fadelrio/Taller-de-circuitos/cuarto_check/Taller_de_Circuitos___Cuarto_Checkpoint.pdf

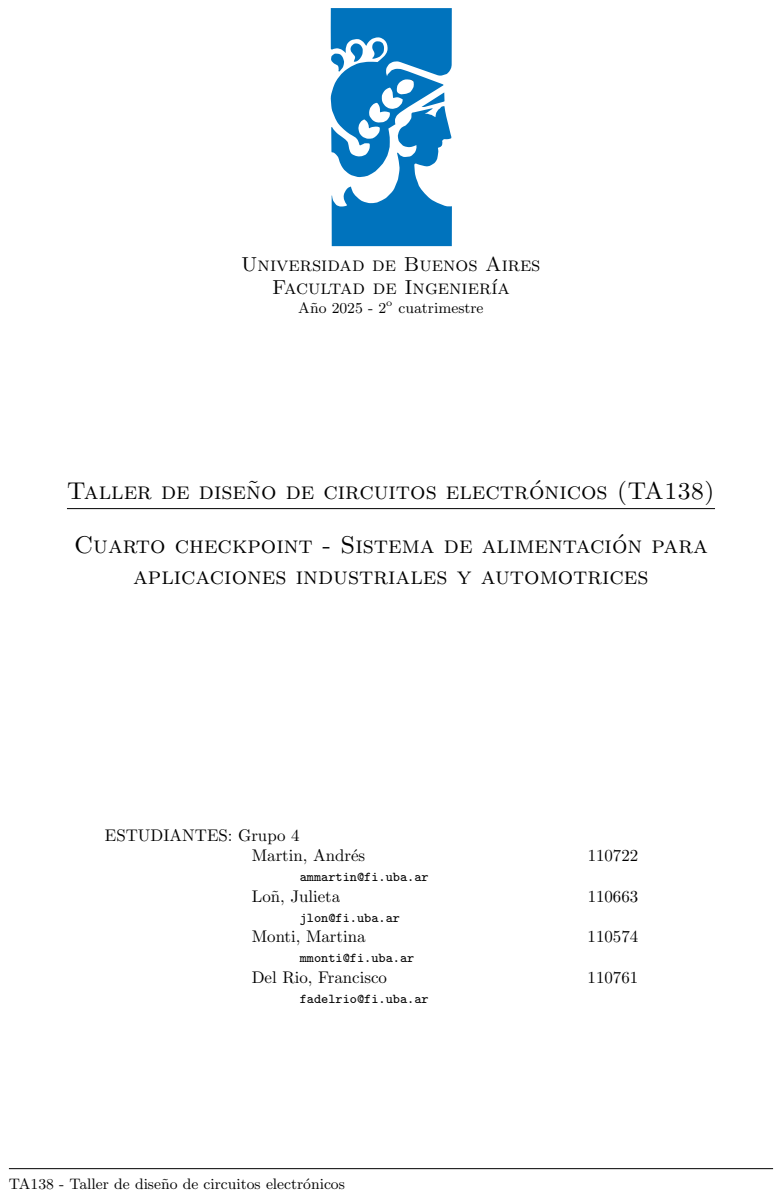
[picture p42: page 1]
cuatrimestre; Taller de diseno de circuitos electr ˜; onicos (TA138) ´; ESTUDIANTES: Grupo 4; Martin, Andrés; Loñ, Julieta; Monti, Martina; Del Rio, Francisco

Universidad de Buenos Aires

Facultad de Ingeniería

Cuarto checkpoint - Sistema de alimentacion para ´

aplicaciones industriales y automotrices

ammartin@fi.uba.ar

jlon@fi.uba.ar

mmonti@fi.uba.ar

fadelrio@fi.uba.ar

TA138 - Taller de diseño de circuitos electrónicos

TA138 - Segundo checkpoint | ÍNDICE

## Índice

1. Introducción | 2
2. Fuente buck | 2
3. Circuito PWM | 6
4. Conclusiones | 10
5. Apéndice | 11

1 Introducción | TA138 - Segundo checkpoint

## 1. Introducción

En esta entrega se realizara el diseño de la fuente buck y el circuito PWM. Para la fuente buck se deben realizar los cálculos necesarios para obtener las características físicas del inductor que se utilizara para implementar dicho circuito.
Ambos circuitos se deben diseñar teniendo en cuenta las especificaciones requeridas por el trabajo. La eficiencia para la fuente buck y la frecuencia para el PWM.

## 2. Fuente buck

### 2.1. Diseño y simulación

En las fuentes buck se busca reducir la tensión de entrada a un nivel inferior en la salida, manteniendo la alta eficiencia. Para ello se utilizan distintos componentes. Un MOSFET canal N (IRFZ44N) es utilizado para actuar como interruptor controlado por PWM (debido a este comportamiento de ”llave”, la tensión Drain-Source de este MOSFET es muy baja); el segundo NMOS (IRFZ44N) conduce la corriente cuando el primer transistor se encuentra apagado, implementando de esta manera las llaves ideales vistas en el circuito teórico.
También se agregan capacitores para evitar picos de tensión. El circuito cuenta además con un inductor, el cual almacena energía y suaviza la corriente. Este inductor debe calcularse con precisión para evitar sobrecalentamientos, tener tiempos de respuesta acordes y otros factores; es por esto que se le dedicará toda una sección a su diseño.
Para obtener el valor de la inductancia primero se calculo el mínimo valor que puede tomar para que el circuito continúe funcionando de manera adecuada. Para eso se debió considerar el caso de mayor conmutación, en donde la resistencia de carga es máxima.

Rmax =

Vo

Is,min

Considerando que Vo = 9,5V y Is,max =0,1 A se obtiene Rmax = 95Ω. Luego, el inductor se calcula mediante la siguiente expresión.

Lcr =

(1 − D)Rmax
2f

(1)

Considerando que se va a tener un Dmin y un Dmax dependiendo de la Vin se calcularon ambos:

Dmax =

Vo + Vds2

Vin − Vds1 + Vds2

=

9,5 + 0,049
12
= 0,7957 | (2)

Dmin =

Vo + Vds2

Vin − Vds1 + Vds2

=

9,5 + 0,049
30
= 0,3183 | (3)

Se calcularon dos valores de Lcr y se utilizó el más alto de ambos que es el que cumple con lo pedido y presenta el peor caso para el inductor critico. De las cuentas se obtuvo Lcr =250 µH. Sin embargo, se decidió utilizar un inductor L = 300 µH para mayor seguridad y evitar que variaciones en el valor real del inductor presenten problemas graves en el circuito implementado.
El valor del capacitor de salida se debe calcular considerando el ripple, por lo tanto el valor se calculo de manera iterativa. Se decidió un valor inicial de 100 µF y se observo el valor del ripple con ese valor para luego poder aplicar la siguiente expresión:

∆Vo =

IL,max − IL,min
8Cf | (4)

Con un capacitor de 47 µF se obtiene un ∆Vo =2,5 mV que cumple con los requisitos de tension de salida.
Una vez finalizado todo el desarrollo del circuito se consiguió el siguiente diseño.

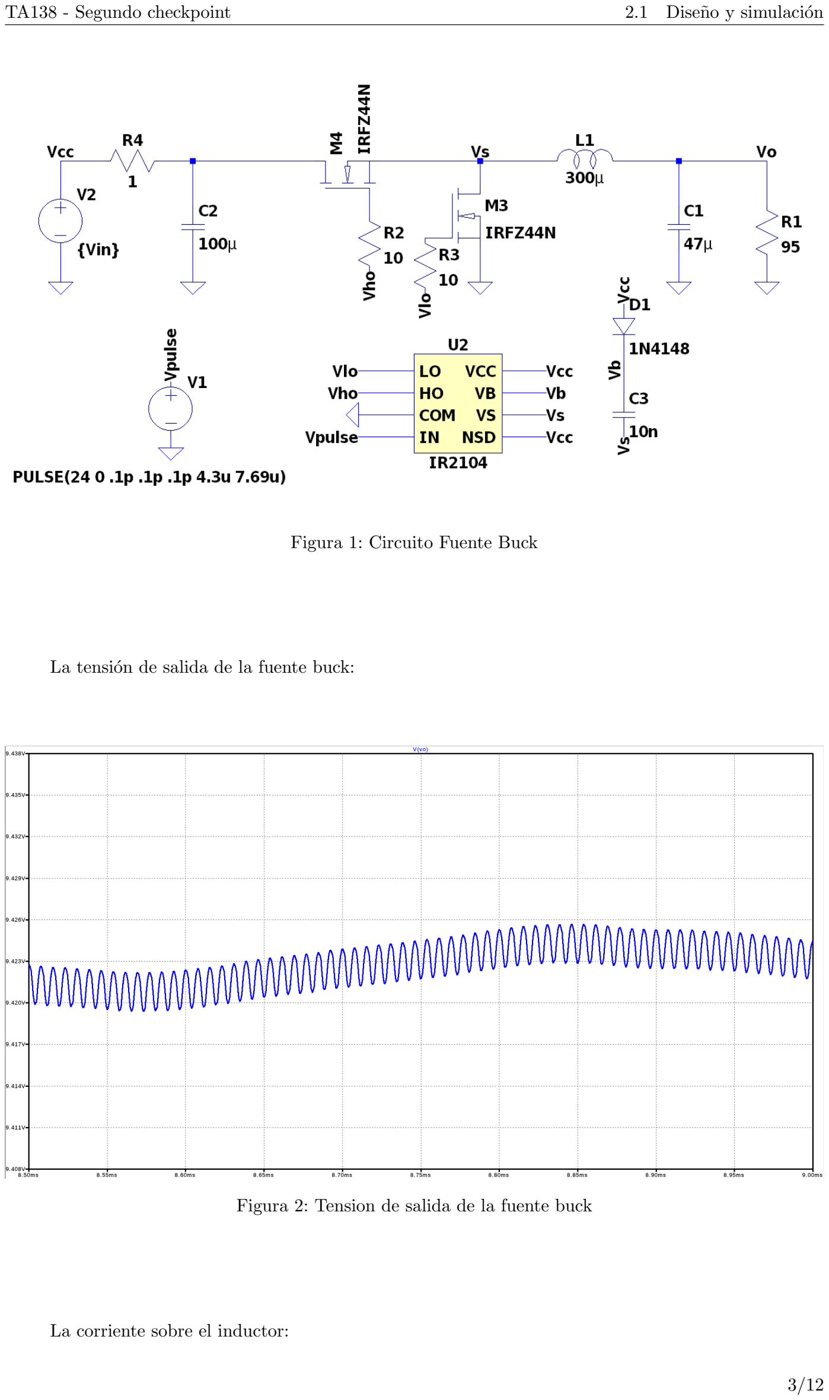
[picture p43: page 4]

TA138 - Segundo checkpoint | 2.1 Diseño y simulación

Figura 1: Circuito Fuente Buck

La tensión de salida de la fuente buck:

Figura 2: Tension de salida de la fuente buck

La corriente sobre el inductor:

2.2 Inductor | TA138 - Segundo checkpoint


Figura 3: Corriente sobre el inductor

En la Figura 2 se puede ver que, además de la oscilación, el valor medio no es constante, esto se atribuye a la necesidad de agrandar el error de convergencia admitido para asegurarse esta misma.

### 2.2. Inductor

Al momento de diseñar el inductor se debieron tener en cuenta ciertos parámetros de funcionamiento de la fuente buck. La frecuencia trabajo es de 130 kHz, la ILmax = 1,54A, la ILmin = 1,42A.
Se obtuvieron las características físicas del inductor usando el método Tacca. Se debe considerar σIL ≤ 5

A
mm² para evitar el sobrecalentamiento del alambre. Considerando los núcleos disponibles comercialmente y la tabla de cables provista por Ericksson, se realizaron los cálculos necesarios para obtener los siguientes parámetros.
Parámetros | Valor
Material del nucleo | N87
Nucleo | EE3007
Cable de cobre | AWG#20
Inductancia [µHy] | 300
lg [mm] | 0.151
Numero de vueltas | 25
σIL[ mm² ] A | 2.978
rCu [cm] | 0.0437
δ [cm] | 0.021

Cuadro 2.1: Especificaciones del inductor

Con los valores obtenidos no hay efecto pelicular.

### 2.3. Eficiencia

En los reguladores conmutados Buck una eficiencia ideal sería del 100 %. Sin embargo, esta eficiencia resulta imposible en la realidad debido a perdidas por conmutación, resistencias parasitas, caídas en el MOSFET, entre otros factores. Debido a esto, la eficiencia real estará alrededor del 90 % − 95 %. Esta eficiencia aumentará dependiendo de la optimización del PCB, un control preciso del ciclo de trabajo y un MOSFET acorde.

TA138 - Segundo checkpoint | 2.4 Diseño de PCB

En el caso del circuito diseñado, al utilizar un MOSFET como reemplazo del diodo para la conmutación, se logra una reducción en la caída de tensión. Además, la elección del inductor y el capacitor logran una gran reducción en el ripple de corriente y tensión respectivamente, lo que mejora la eficiencia.

La eficiencia del circuito se obtiene segun la siguiente expresión:

ef iciencia =

Psalida

Pentrada

(5)

η(9,3V ) = 9,3 ∗ 1,469
24 ∗ 0,00631
= 90,2 % | (6)

η(9,7V ) = 9,7 ∗ 0,103
24 ∗ 0,045
= 91,5 % | (7)

Ambos resultados cumplen con la eficiencia pedida para ambas tensiones especificadas del regulador buck.

### 2.4. Diseño de PCB

Para realizar el PCB de la fuente buck debió tenerse en cuenta el trazado de pistas. Aquí se tuvo en cuenta la separación entre ellas para así evitar capacitancias o inductancias parásitas. Además se debió mantener un cierto ancho de las pistas debido a la potencia que circula en ciertas zonas. Se planeó previamente el plano de masa para así mejorar el retorno de la corriente y reducir ruido. Teniendo todas estas cuestiones en consideración se obtuvo el siguiente diseño.

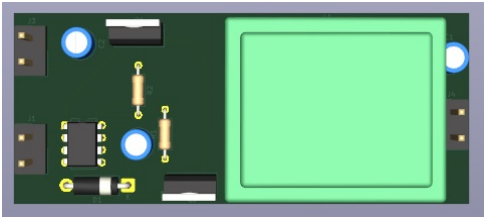
[picture p44: figure]

Figura 4: Diseño PCB frente Fuente Buck

3 Circuito PWM | TA138 - Segundo checkpoint


Figura 5: Diseño PCB dorso Fuente Buck

## 3. Circuito PWM

Como se mencionó antes, para la fuente buck se necesita una señal PWM que se ocupará de encender y apagar los MOSFETs. La forma de obtener tal señal utilizada es mediante la comparación de una señal triangular de 130 khz con una tensión constante. La ventaja de obtener la señal PWM de esta forma es que la tensión constante que se compara con la señal triangular podrá ser una señal proporcional a el error de la tensión de salida con la tensión deseada, de esta forma cerrando el lazo y obteniendo una fuente buck a lazo cerrado.

### 3.1. Diseño y simulación

La topología utilizada para obtener la señal deseada es la de la Figura 12. Este circuito consta de un integrador con el operacional U3 y el capacitor, que recibe una señal cuadrada de la salida de U1, generando la triangular deseada, que luego se compara con V3 en U3, para finalmente tener la señal PWM deseada. Dado la alta frecuencia de oscilación utilizada, U1 y U3 son comparadores en vez de amplificadores operacionales.

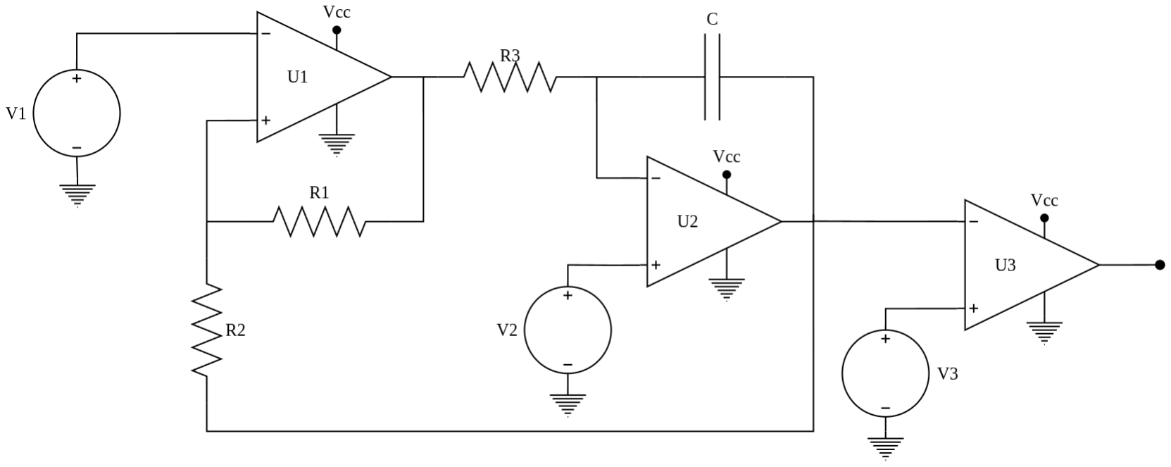
[picture p45: figure]

Figura 6: Circuito utilizado para generar la señal PWM

Los valores utilizados para los resistores y capacitores son los presentados en la Tabla 3.1. Los

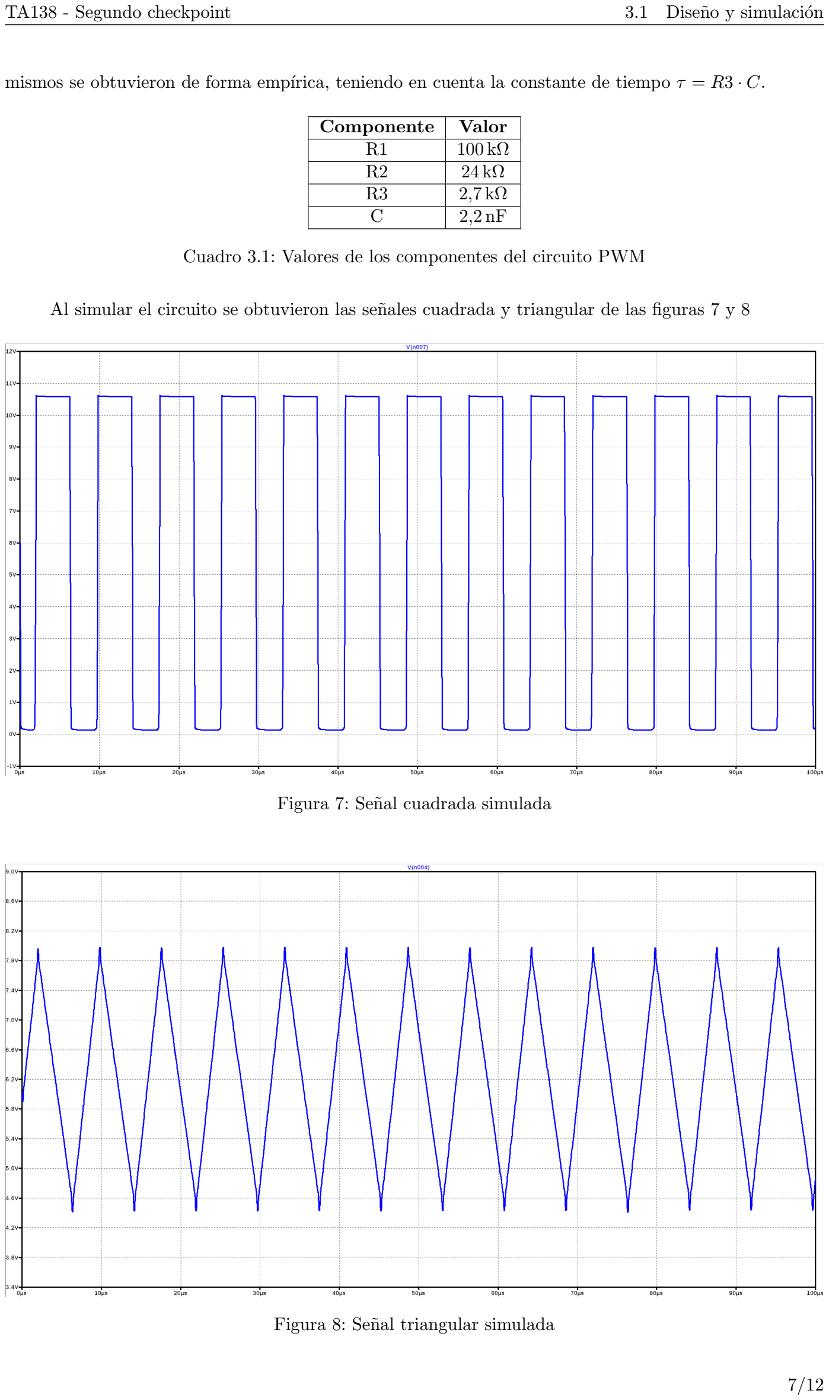
[picture p46: page 8]

TA138 - Segundo checkpoint | 3.1 Diseño y simulación

mismos se obtuvieron de forma empírica, teniendo en cuenta la constante de tiempo τ = R3 · C.

Componente | Valor
R1 | 100 kΩ
R2 | 24 kΩ
R3 | 2,7 kΩ
C | 2,2 nF

Cuadro 3.1: Valores de los componentes del circuito PWM

Al simular el circuito se obtuvieron las señales cuadrada y triangular de las figuras 7 y 8

Figura 7: Señal cuadrada simulada

Figura 8: Señal triangular simulada

3.2 Diseño de PCB | TA138 - Segundo checkpoint

### 3.2. Diseño de PCB


Figura 9: Circuito PCB PWM


Figura 10: Circuito PCB PWM

Al momento de realizar el diseño del PCB se debieron tener en cuenta las consideraciones nombradas anteriormente. Ademas se tuvo presente que las pistas debían evitar recorridos de gran distancia ya que al transportar frecuencia si estas son muy largas se puede generar ruido en la información.
Se agregaron pines de prueba al circuito en lugares estratégicos para luego poder verificar el funcionamiento del circuito, pudiendo observar la señal en donde es necesario que cumplan con formas y frecuencias especificas. Por lo tanto los pines agregados son en tierra, en la salida del comparador y en la salida del integrador.
Ademas como los comparadores son open collector se agregaron resistencias de pull up conectadas a su salida. Se eligió el valor teniendo en cuenta lo recomendado por la datasheet del modelo y buscando evitar que se limite la corriente.

TA138 - Segundo checkpoint | 3.3 Mediciones


Figura 11: Circuito PWM

Figura 12: Circuito PWM

Durante la implementación se observo que el valor de capacitancia elegido inicialmente era muy cercano al del capacitor interno del operacional y por lo tanto se deformaba la señal. Para solucionarlo se cambio la relación del RC, se aumento el valor del capacitor y se disminuyo el de la resistencia.

### 3.3. Mediciones

Al llevar a cabo las mediciones, se observó la señal cuadrada generada por el circuito a una frecuencia aproximada de 130kHz, tal como fue diseñada. Esta señal presenta transiciones rápidas por lo que se garantiza una conmutación correcta y eficiente de los MOSFETs en la fuente Buck. La amplitud de la señal se mantiene estable en el tiempo, sin ningún tipo de distorciones.
Ppor otro lado, la señal triangular muestra una forma simétrica y estable con una amplitud adecuada. Se observó que la frecuencia de oscilación también es de aproximadamente 130KHz.
Con estas mediciones se puede confirmar el correcto funcionamiento del PWM, asegurando asi una señal de control para la fuente conmutada Buck estable cumpliendo todos los requisitos.

4 Conclusiones | TA138 - Segundo checkpoint

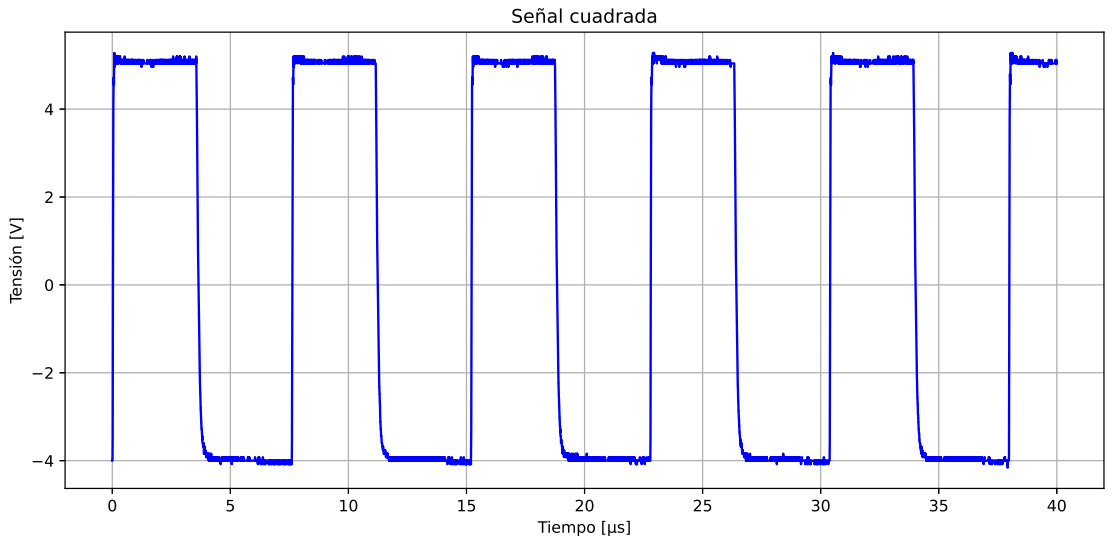
[picture p47: figure]

Figura 13: Señal cuadrada

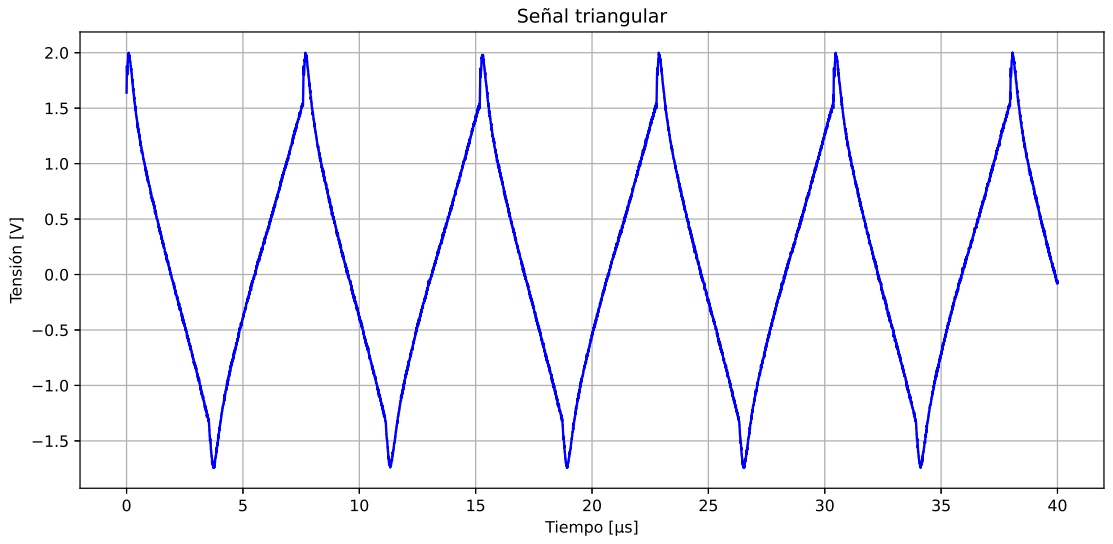
[picture p48: figure]

Figura 14: Señal triangular

## 4. Conclusiones

A lo largo del desarrollo se abordó el diseño y simulación de una fuente conmutada tipo Buck, donde se debió trabajar el control por modulación de ancho de pulso y el diseño físico del inductor. Durante la simulación, se observo que esta fuente Buck cumplió los requerimientos, superando el 90 % de eficiencia en distintas condiciones de carga, manteniendo a su vez un tiempo de establecimiento y un ripple acorde.
Se puso en práctica el diseño de pistas para circuitos de frecuencia, en donde se tuvo que considerar el trazado de pistas y el plano de masa. El diseño del circuito PWM se implementó mediante comparadores, logrando generar, luego de varios intentos, una señal triangular estable y una señal PWM capaz de controlar los MOSFETs.

TA138 - Segundo checkpoint | 5 Apéndice

## 5. Apéndice

### 5.1. Calculo del inductor

Se utilizaron las siguientes especificaciones para realizar los cálculos:

L = 300 µH

IL,max = 1,54 A
IL,dc = 1,48 A
fsw = 130 kHz
Pcu = 1W
Ku = 0,33
ρcu = 1,7 · 10⁻⁶ Ω cm

El campo magnético máximo se obtuvo de la hoja de datos del material observando el máximo valor donde la permeabilidad tiene un comportamiento lineal.Luego, los valores de corriente máxima y media fueron obtenidos cuando la carga es mínima RLmin =

9V

1,5A = 6,33Ω
El método Tacca indica que en primer lugar se debe calcular la sección de hierro, Sf e.

Fb = Ku
Fv = 0,25

IL,ef = IL,dc

σIL = 5

A
mm²

Sf e = 10r
LIL,ef IL,max

FbFvBmaxσIL

= 0,744cm²
(8)

Verificando la tabla provista por Ericksson y la disponiblidad comercial, se decidio usar el nucleo EE3007. Una vez decidido el nucleo es necesario verificar el valor del facotr de ventana, Fv, elegido. Para eso se utilizo la datasheet del nucleo para obtener las dimensiones de la pieza.

B = 19,6 mm
C = 9,5 mm
D = 6,5 mm
E = 6,3 mm
F = 6,3 mm

Fv =

Sv
Sf e

=

E(B − C)
2CD | = 0,35 | (9)

Considerando este valor se volvió a calcular la sección del hierro, Sf e = 0,629 cm²
| | . La variación es
pequeña por lo que la elección del nucleo continua cumpliendo.
Se procedió a calcular el valor del entrehierro.

12

L
Sf e

(

IL,max

Bmax

)

2 = 0,151 mm | (10)

Obtenido este valor, se pudo conseguir el numero de vueltas necesarias para el inductor.

n = 850

Bmax

IL,max

Ig = 25 | (11)

Wa = 0,476 cm²

5.1 Calculo del inductor | TA138 - Segundo checkpoint

Aw ≤

KuWa
n

= 6,283 · 10⁻³
cm²
(12)

Se elige usar el camble AWG#20 que tiene un Aw = 5,188 · 10⁻³ cm²
. Se verifica que el valor de la densidad sea menor a 5 A
mm² y que no sature

σIL =

IL,max
100Aw

= 2,789

A
mm²

Bmax,real =

µ0nIL,max
Ig

= 0,0003 T

Finalmente, se verifico que no haya efecto pelicular, es decir que δ ≤ rCu.

rCu = 0,0437 cm

δ =

7,5
√
fsw

= 0,021
