fadelrio/Taller-de-circuitos/segundo_check/Taller_de_circuitos-Segundo_checkpoint.pdf

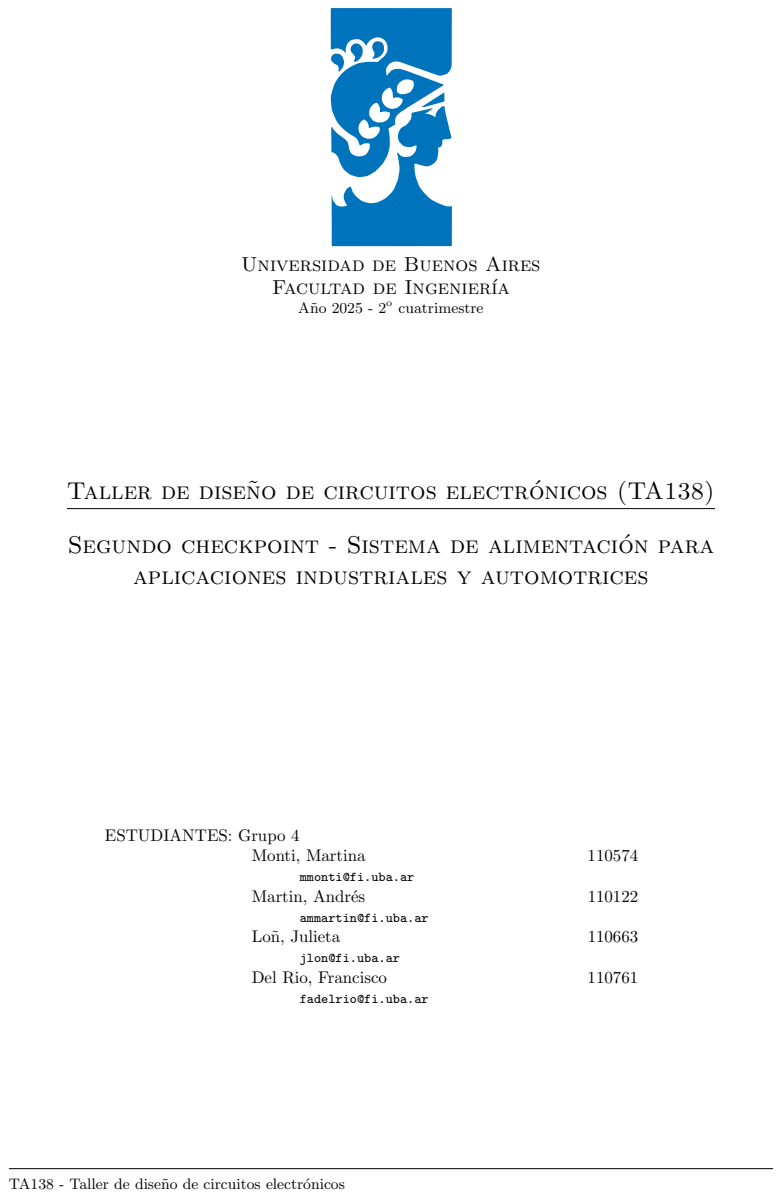
[picture p49: page 1]
cuatrimestre; Taller de diseno de circuitos electr ˜; onicos (TA138) ´; ESTUDIANTES: Grupo 4; Monti, Martina; Martin, Andrés; Loñ, Julieta; Del Rio, Francisco

Universidad de Buenos Aires

Facultad de Ingeniería

Segundo checkpoint - Sistema de alimentacion para ´

aplicaciones industriales y automotrices

mmonti@fi.uba.ar

ammartin@fi.uba.ar

jlon@fi.uba.ar

fadelrio@fi.uba.ar

TA138 - Taller de diseño de circuitos electrónicos

TA138 - Segundo checkpoint | ÍNDICE

## Índice

1. Introducción | 2
2. Compensación | 2
3. Diseño del PCB | 10
4. Análisis térmico | 11
5. Conclusión | 12

1 Introducción | TA138 - Segundo checkpoint

## 1. Introducción

Esta entrega se centrará en el análisis en frecuencia para el circuito presentado en la entrega anterior. El principal objetivo es asegurar la linealidad de la fuente para todas las frecuencias compensando el circuito, buscando así evitar oscilaciones y realimentaciones positivas no deseadas.

## 2. Compensación

### 2.1. Lazo de tensión

Analizando el comportamiento de la ganancia de lazo en frecuencia, se puede apreciar en las figuras 1 y 2 que el circuito presenta un margen de fase negativo para los limites de capacidad de carga. El margen de fase negativo implica que existe una frecuencia para la cual la fase se encuentra desplazada −180° respecto a la fase inicial y la ganancia es mayor a 0 dB, lo que implica que la realimentación se vuelva positiva, resultando en un comportamiento inestable.

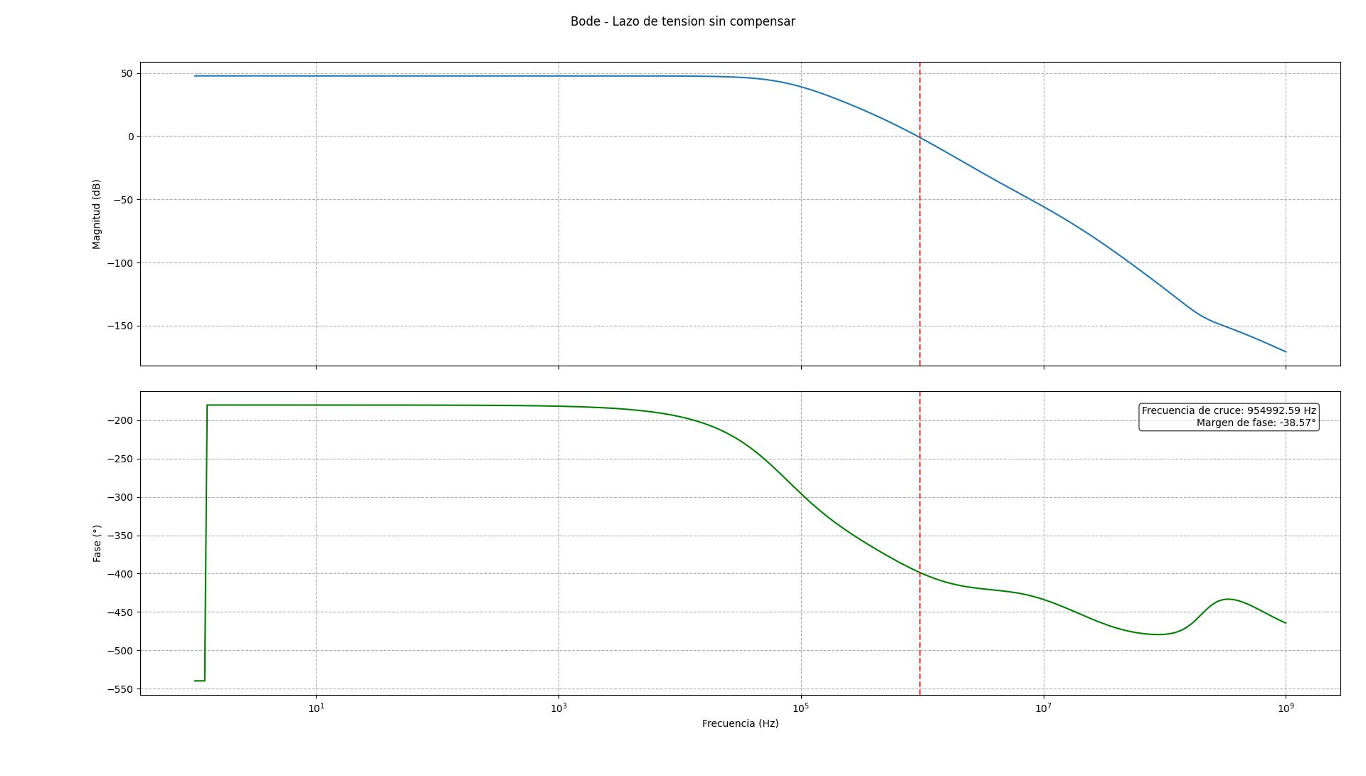
[picture p50: figure]

Figura 1: Diagrama de bode de T con capacidad de carga de 1 µF

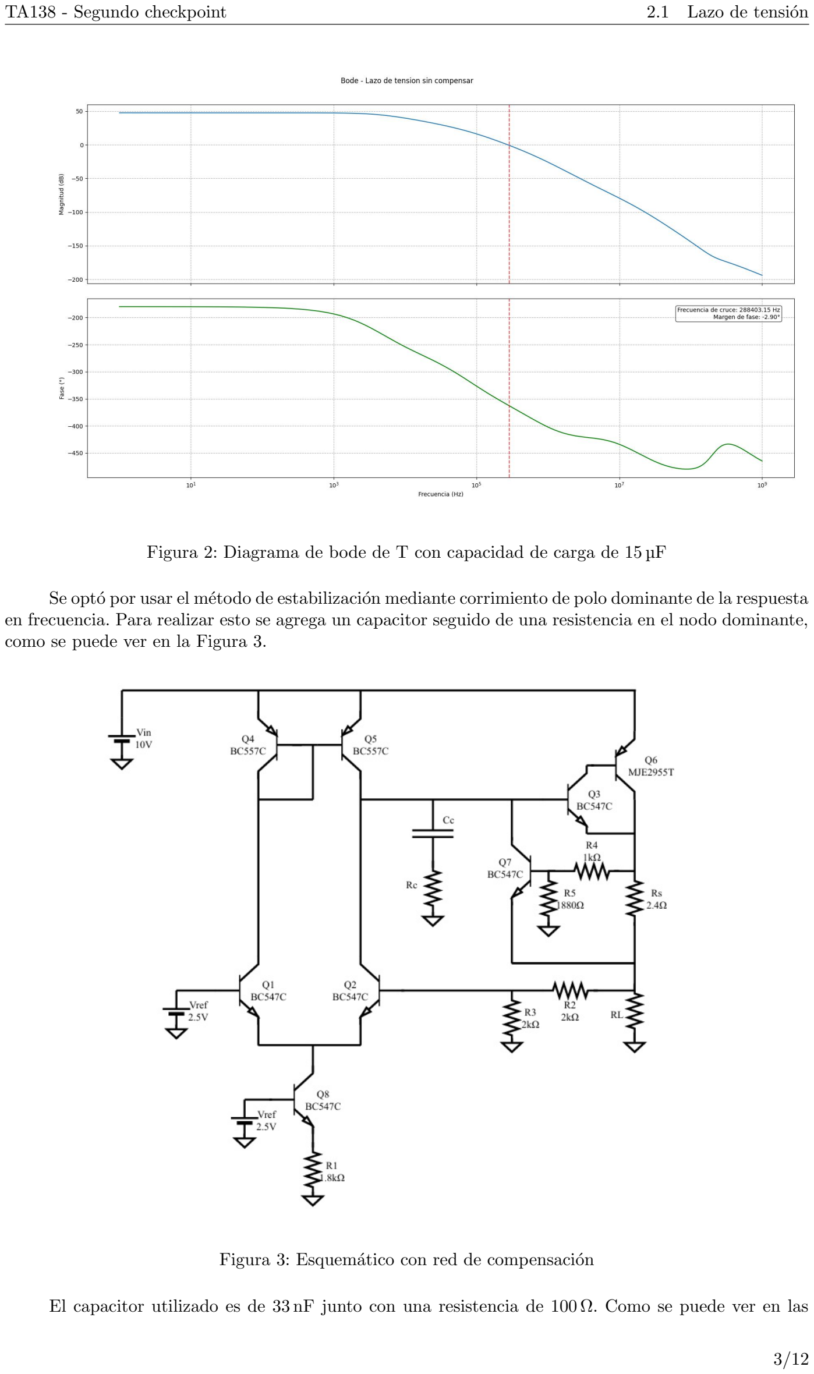
[picture p51: page 4]

TA138 - Segundo checkpoint | 2.1 Lazo de tensión

Figura 2: Diagrama de bode de T con capacidad de carga de 15 µF

Se optó por usar el método de estabilización mediante corrimiento de polo dominante de la respuesta en frecuencia. Para realizar esto se agrega un capacitor seguido de una resistencia en el nodo dominante, como se puede ver en la Figura 3.

Figura 3: Esquemático con red de compensación

El capacitor utilizado es de 33 nF junto con una resistencia de 100 Ω. Como se puede ver en las

2.2 Lazo de corriente | TA138 - Segundo checkpoint

Figuras 4 y 5, el margen de fase obtenido es, en el mejor caso de 103° y en el peor caso de 37°. De esta forma, se soluciona la posibilidad de inestabilidad mencionada al principio de la sección ya que, para la frecuencia a la que la fase se encuentra desplazada −180° respecto a la fase inicial, la ganancia es mucho menor a 0 dB

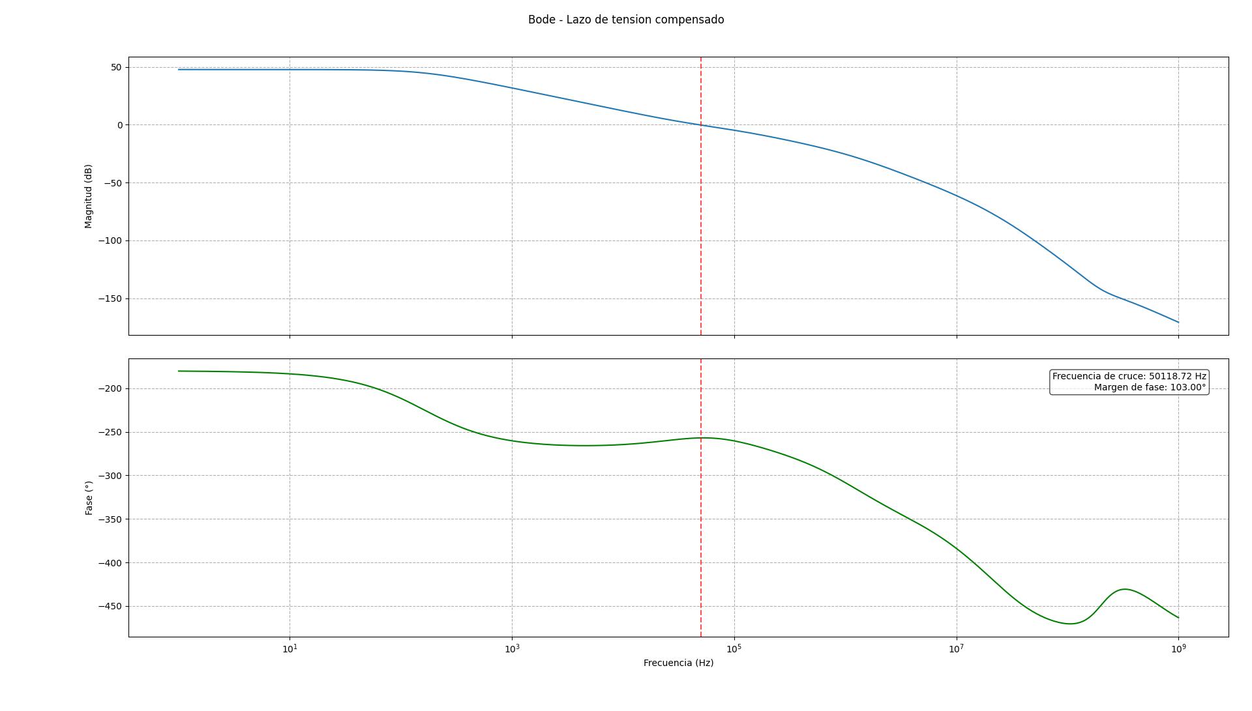
[picture p52: figure]

Figura 4: Diagrama de bode de T compensado, con capacidad de carga de 1 µF

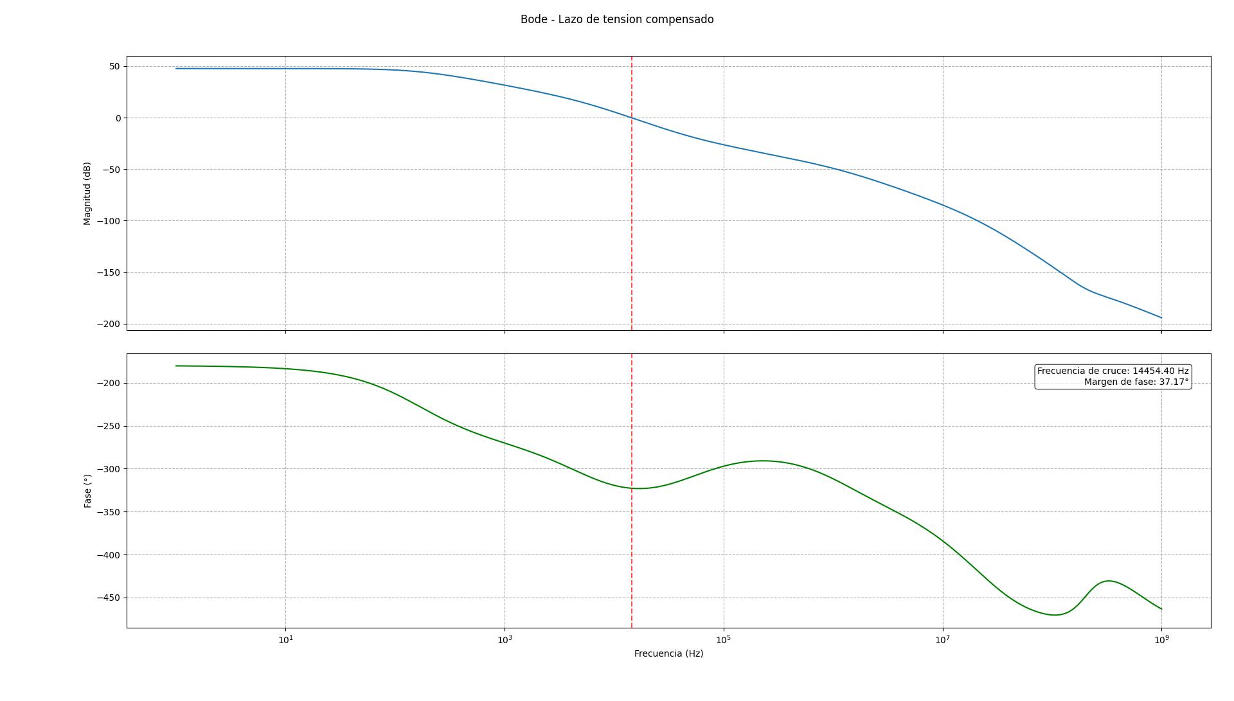
[picture p53: figure]

Figura 5: Diagrama de bode de T compensado, con capacidad de carga de 15 µF

### 2.2. Lazo de corriente

Otro aspecto del circuito en el que se debe analizar la estabilidad es el lazo de control de corriente, para esto se simuló la respuesta en frecuencia de la ganancia de lazo de corriente en los casos limites de

TA138 - Segundo checkpoint | 2.3 Respuestas al escalón

capacidad de carga, obteniendo los gráficos de las Figuras 6 y 7.

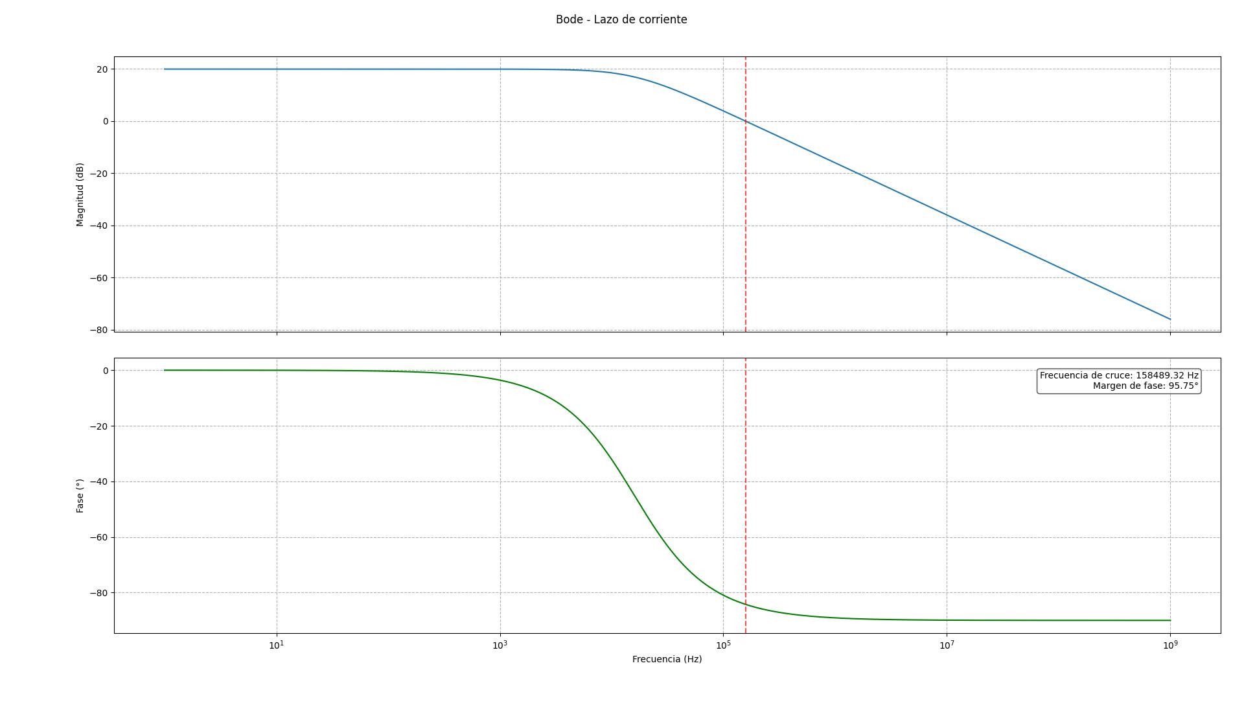
[picture p54: figure]

Figura 6: Lazo de corriente con capacidad de carga de 1 µF

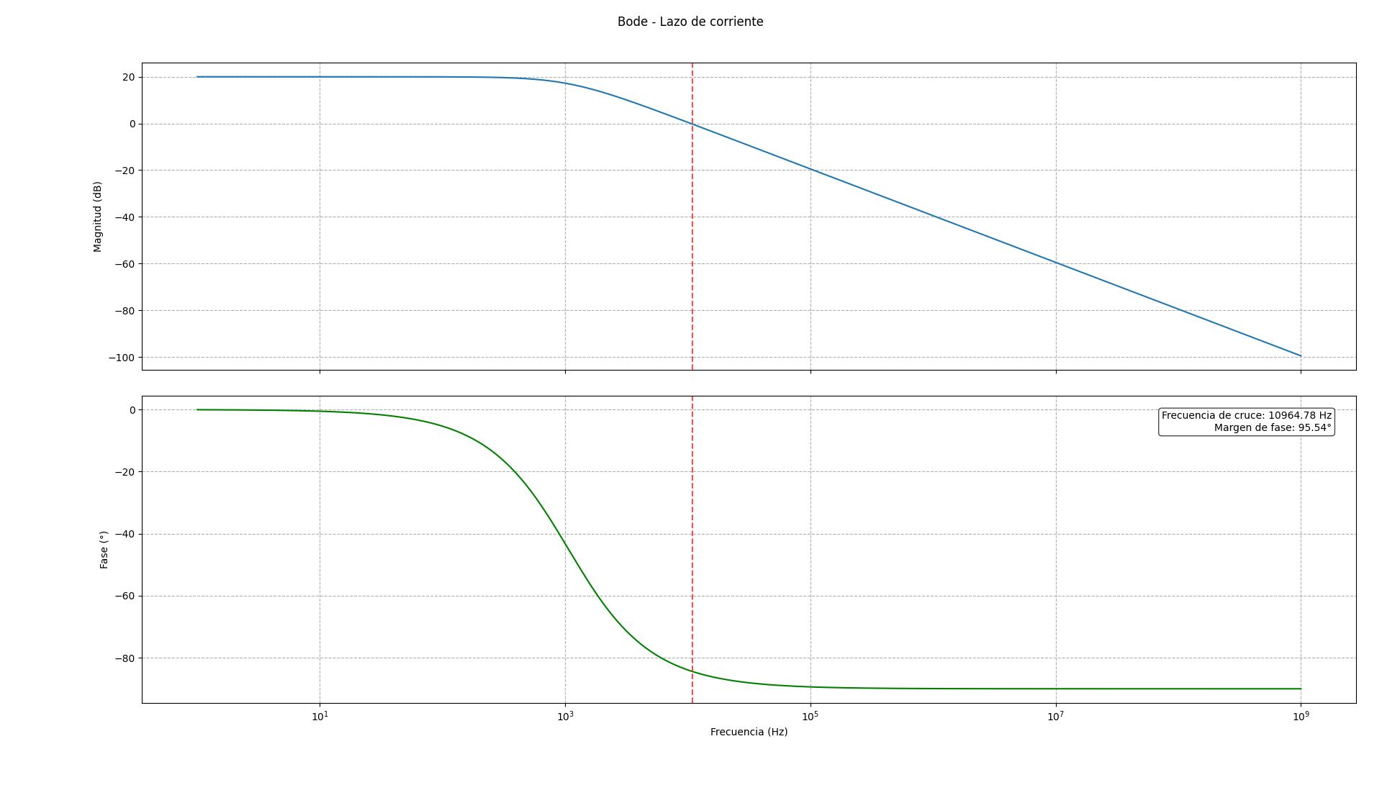
[picture p55: figure]

Figura 7: lazo de corriente con capacidad de carga de 15 µF

Como se puede ver, en ambos casos el circuito ya presenta un margen de fase lo suficientemente grande como para no tener compromisos de estabilidad. Por esto es que se optó por no compensar este lazo.

### 2.3. Respuestas al escalón

Además de las respuestas en frecuencia del circuito se analizaron las respuestas transitorias a perturbaciones de tipo escalón. Se simularon las respuestas a escalones sin compensar en la entrada, en la referencia y en la carga, en ambos limites de capacidad de carga. Se obtuvieron las siguientes figuras:

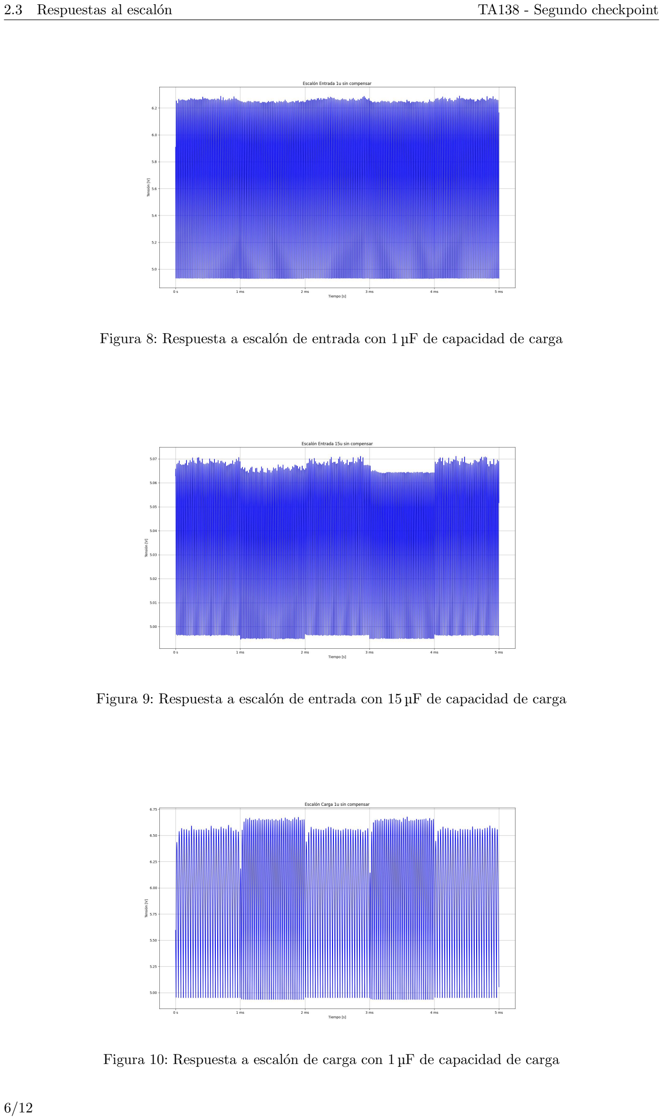
[picture p56: page 7]

2.3 Respuestas al escalón | TA138 - Segundo checkpoint

Figura 8: Respuesta a escalón de entrada con 1 µF de capacidad de carga

Figura 9: Respuesta a escalón de entrada con 15 µF de capacidad de carga

Figura 10: Respuesta a escalón de carga con 1 µF de capacidad de carga

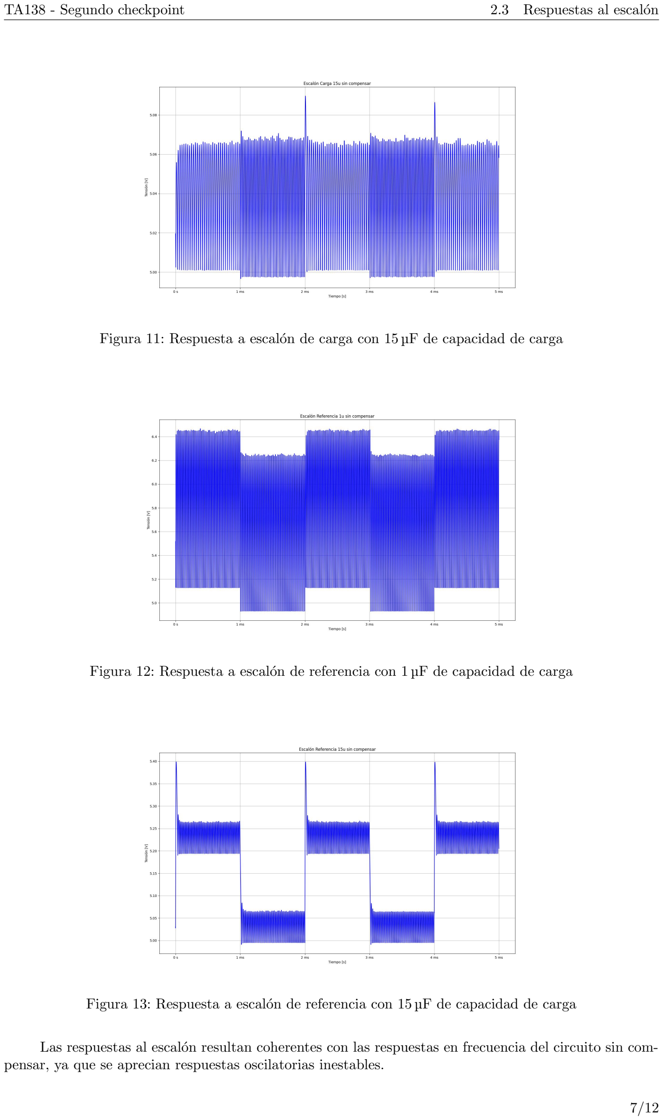
[picture p57: page 8]

TA138 - Segundo checkpoint | 2.3 Respuestas al escalón

Figura 11: Respuesta a escalón de carga con 15 µF de capacidad de carga

Figura 12: Respuesta a escalón de referencia con 1 µF de capacidad de carga

Figura 13: Respuesta a escalón de referencia con 15 µF de capacidad de carga

Las respuestas al escalón resultan coherentes con las respuestas en frecuencia del circuito sin compensar, ya que se aprecian respuestas oscilatorias inestables.

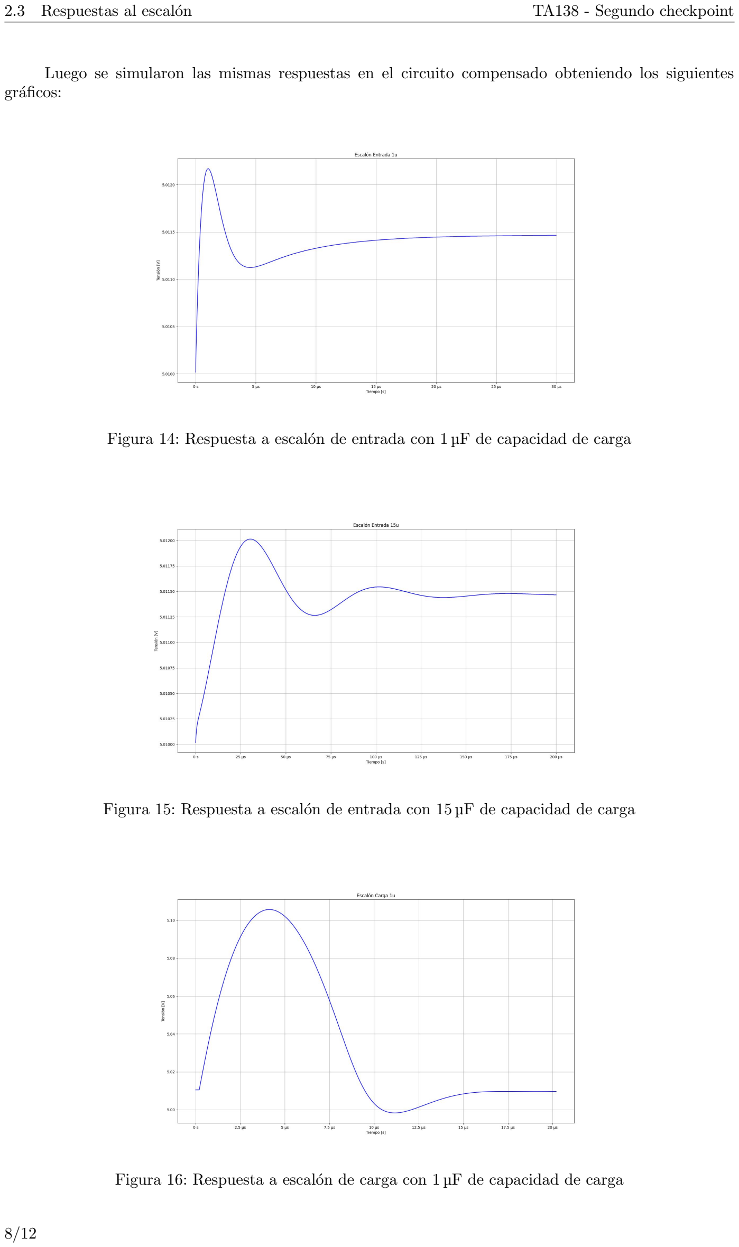
[picture p58: page 9]

2.3 Respuestas al escalón | TA138 - Segundo checkpoint

Luego se simularon las mismas respuestas en el circuito compensado obteniendo los siguientes gráficos:

Figura 14: Respuesta a escalón de entrada con 1 µF de capacidad de carga

Figura 15: Respuesta a escalón de entrada con 15 µF de capacidad de carga

Figura 16: Respuesta a escalón de carga con 1 µF de capacidad de carga

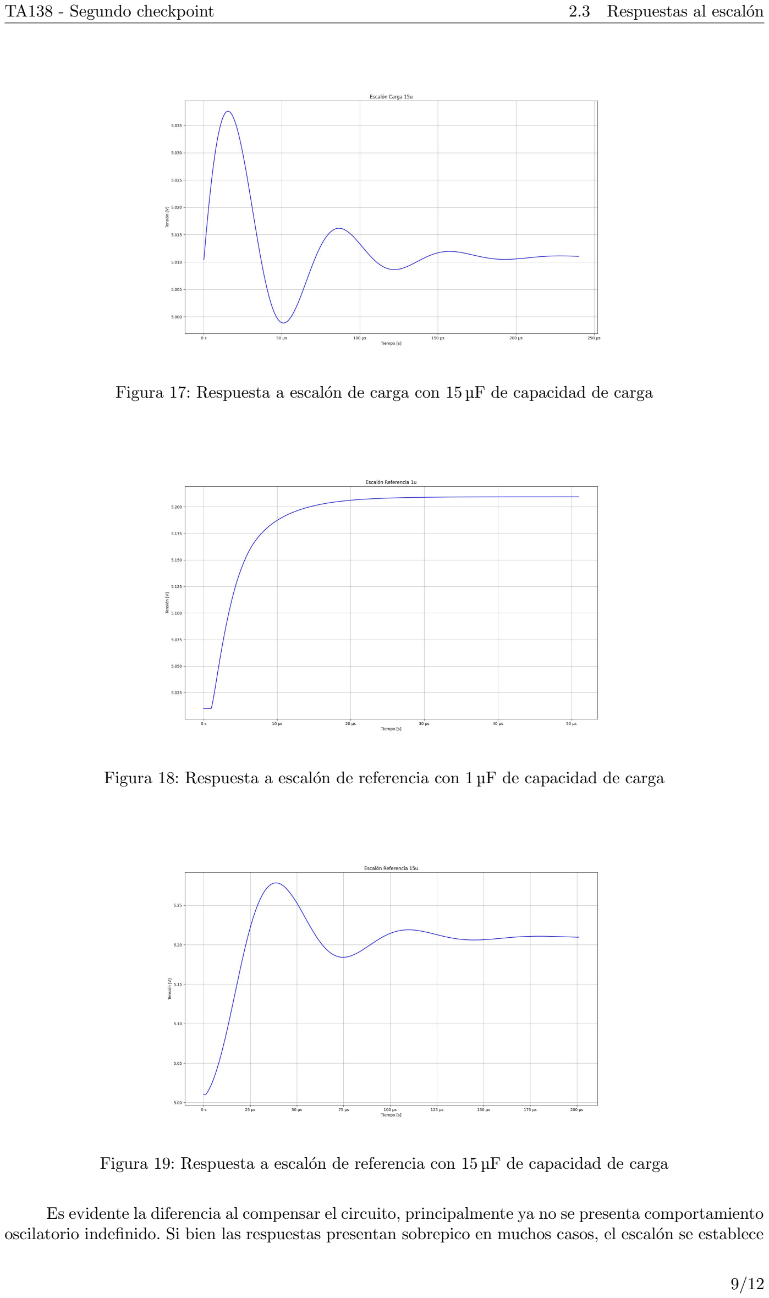
[picture p59: page 10]

TA138 - Segundo checkpoint | 2.3 Respuestas al escalón

Figura 17: Respuesta a escalón de carga con 15 µF de capacidad de carga

Figura 18: Respuesta a escalón de referencia con 1 µF de capacidad de carga

Figura 19: Respuesta a escalón de referencia con 15 µF de capacidad de carga

Es evidente la diferencia al compensar el circuito, principalmente ya no se presenta comportamiento oscilatorio indefinido. Si bien las respuestas presentan sobrepico en muchos casos, el escalón se establece

3 Diseño del PCB | TA138 - Segundo checkpoint

en el orden de las decenas de µs en los mejores casos y en el orden de las centenas de µs en los peores casos.

## 3. Diseño del PCB

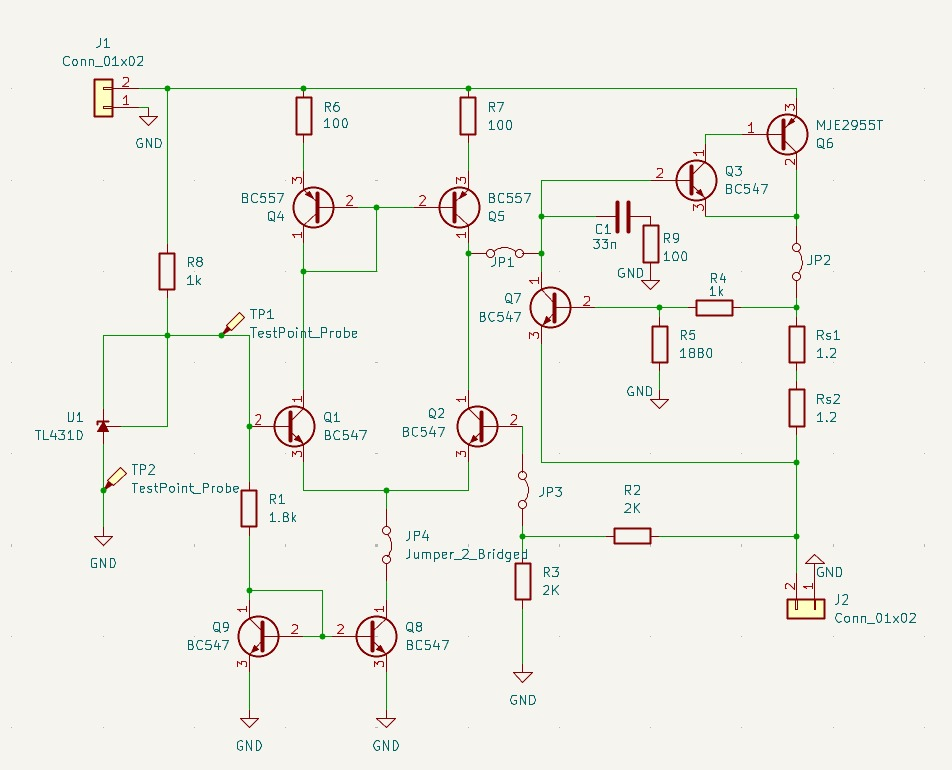
[picture p60: figure]

Figura 20: Esquemático de PCB

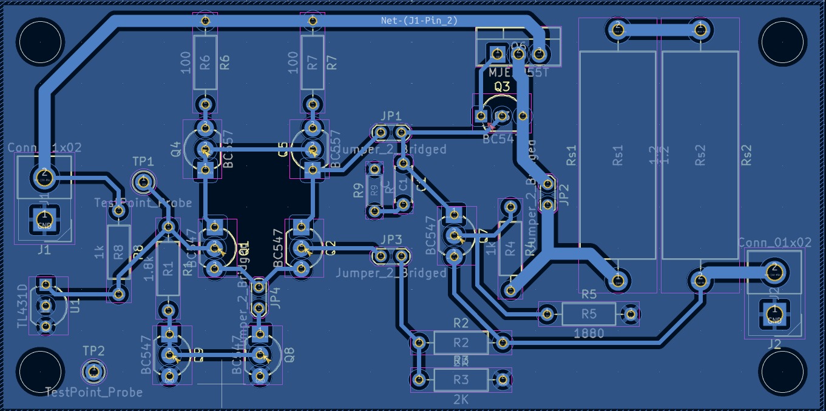
[picture p61: figure]

Figura 21: Placa PCB

La principal consideración al momento de diseñar la placa fue mantener separada la etapa de potencia del resto del circuito para evitar con mayor seguridad que haya alta potencia en donde pueda ser perjudicial. Además las pistas de esa etapa son de mayor tamaño- 1,5 mm- que permite que los altos niveles de corriente circulen sin problemas de sobrecalentamiento, evitando daños.
Se tuvo en cuenta que es importante evitar el ruido en el par diferencial, ya que cualquier señal diferencial entre las ramas sera amplificada a la salida de este. Por lo tanto se busco tener alejadas las

TA138 - Segundo checkpoint | 4 Análisis térmico

principales fuentes de ruido, la Vin y la etapa de potencia.
También se agregaron puntos de prueba en nodos estratégicos del circuito para luego poder medir y comprobar que el funcionamiento sea el esperado. Lo mismo se hizo con los jumpers ubicados de manera que se pueda seccionar el circuito según sea necesario.

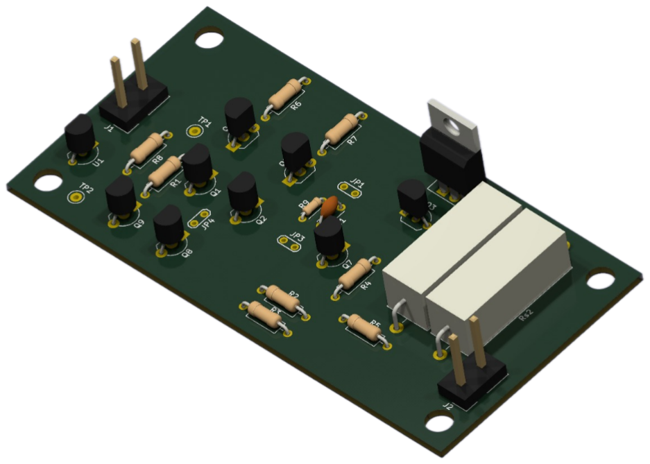
[picture p62: figure]

Figura 22: Vista 3D de placa PCB

## 4. Análisis térmico

Donde mayor potencia se disipa en el circuito es en el transistor de paso, como se vio en la primera entrega, razón por la cual se eligió un transistor de potencia. Sin embargo, cuando la tensión y corriente son máximas en el transistor, la potencia también lo es y por lo tanto hay que controlarla.
La forma de lograr lo dicho es con un disipador térmico. Se deben considerar las resistencias térmicas del dispositivo, teniendo en cuenta que cuanto menor es el valor de la resistencia, mejor disipa el calor.

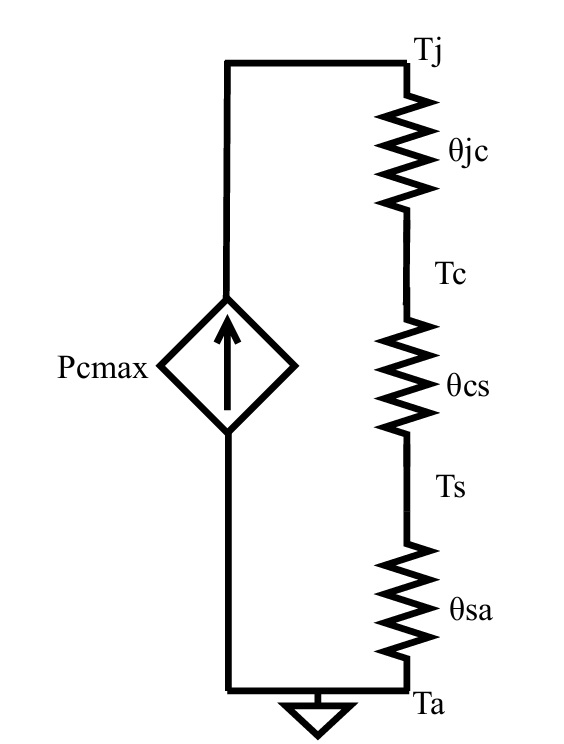
[picture p63: figure]

Figura 23: Circuito térmico

A partir del circuito se puede plantear la relación termica entre el ambiente y la juntura.

θja = θjc + θcs + θsa | (1)
De la hoja de datos se obtienen los datos de Tj = 150°C y θjc = 1, 67°C | W . La temperatura ambiente,
Ta = 50°C, se fija considerando que la temperatura en el circuito puede ser mas elevada que la del ambiente si se usa un gabinete. Finalmente, se aproxima θcs = 0°C
W por el uso de la pasta térmica.

5 Conclusión | TA138 - Segundo checkpoint

Para calcular θja se usa la expresión

θja =

Tj − Ta

Pcmax

(2)

El valor de la potencia máxima se calcula considerando que al regulador entran como máximo 9,5 V y la corriente máxima que circula por el transistor es 1,5 A, por lo tanto Pcmax = 7W.
Por precaución se considera el 80 % de la temperatura de juntura para no sobre exigir al componente, por lo tanto Tj = 120°C
Finalmente de la 1 se despeja el valor de θsa

θsa =

Tj − Ta

Pcmax

− θjc − θcs = 10

°C

W

− 1, 67

°C

W

= 8,33

°C

W

(3)

Considerando este valor se busco entre los valores comerciales disponibles y se opto por el disipador D-6225T. Este tiene una resistencia térmica de 8,80

◦C
W . Si bien el valor es levemente mayor al calculado, se considera que esa diferencia es despreciable debido al gran margen que se tomo al obtener los valores.

## 5. Conclusión

Durante el desarrollo de este proyecto se pudo compensar el circuito para evitar oscilaciones a ciertas frecuencias y lograr un margen de fase mayor a los 45°. Esto pudo realizarse tanto para el lazo de corriente como para el lazo de tensión. Para el lazo de tensión se debió de utilizar un capacitor en serie con una resistencia para cumplir el objetivo. Mientras que, el lazo de corriente ya cumplía con el margen de fase mayor a 45° por lo que no se debió realizar modificación alguna sobre el circuito.
Se diseño una placa PCB para poder implementar lo diseñado por medio de simulaciones. Además se realizo la renderización en 3D para poder observar la distribución final del circuito.
Los cálculos realizados para obtener el valor de la resistencia térmica necesaria permitieron encontrar un disipador comercial que cumpla con los requisitos. De esta manera se logro asegurar que la potencia necesaria para el funcionamiento del circuito no genere daños en el mismo.
