fadelrio/Taller-de-circuitos/quinto_check/graficos/grafico_reglin.pdf

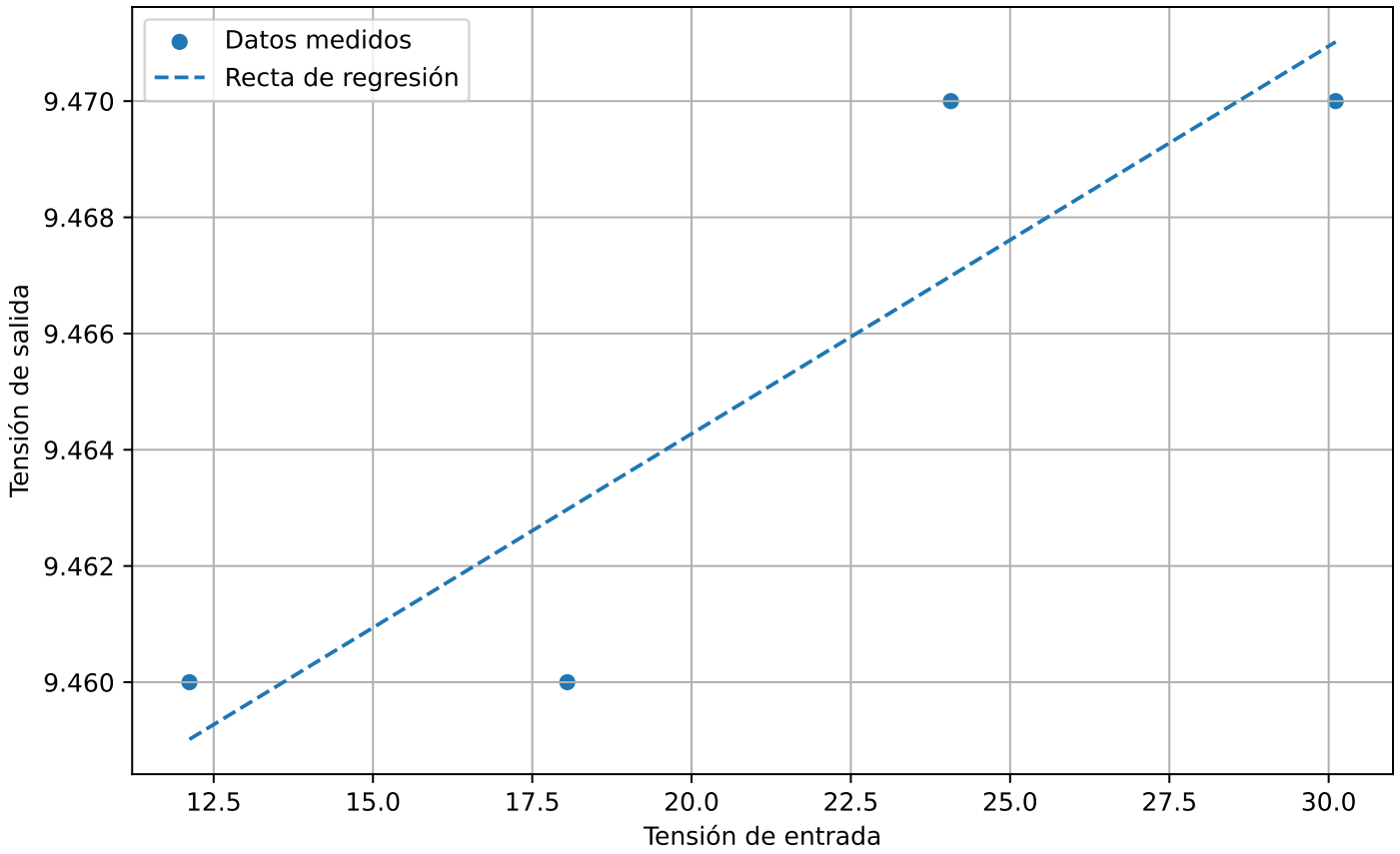
[picture p99: figure]
Tensión de entrada; Tensión de salida; Datos medidos Recta de regresión
