fadelrio/Taller-de-circuitos/quinto_check/graficos/grafico_respuesta_compensada.pdf

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

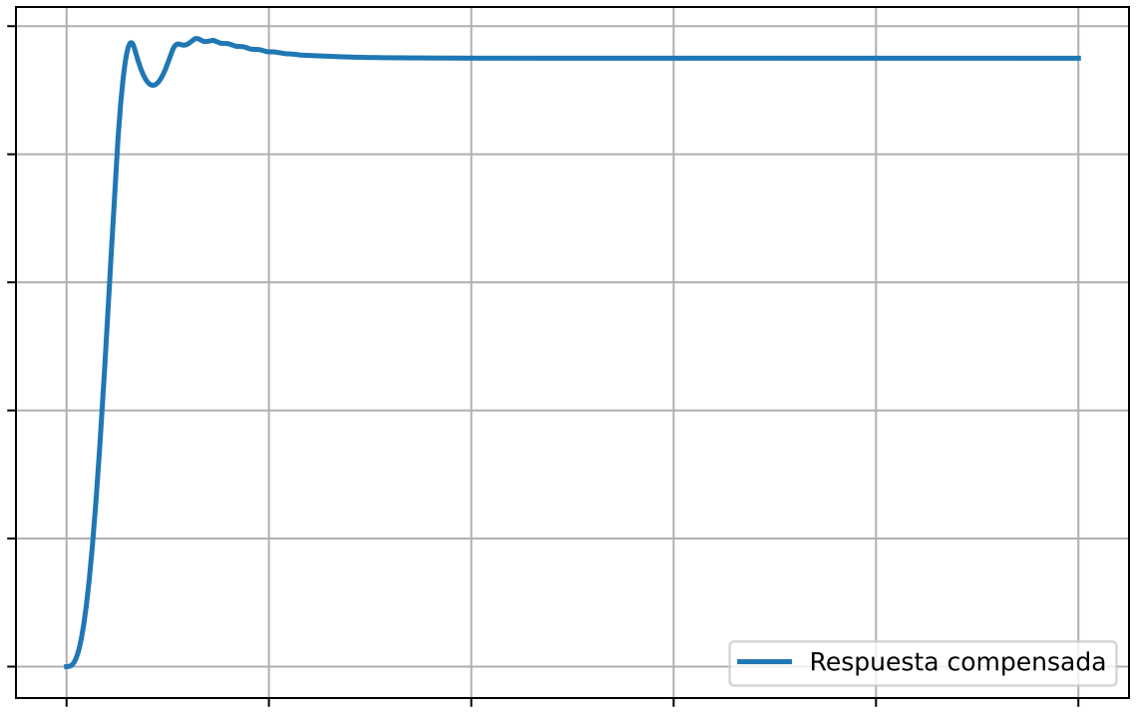
[picture p100: figure]
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
