fadelrio/Taller-de-circuitos/quinto_check/Taller_de_Circuitos_Quinto_Checkpoint/res/bode_sin_comp.pdf

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

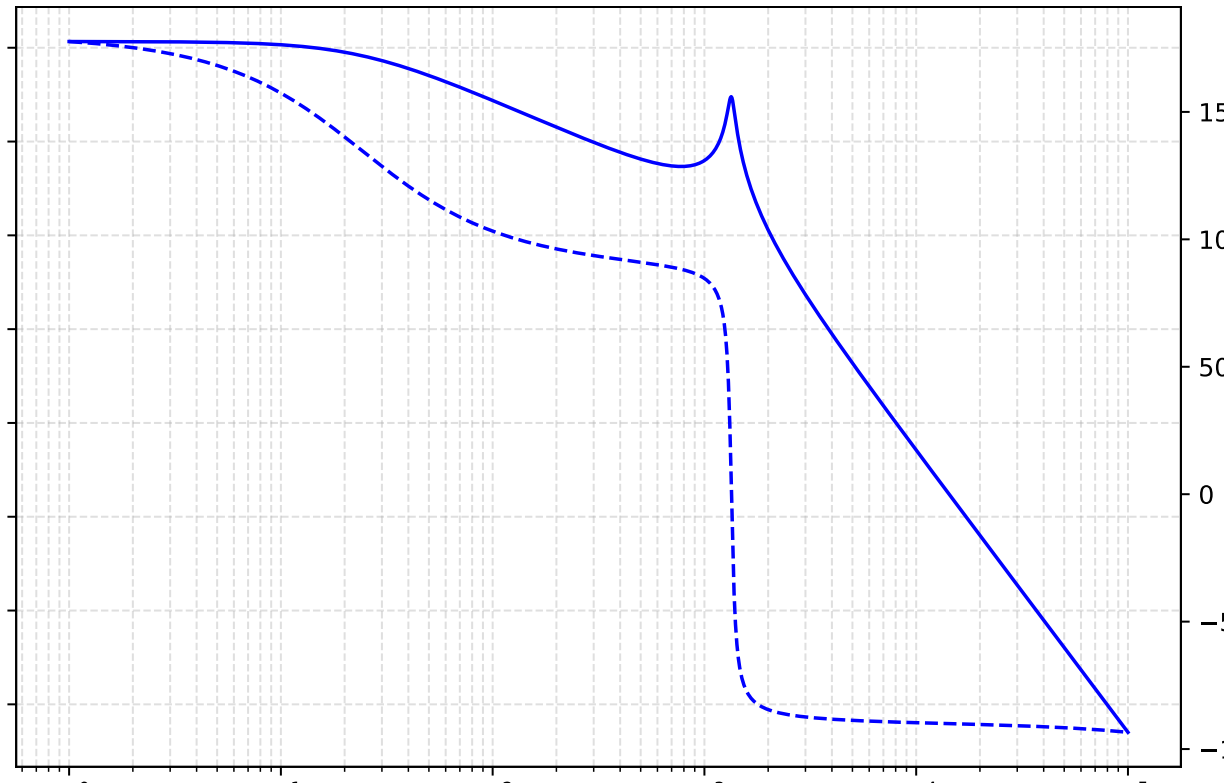
[picture p101: figure]
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
