fadelrio/Taller-de-circuitos/cuarto_check/Taller_de_Circuitos___Cuarto_Checkpoint/res/diseno_buck.jpg

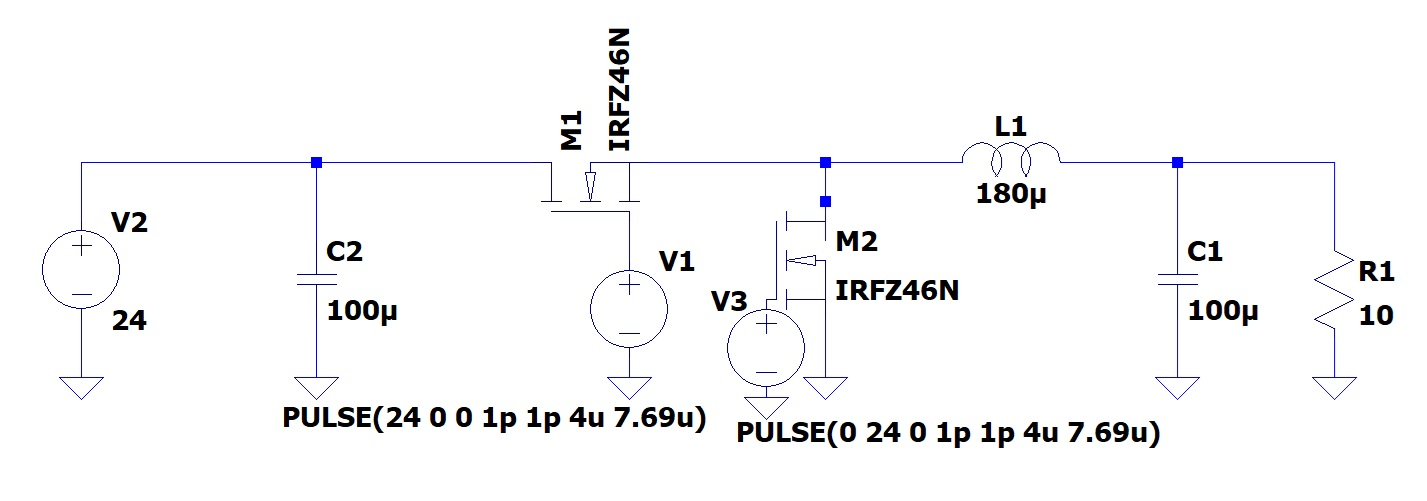
cuarto_check/Taller_de_Circuitos___Cuarto_Checkpoint/res/diseno_buck.jpg
