fadelrio/Taller-de-circuitos/cuarto_check/Taller_de_Circuitos___Cuarto_Checkpoint/res/esquema_carga_electronica.png

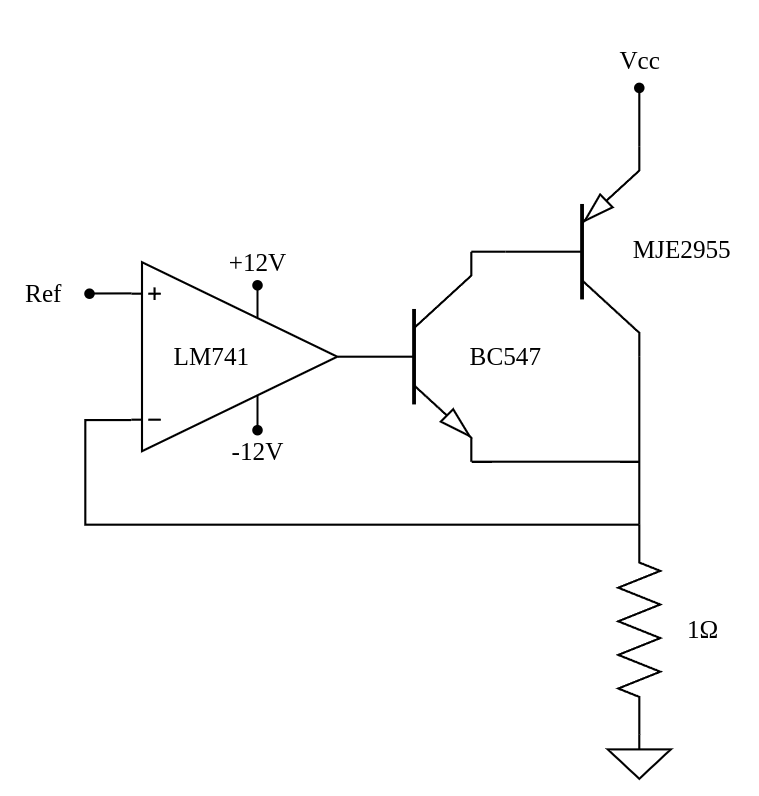
cuarto_check/Taller_de_Circuitos___Cuarto_Checkpoint/res/esquema_carga_electronica.png
