fadelrio/Taller-de-circuitos/cuarto_check/Taller_de_Circuitos___Cuarto_Checkpoint/res/esquematico_pwm.png

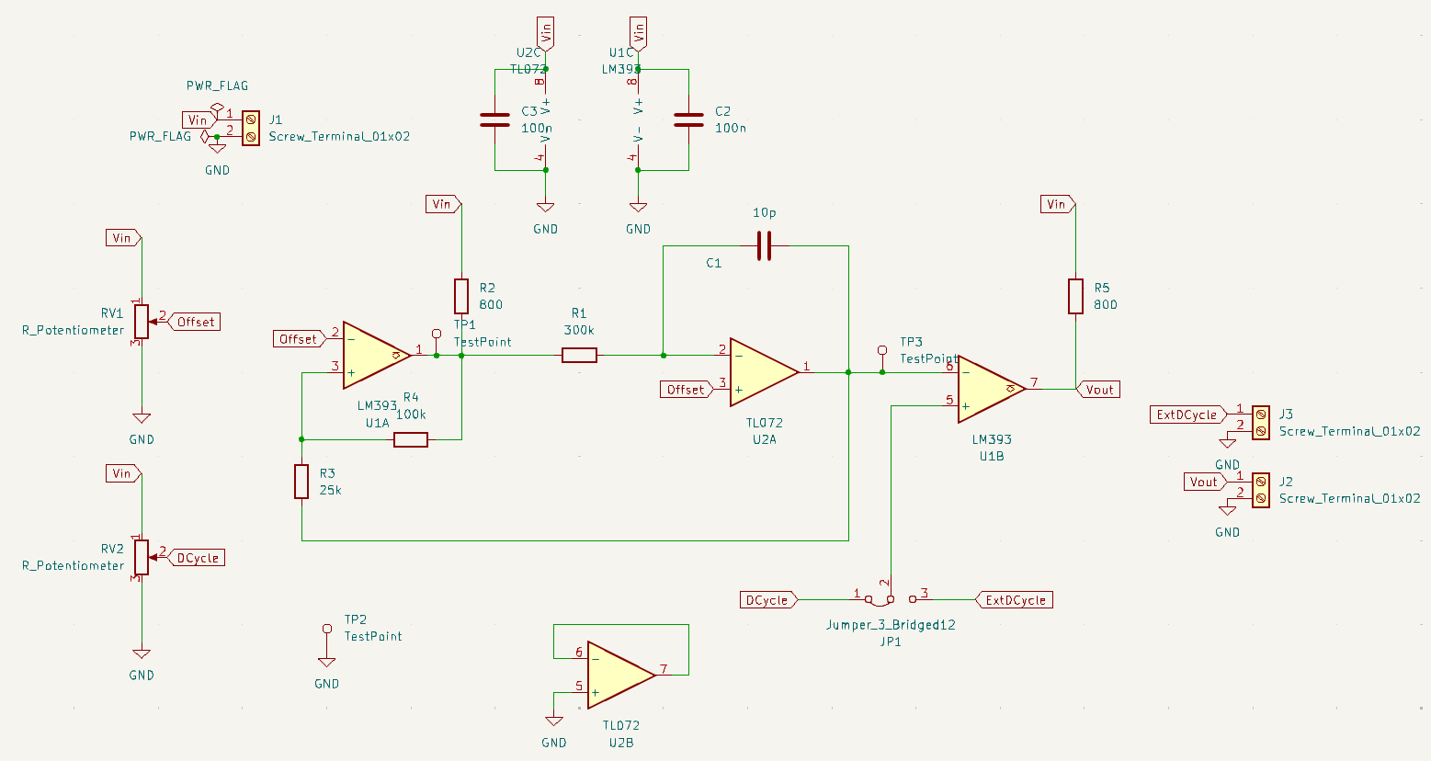
cuarto_check/Taller_de_Circuitos___Cuarto_Checkpoint/res/esquematico_pwm.png
