fadelrio/Taller-de-circuitos/placa_espejada.png

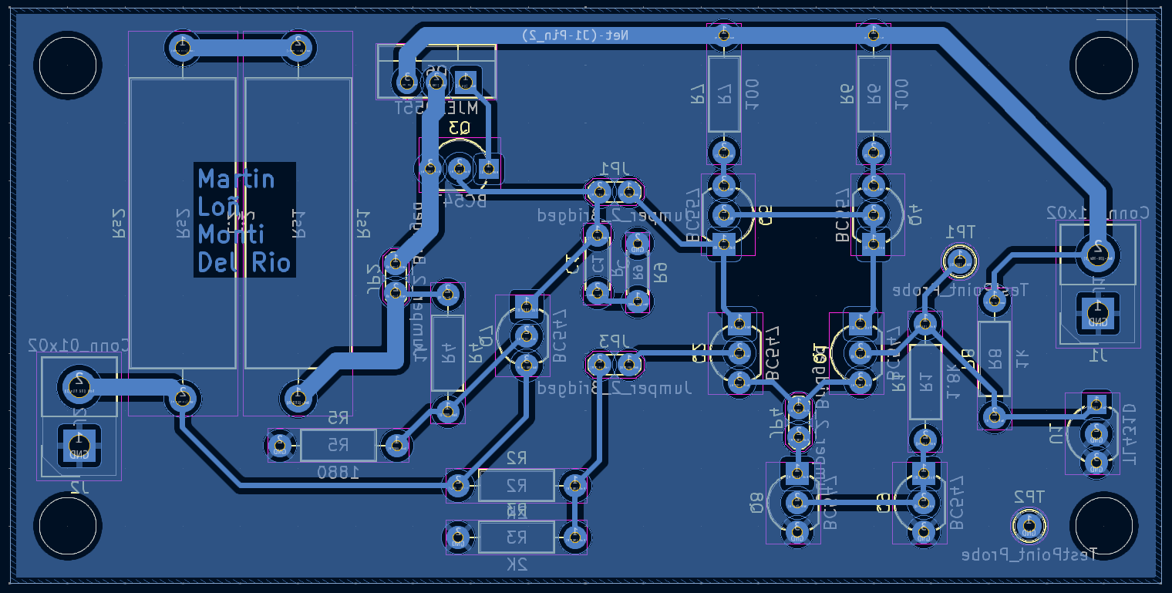
placa_espejada.png
