fadelrio/Taller-de-circuitos/primer_check/graficos/esquema_circuito_con_par_bloques.png

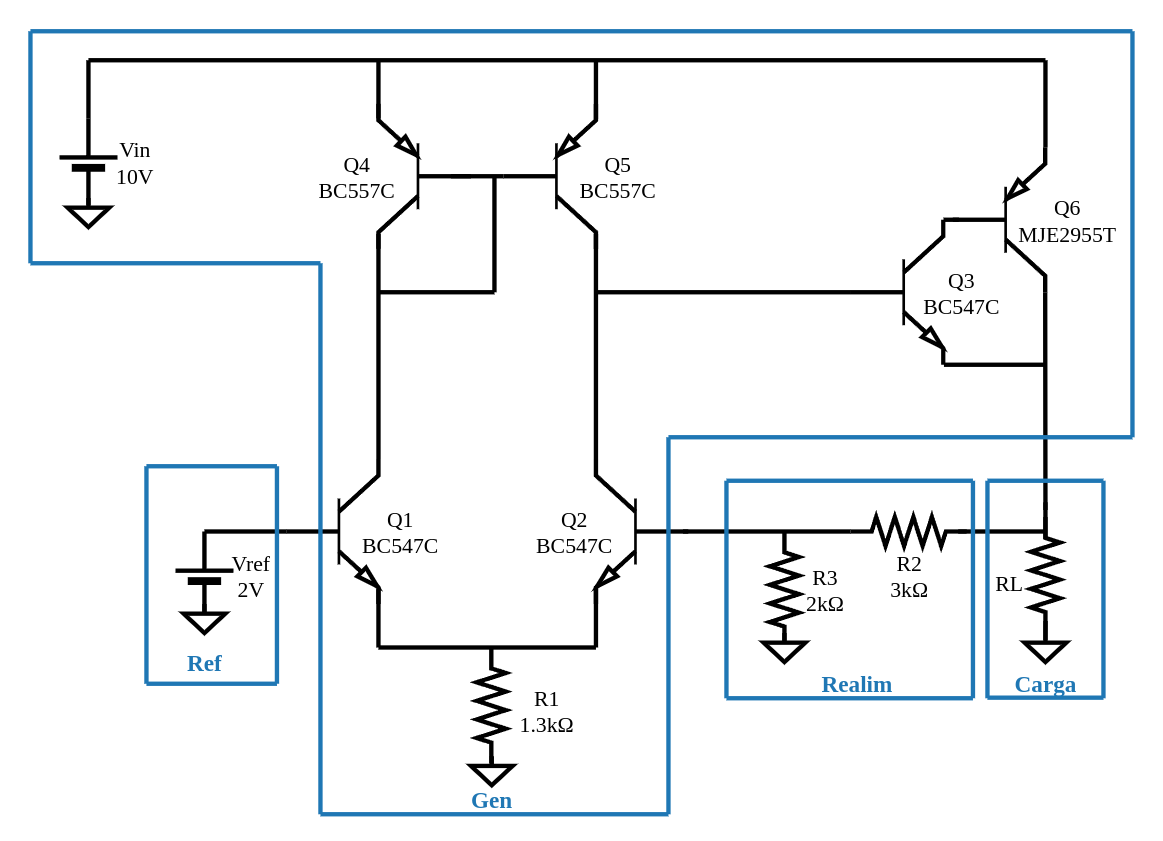
primer_check/graficos/esquema_circuito_con_par_bloques.png
