fadelrio/Taller-de-circuitos/primer_check/scripts_y_recursos/grafico_eficiencia_vs_corriente_sin_fold.png

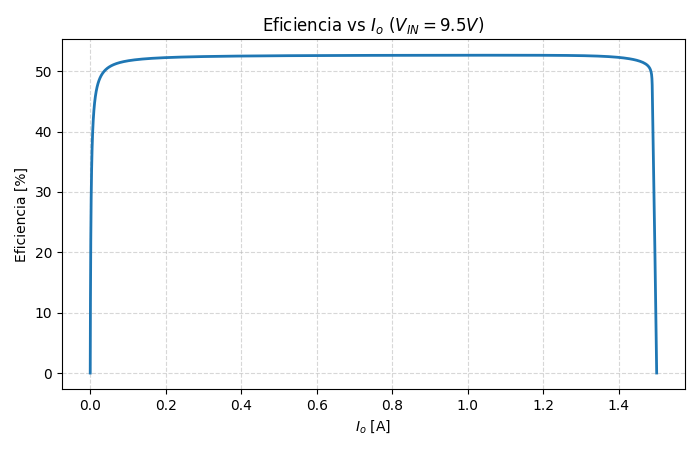
primer_check/scripts_y_recursos/grafico_eficiencia_vs_corriente_sin_fold.png
