fadelrio/Taller-de-circuitos/quinto_check/scripts_y_recursos/DSOBMP0001.bmp

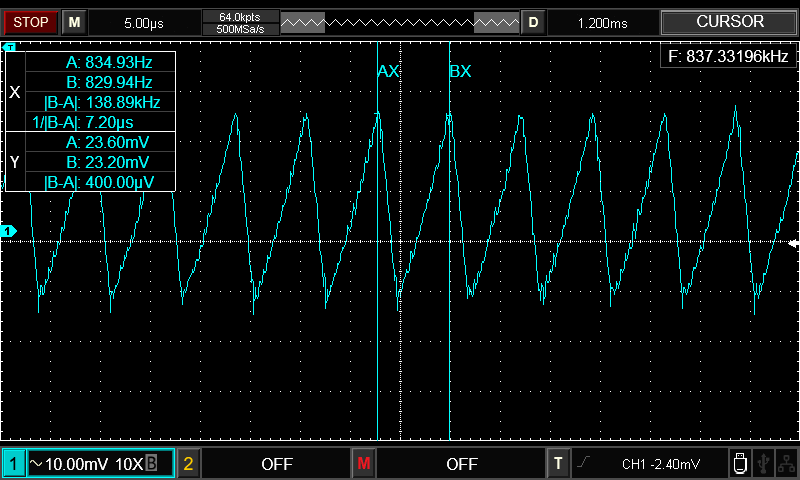
quinto_check/scripts_y_recursos/DSOBMP0001.bmp
