fadelrio/Taller-de-circuitos/quinto_check/scripts_y_recursos/gates_mosfets.BMP

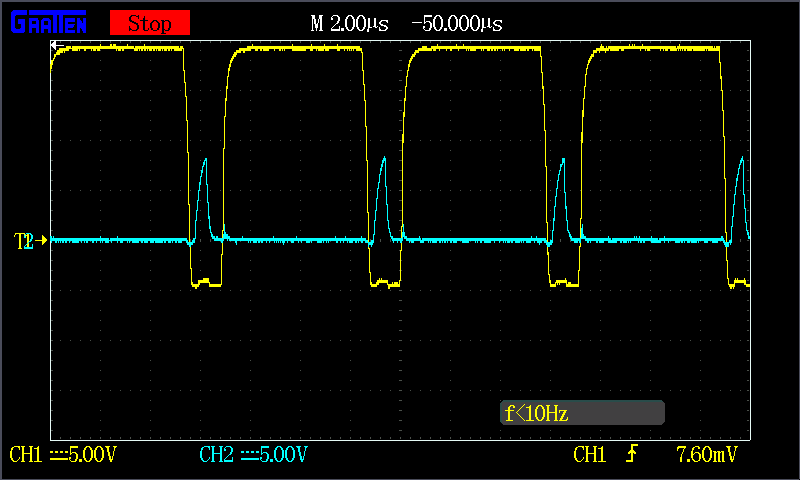
quinto_check/scripts_y_recursos/gates_mosfets.BMP
