fadelrio/Taller-de-circuitos/quinto_check/scripts_y_recursos/nodo_conmutacion.BMP

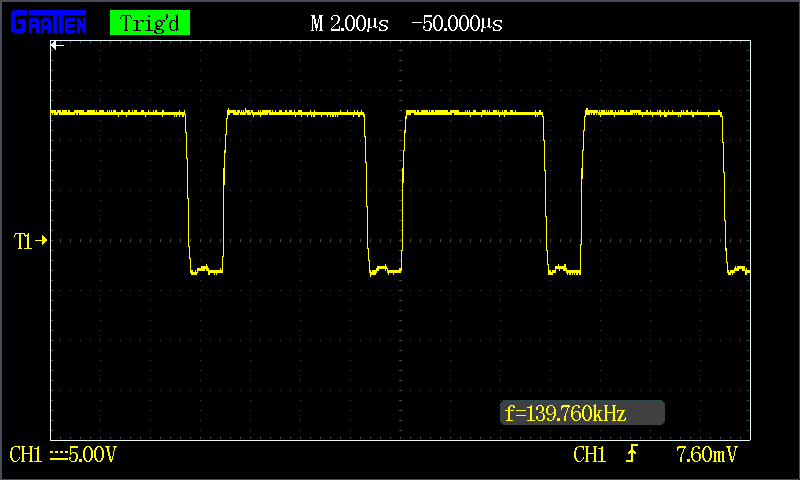
quinto_check/scripts_y_recursos/nodo_conmutacion.BMP
