fadelrio/Taller-de-circuitos/quinto_check/scripts_y_recursos/pwm_buck.BMP

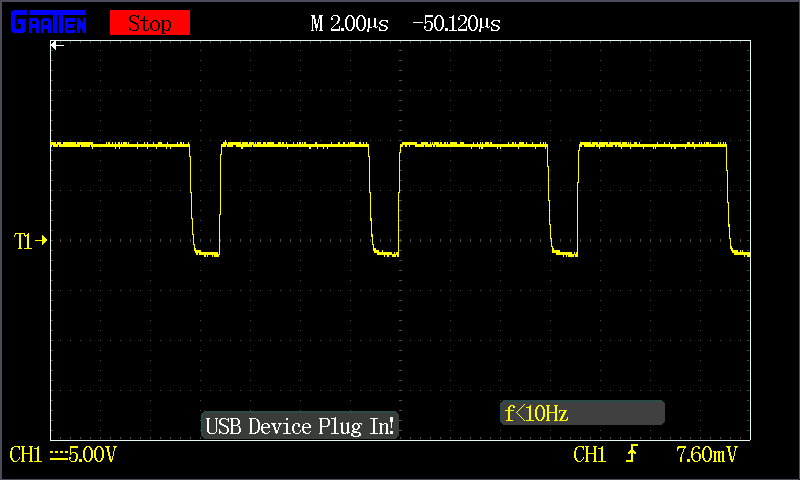
quinto_check/scripts_y_recursos/pwm_buck.BMP
