fadelrio/Taller-de-circuitos/quinto_check/scripts_y_recursos/ripple_12_10.BMP

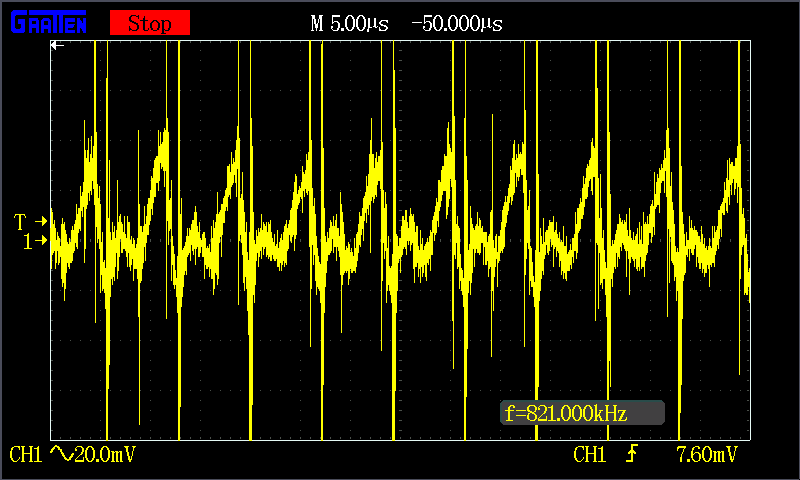
quinto_check/scripts_y_recursos/ripple_12_10.BMP
