fadelrio/Taller-de-circuitos/quinto_check/scripts_y_recursos/ripple_24_68.BMP

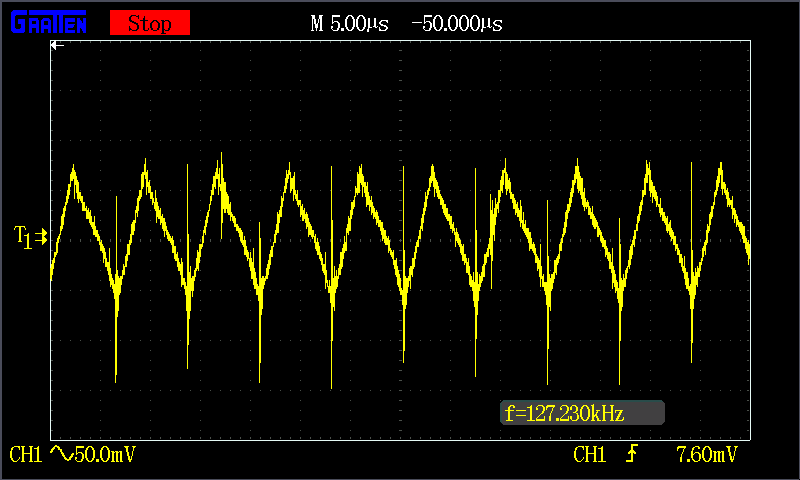
quinto_check/scripts_y_recursos/ripple_24_68.BMP
