fadelrio/Taller-de-circuitos/quinto_check/scripts_y_recursos/ripple_24_82.BMP

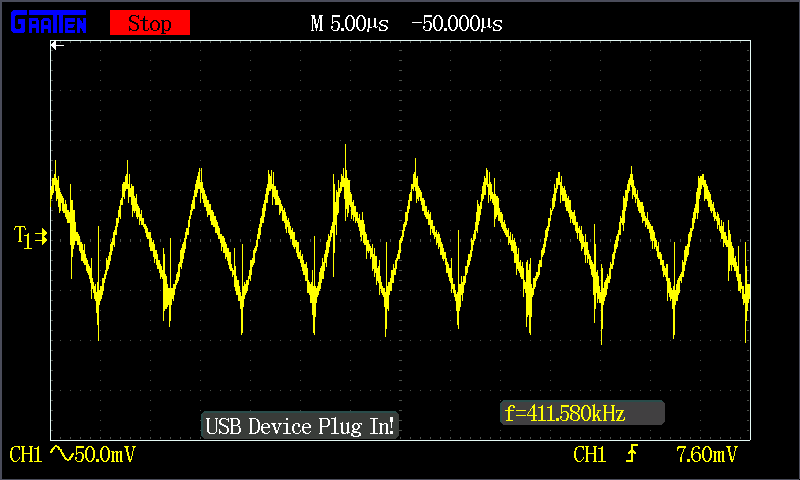
quinto_check/scripts_y_recursos/ripple_24_82.BMP
