fadelrio/Taller-de-circuitos/quinto_check/scripts_y_recursos/ripple_30_68.BMP

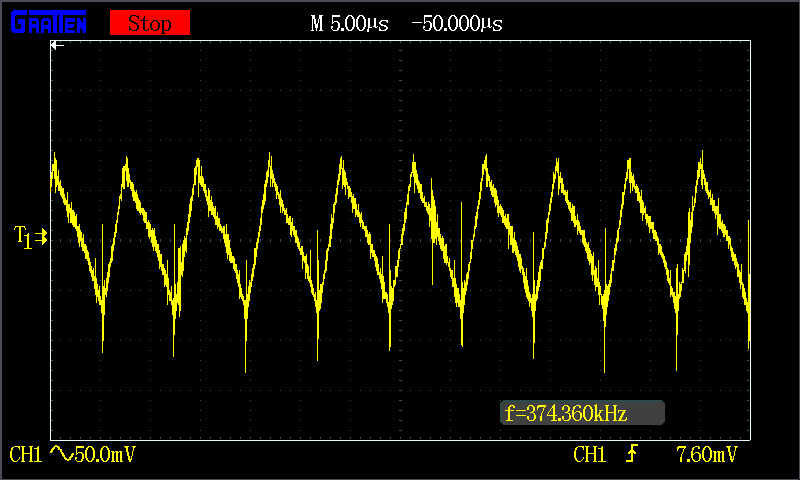
quinto_check/scripts_y_recursos/ripple_30_68.BMP
