fadelrio/Taller-de-circuitos/quinto_check/scripts_y_recursos/rta_apagado_68.BMP

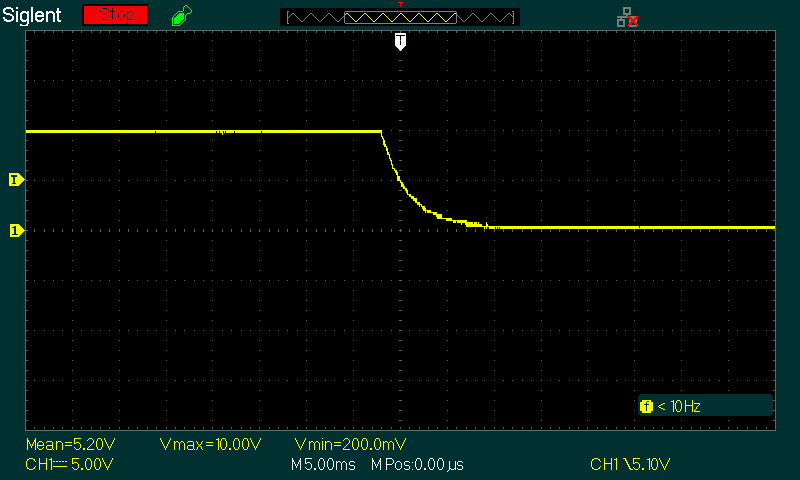
quinto_check/scripts_y_recursos/rta_apagado_68.BMP
