fadelrio/Taller-de-circuitos/quinto_check/scripts_y_recursos/rta_escalon_12v.BMP

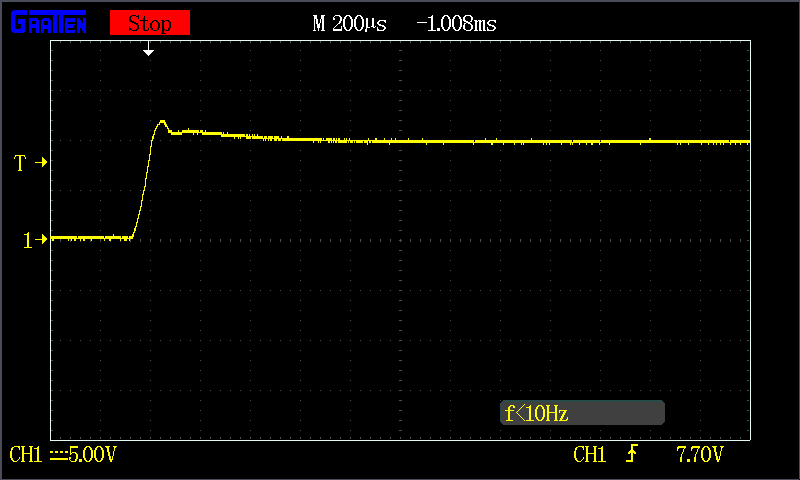
quinto_check/scripts_y_recursos/rta_escalon_12v.BMP
