fadelrio/Taller-de-circuitos/quinto_check/scripts_y_recursos/sat_ind_largo.BMP

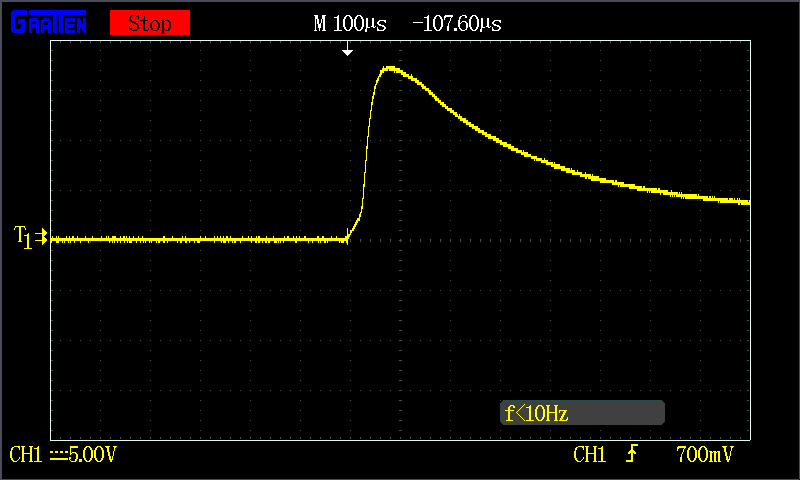
quinto_check/scripts_y_recursos/sat_ind_largo.BMP
