fadelrio/Taller-de-circuitos/quinto_check/scripts_y_recursos/TP3_carga_dinamica.BMP

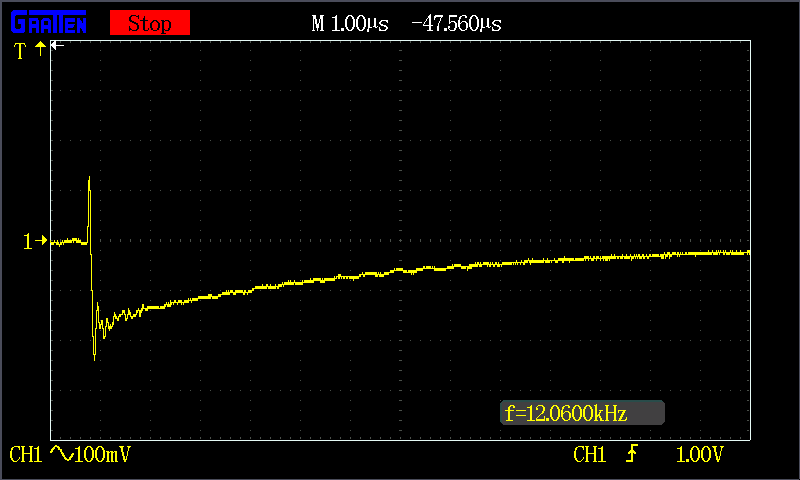
quinto_check/scripts_y_recursos/TP3_carga_dinamica.BMP
