fadelrio/Taller-de-circuitos/quinto_check/scripts_y_recursos/triangular_buck.BMP

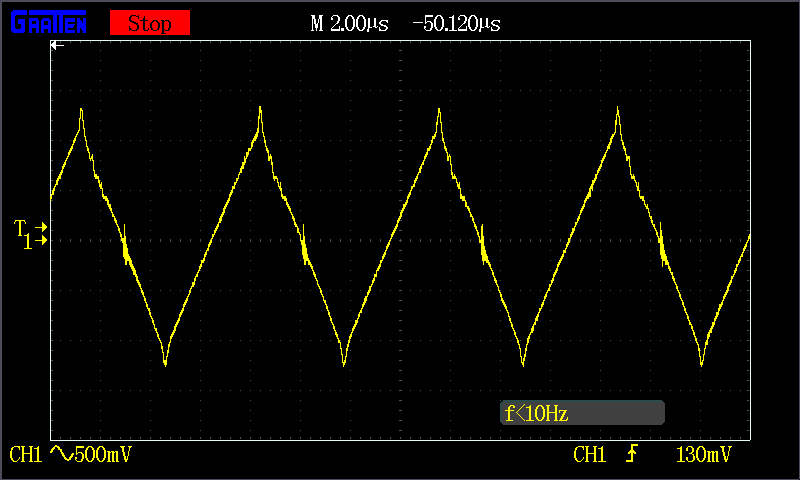
quinto_check/scripts_y_recursos/triangular_buck.BMP
