fadelrio/Taller-de-circuitos/quinto_check/Taller_de_Circuitos_Quinto_Checkpoint/res/circuito_lazo_cerrado_compensado.png

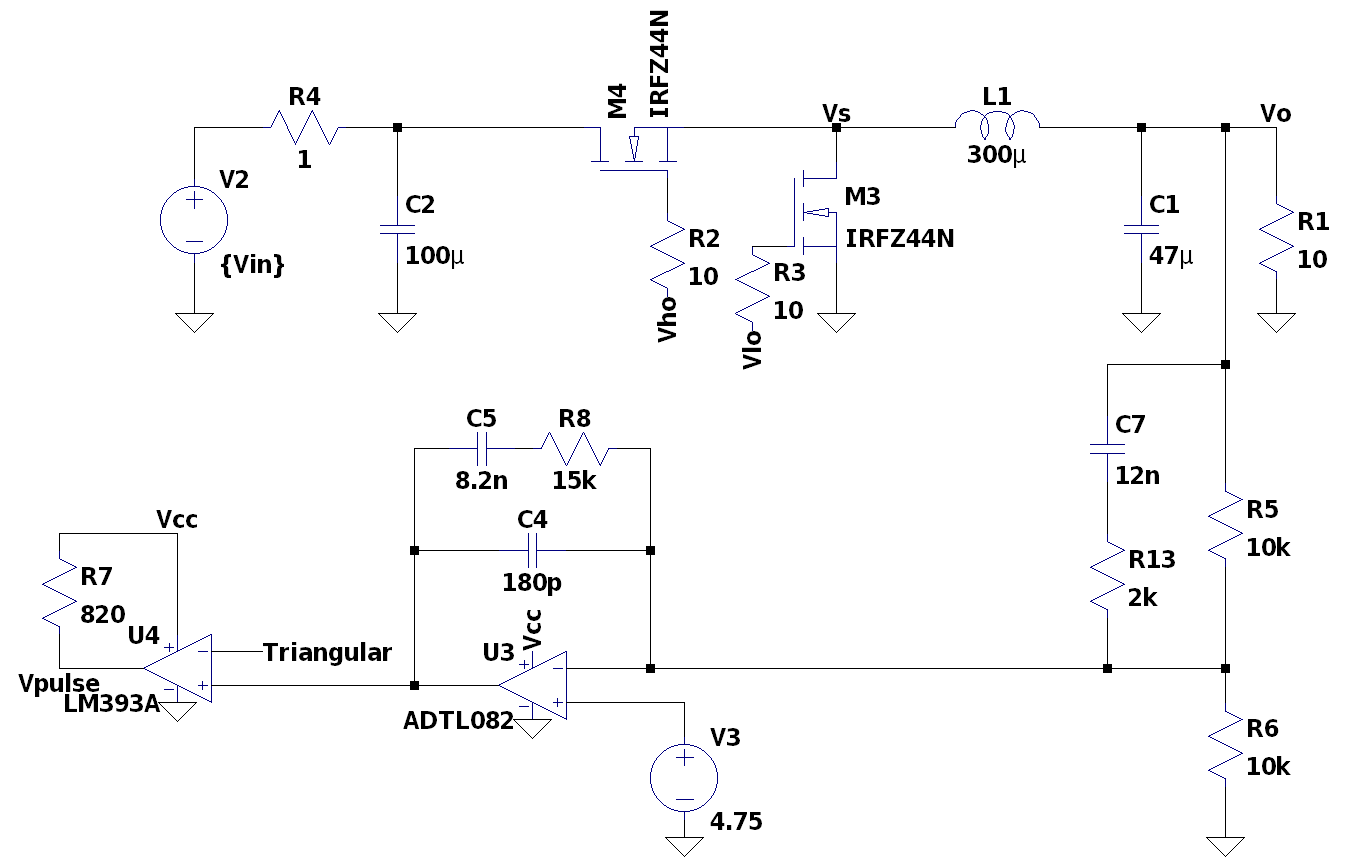
quinto_check/Taller_de_Circuitos_Quinto_Checkpoint/res/circuito_lazo_cerrado_compensado.png
