fadelrio/Taller-de-circuitos/quinto_check/Taller_de_Circuitos_Quinto_Checkpoint/res/lazo_corriente_compensado_15u.jpeg

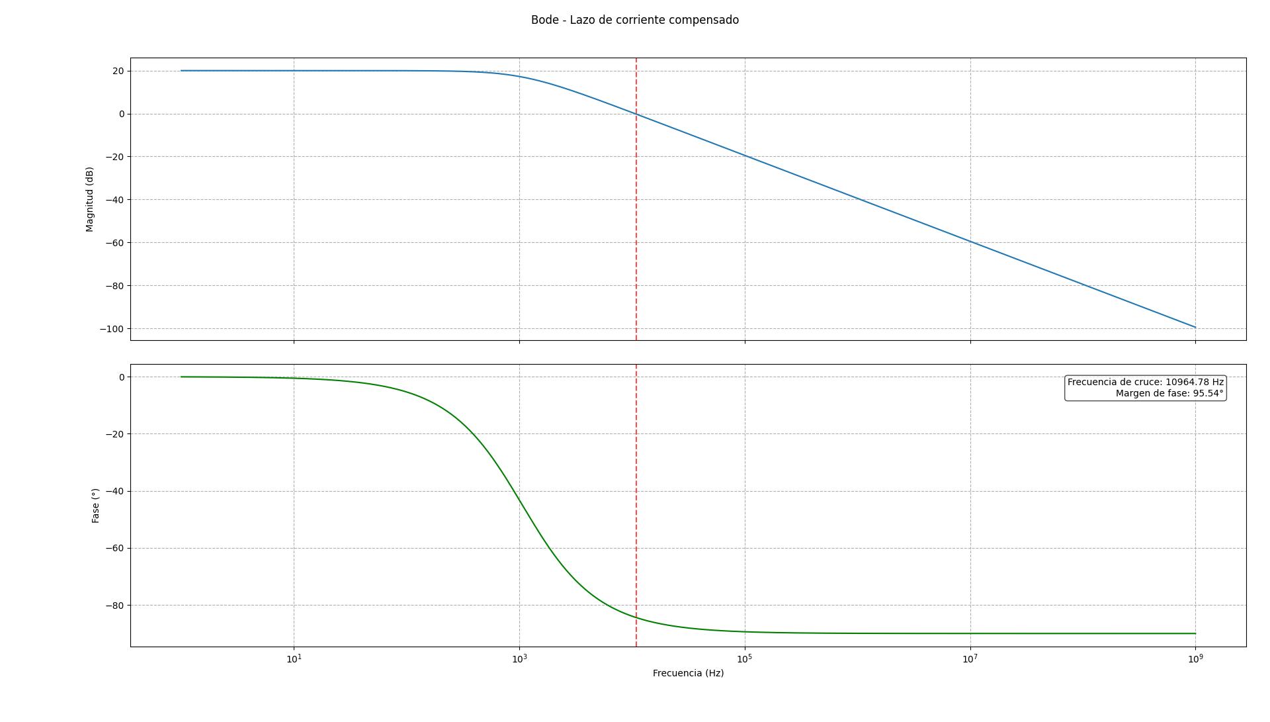
quinto_check/Taller_de_Circuitos_Quinto_Checkpoint/res/lazo_corriente_compensado_15u.jpeg
