fadelrio/Taller-de-circuitos/cuarto_check/infineon-ir2104-pspice-simulationmodels-en/Model/results/demo_testbench.png

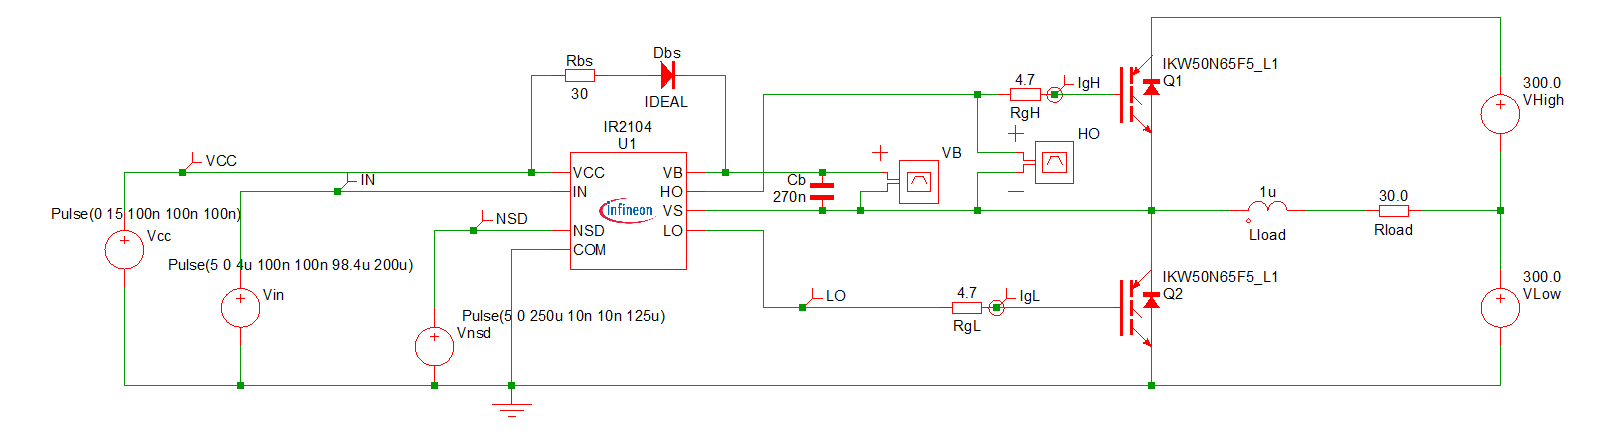
cuarto_check/infineon-ir2104-pspice-simulationmodels-en/Model/results/demo_testbench.png
