fadelrio/Taller-de-circuitos/cuarto_check/infineon-ir2104-pspice-simulationmodels-en/Model/results/waveforms.png

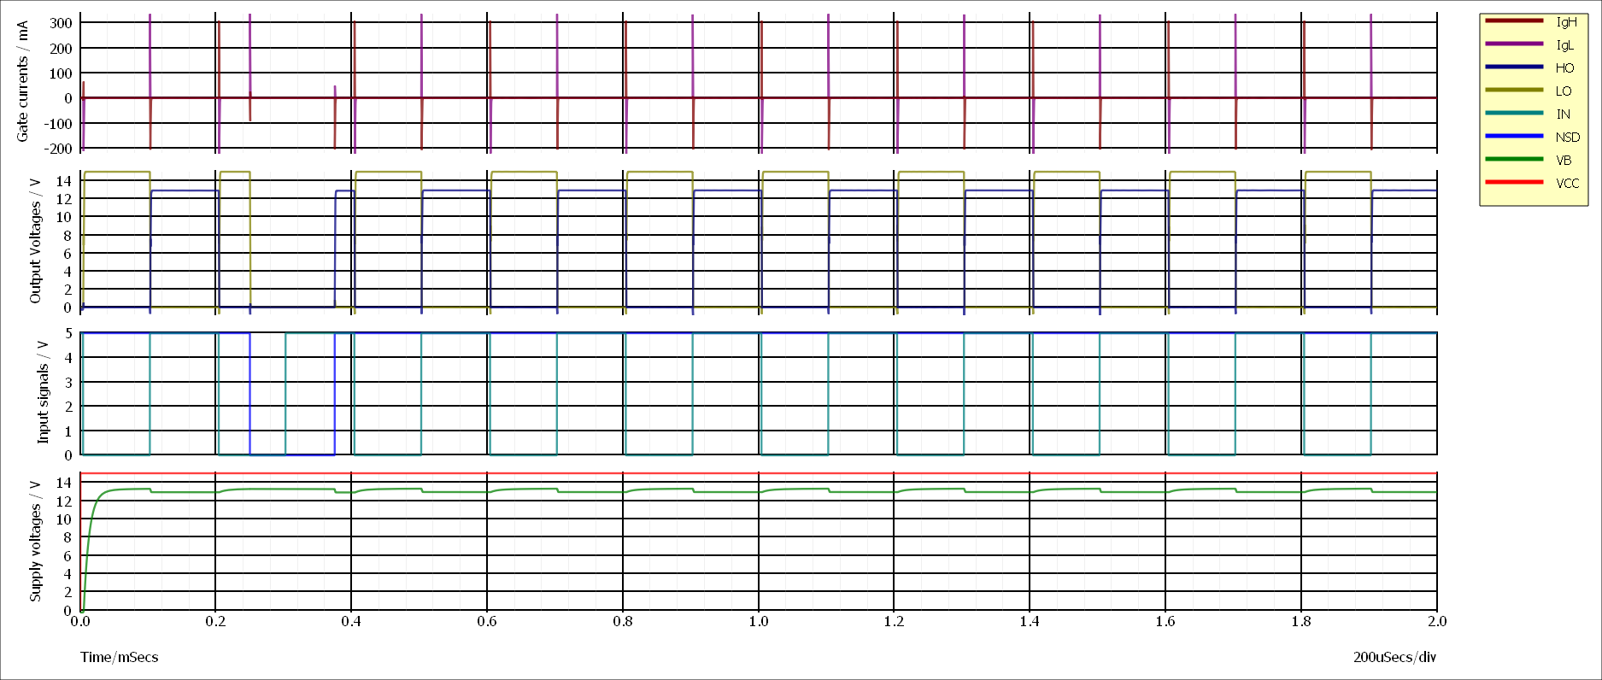
cuarto_check/infineon-ir2104-pspice-simulationmodels-en/Model/results/waveforms.png
