fadelrio/Taller-de-circuitos/primer_check/graficos/compensado_sin_valores.pdf

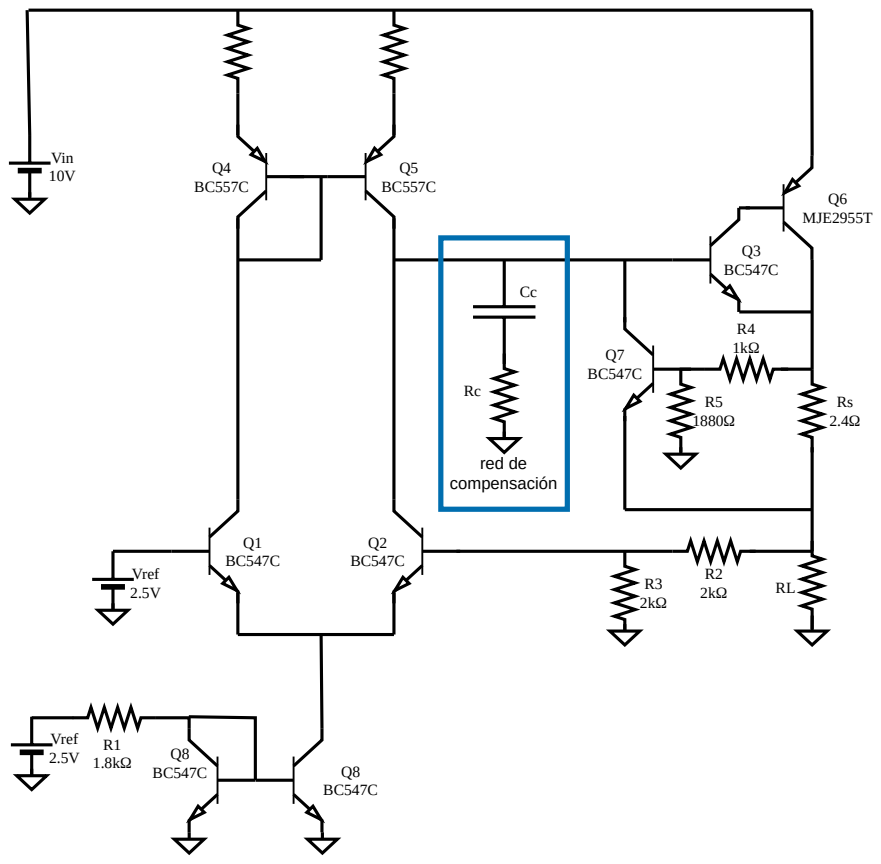
[picture p132: page 1]
