fadelrio/Taller-de-circuitos/primer_check/graficos/esquema_circuito_con_par_bloques.pdf

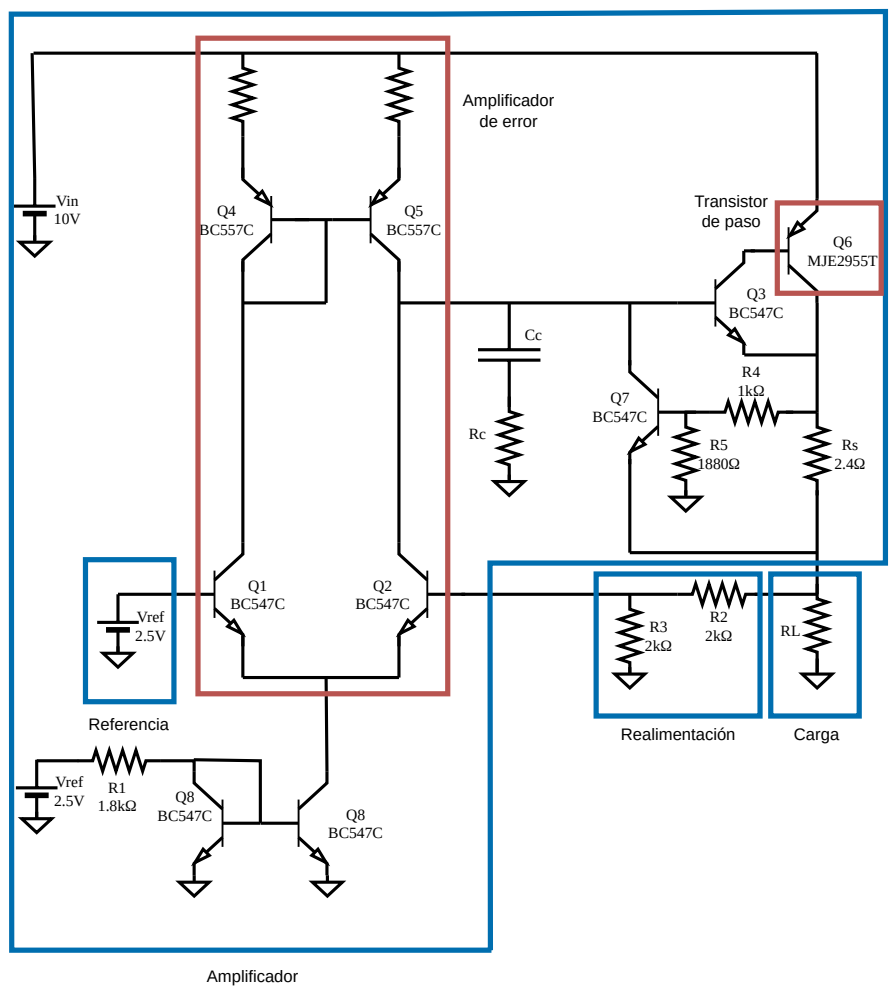
[picture p133: page 1]
