fadelrio/Taller-de-circuitos/primer_check/graficos/esquema_foldback.pdf

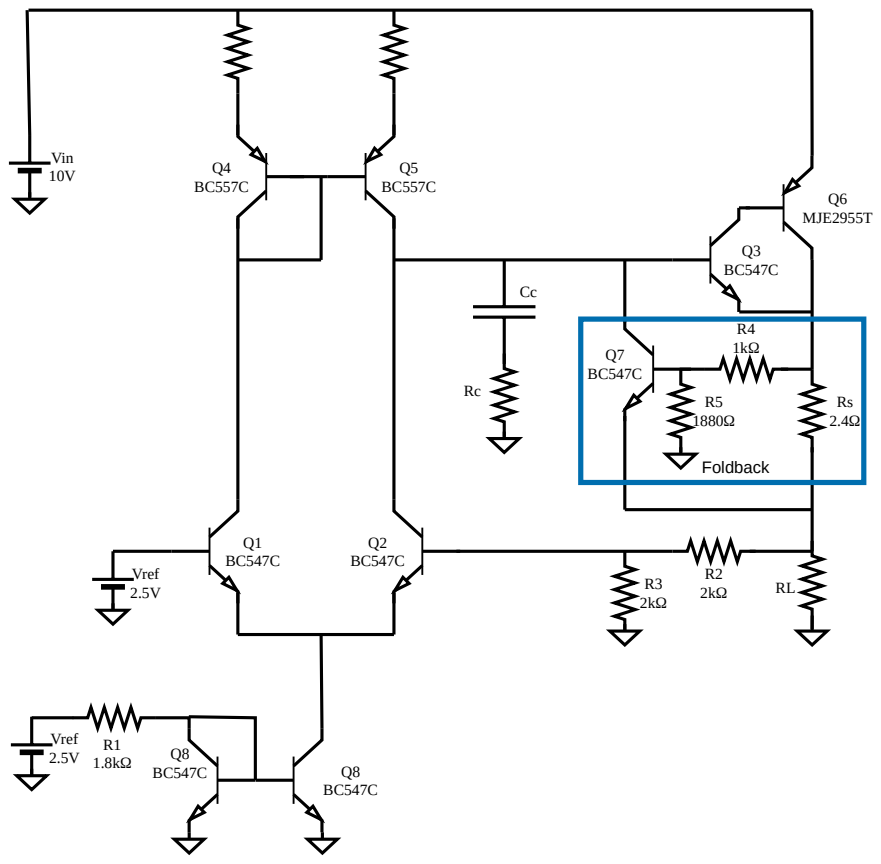
[picture p134: page 1]
