fadelrio/Taller-de-circuitos/quinto_check/graficos/esquematico_pcb.pdf

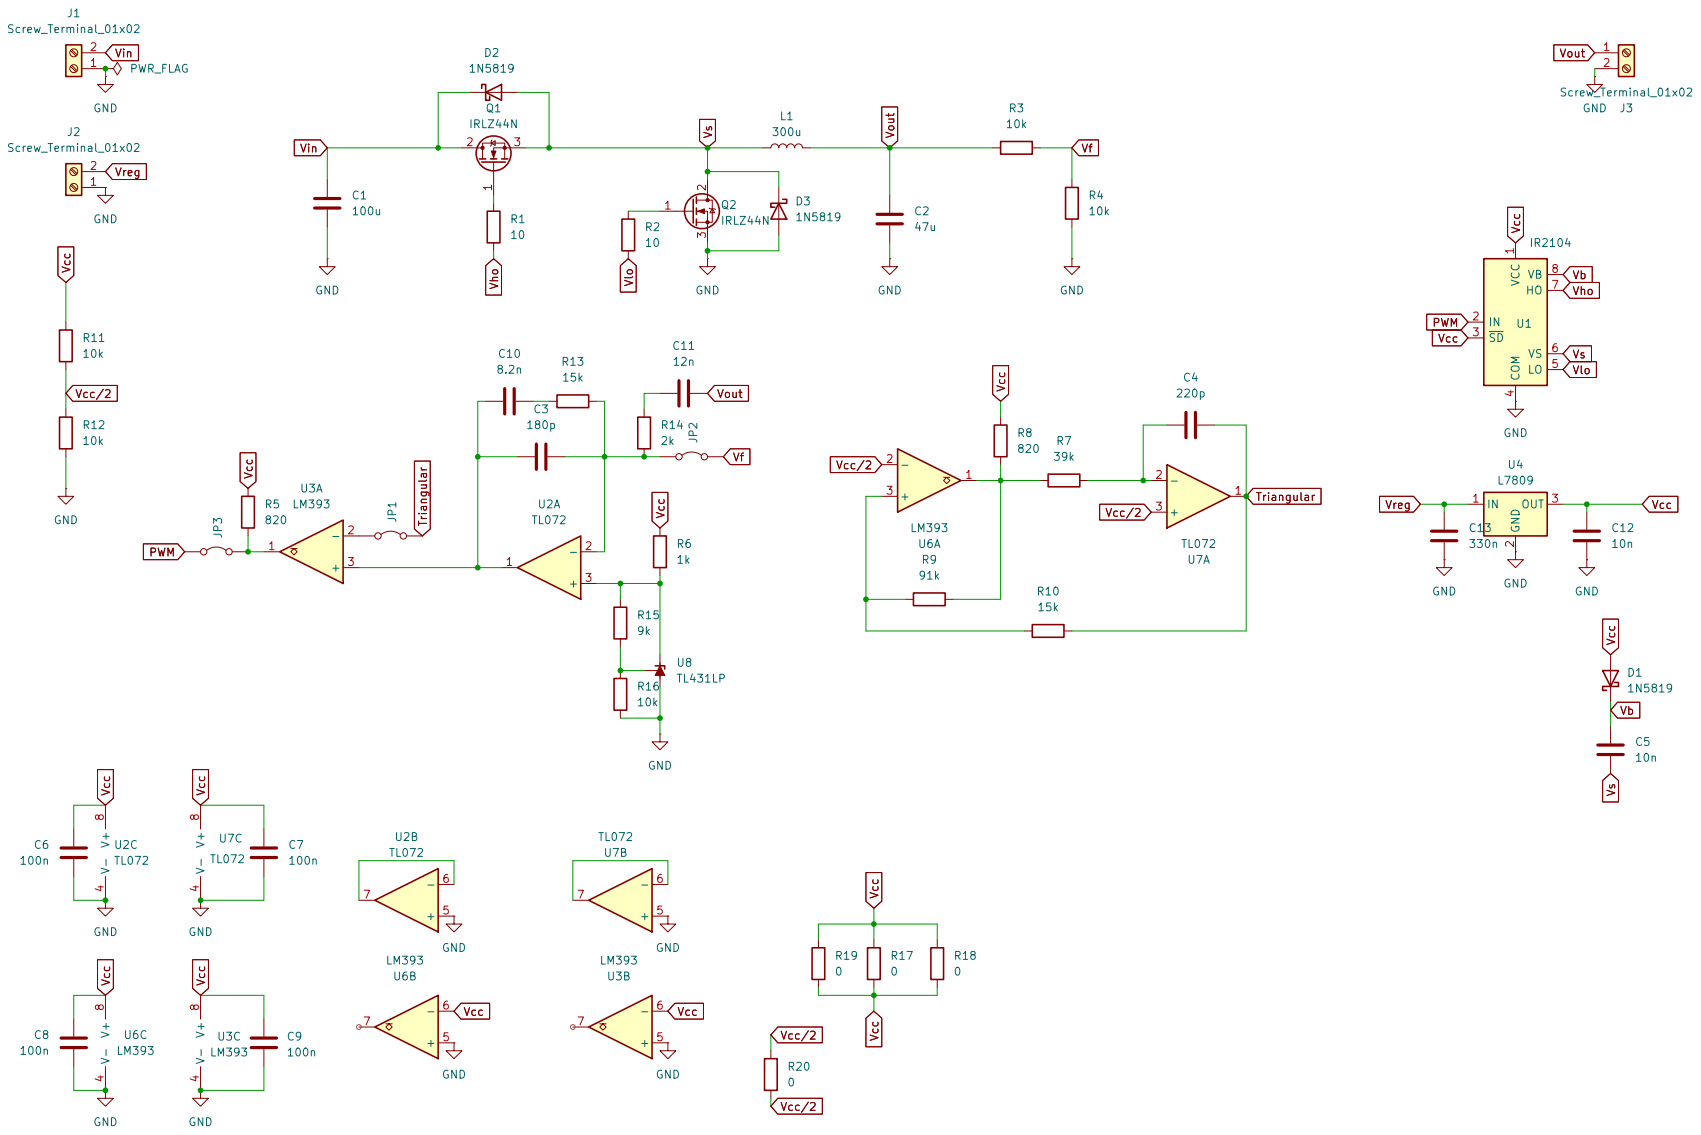
[picture p135: page 1]
