fadelrio/Taller-de-circuitos/quinto_check/graficos/grafico_gates_mosfets.pdf

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

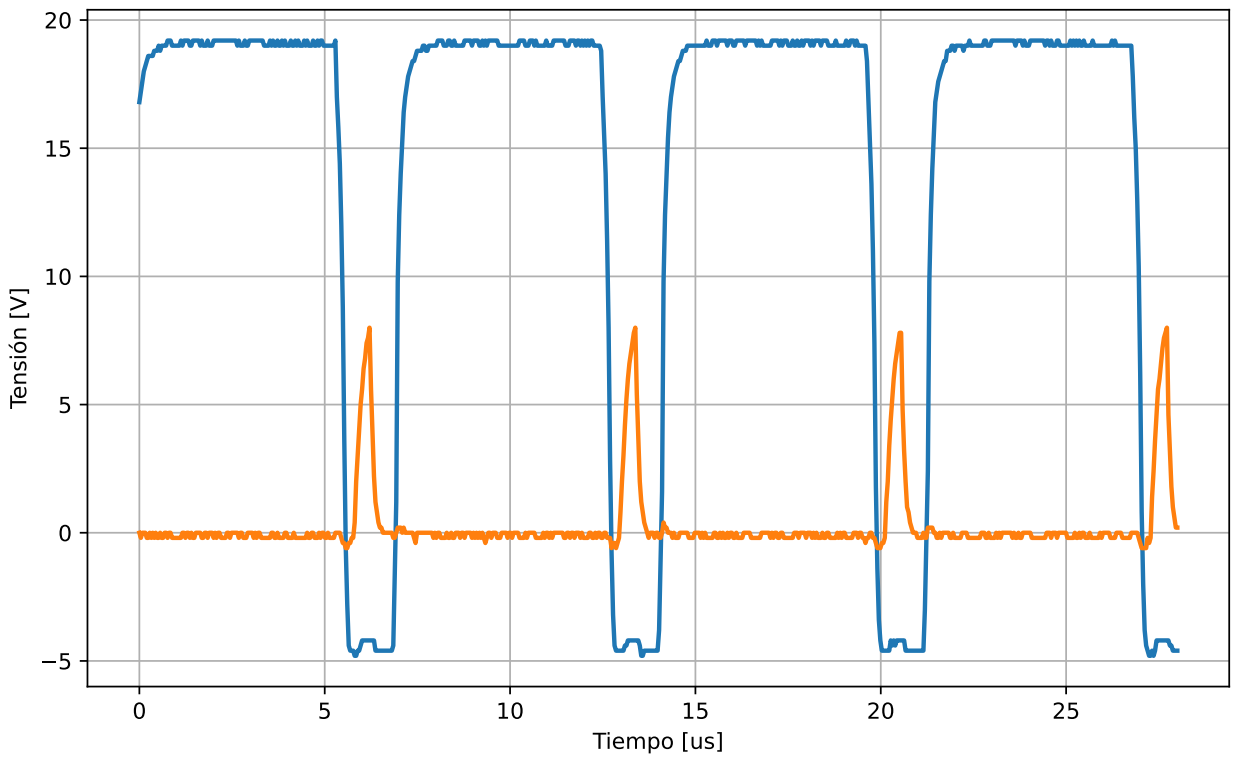
[picture p136: page 1]
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
