fadelrio/Taller-de-circuitos/quinto_check/graficos/grafico_ripple_24_68.pdf

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

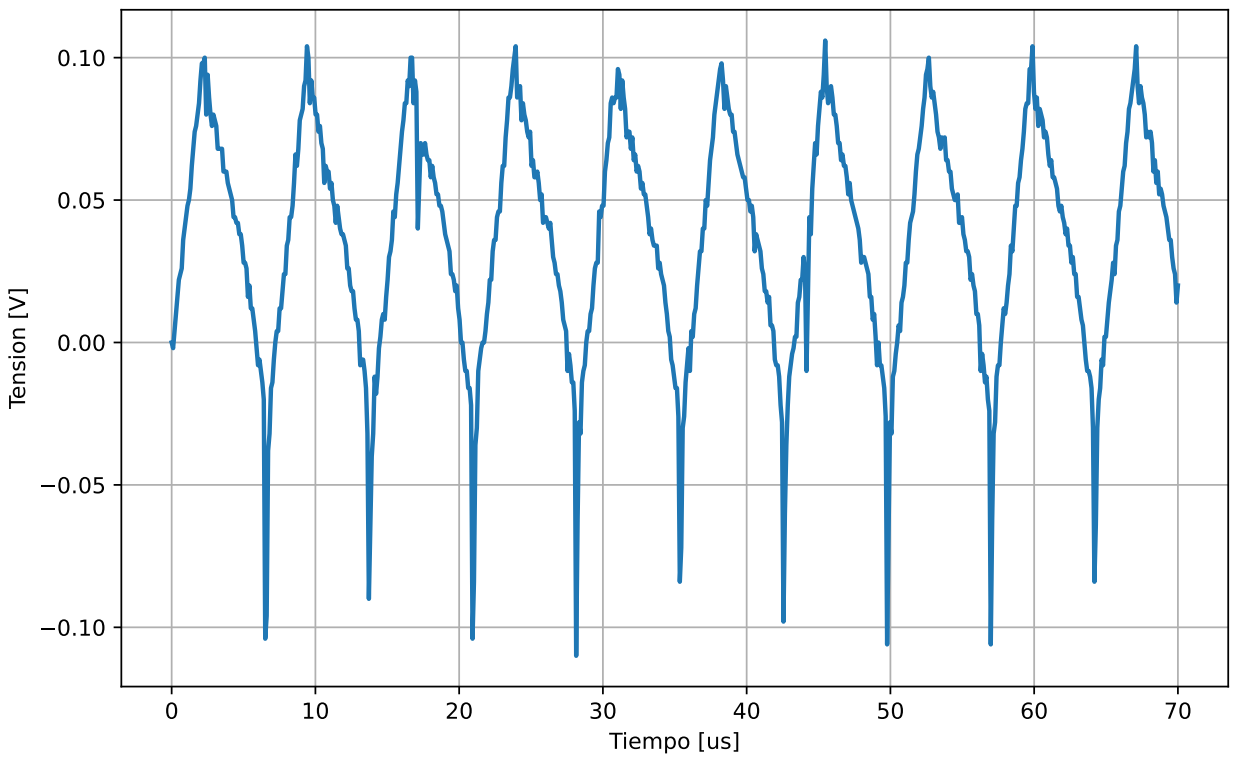
[picture p147: page 1]
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
