fadelrio/Taller-de-circuitos/quinto_check/graficos/grafico_rta_apagado_82.pdf

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

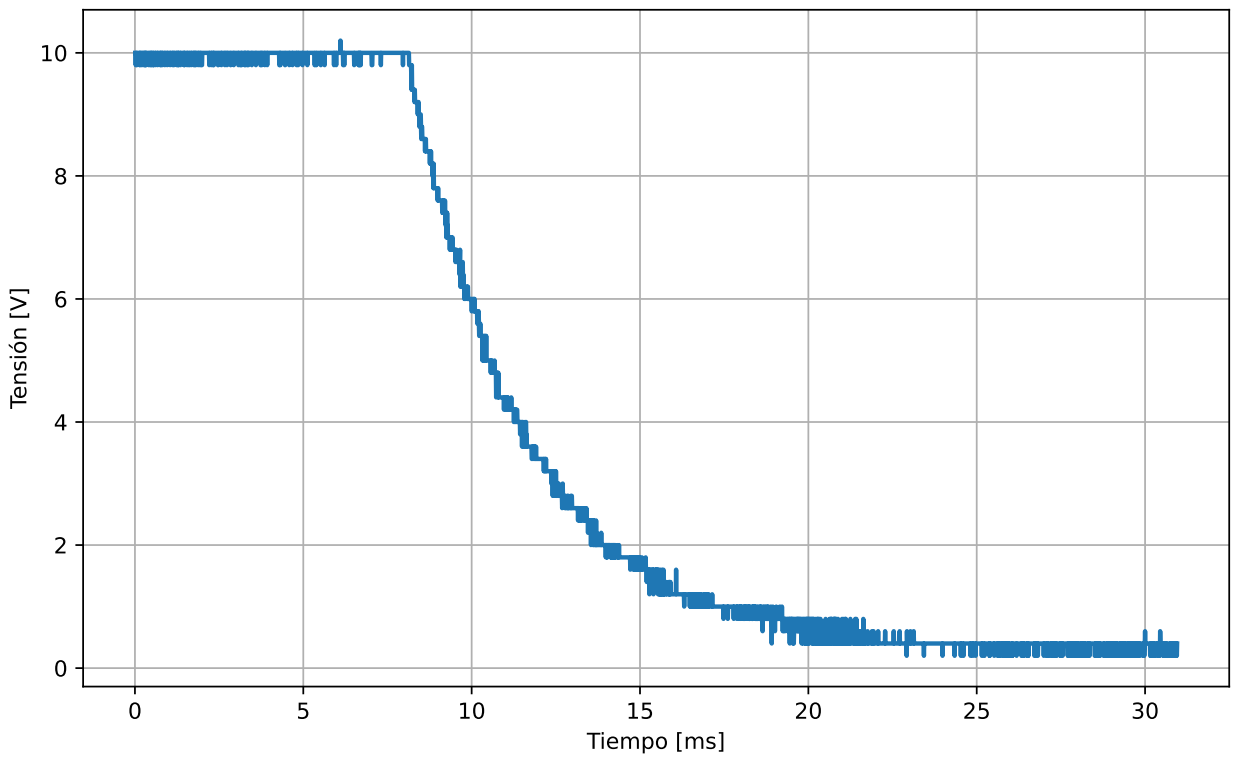
[picture p154: page 1]
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
