fadelrio/Taller-de-circuitos/quinto_check/graficos/nodo_conmutacion_buck.pdf

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

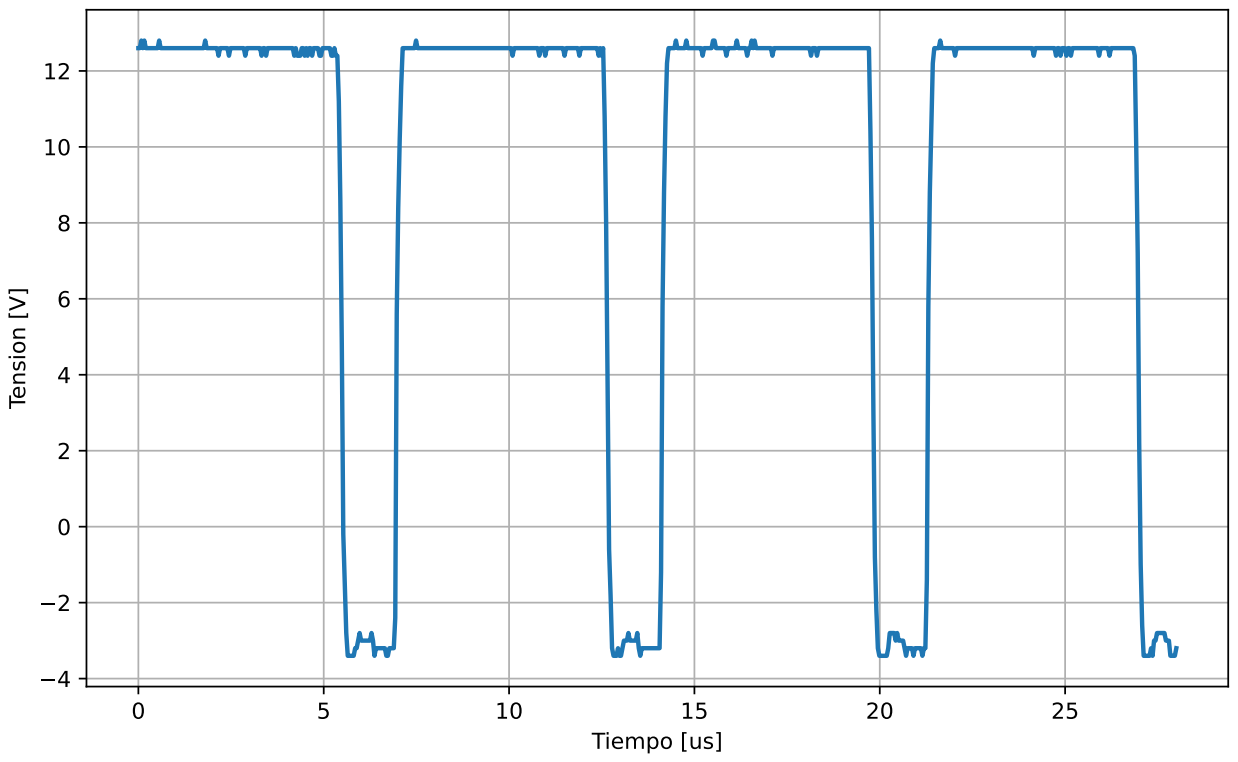
[picture p157: page 1]
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
