fadelrio/Taller-de-circuitos/quinto_check/graficos/red_compensacion.pdf

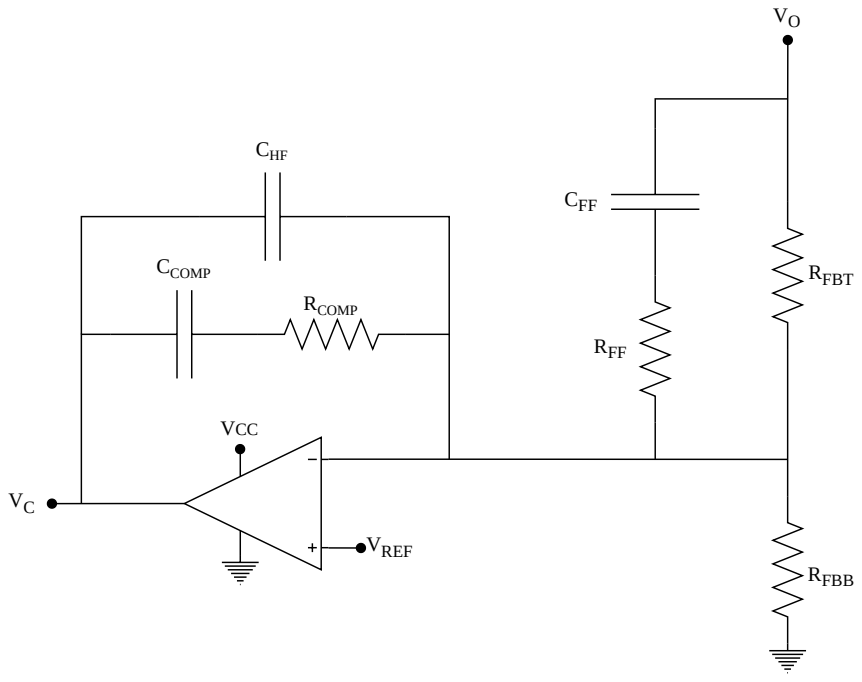
[picture p158: page 1]
RFBT; RFBB; RFF; CFF; VREF; VCC; RCOMP; CCOMP; CHF
