fadelrio/Taller-de-circuitos/tercer_check/graficos/grafico_regulacion_de_carga.pdf

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

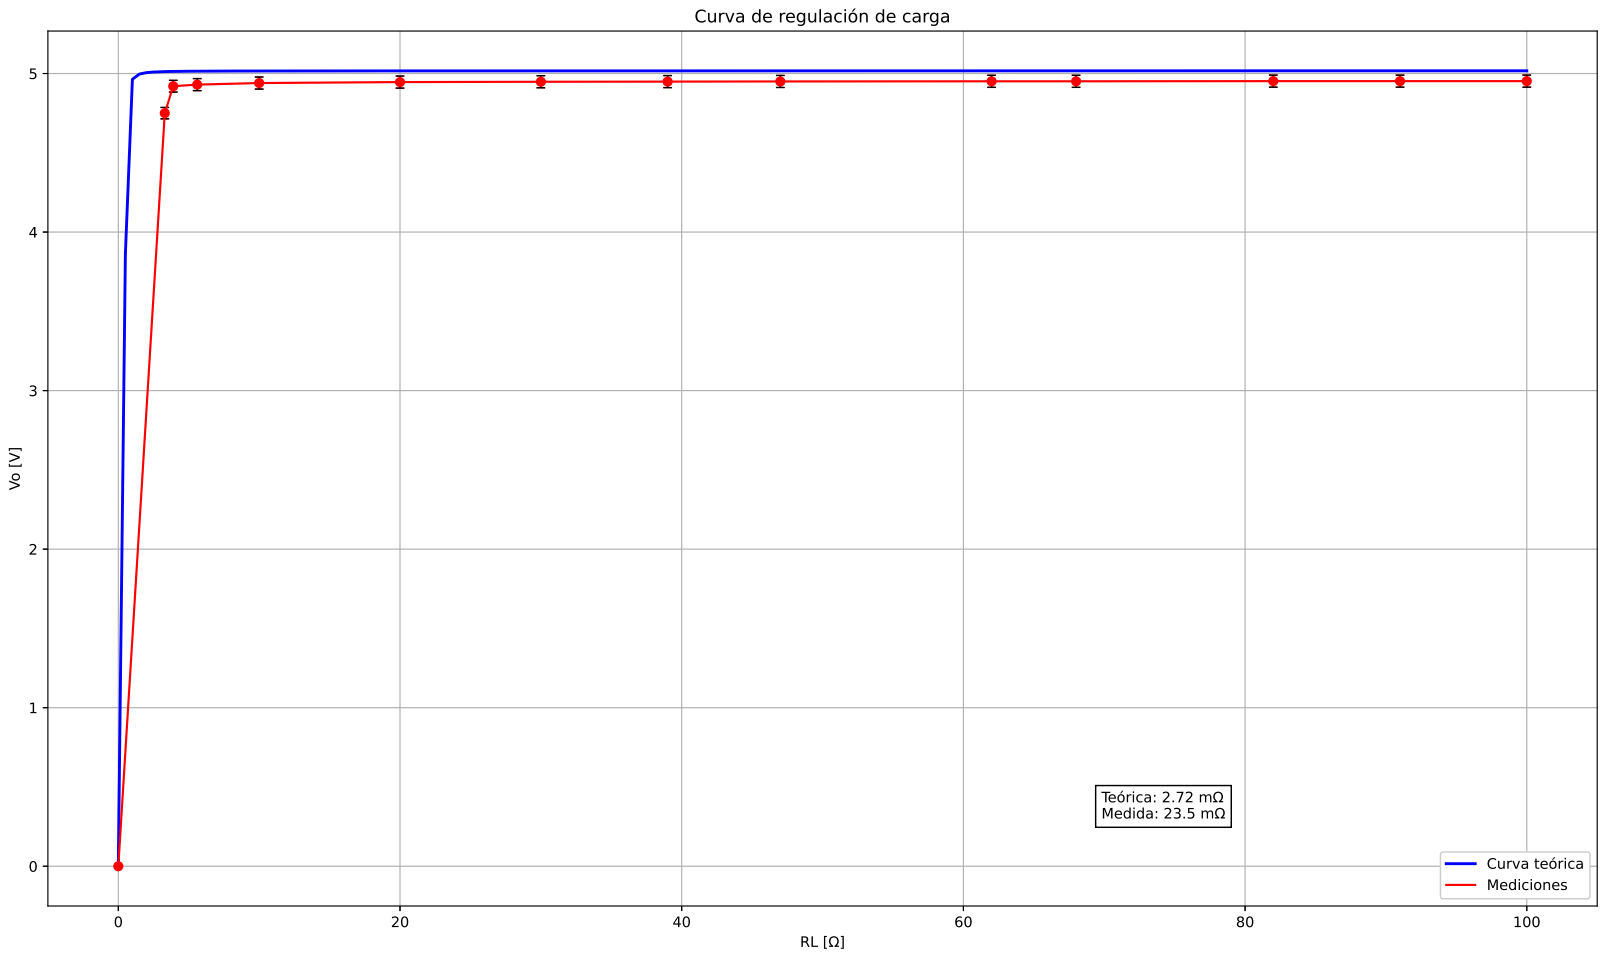
[picture p163: page 1]
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
