fadelrio/Taller-de-circuitos/tercer_check/graficos/grafico_tiempo_encendido.pdf

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

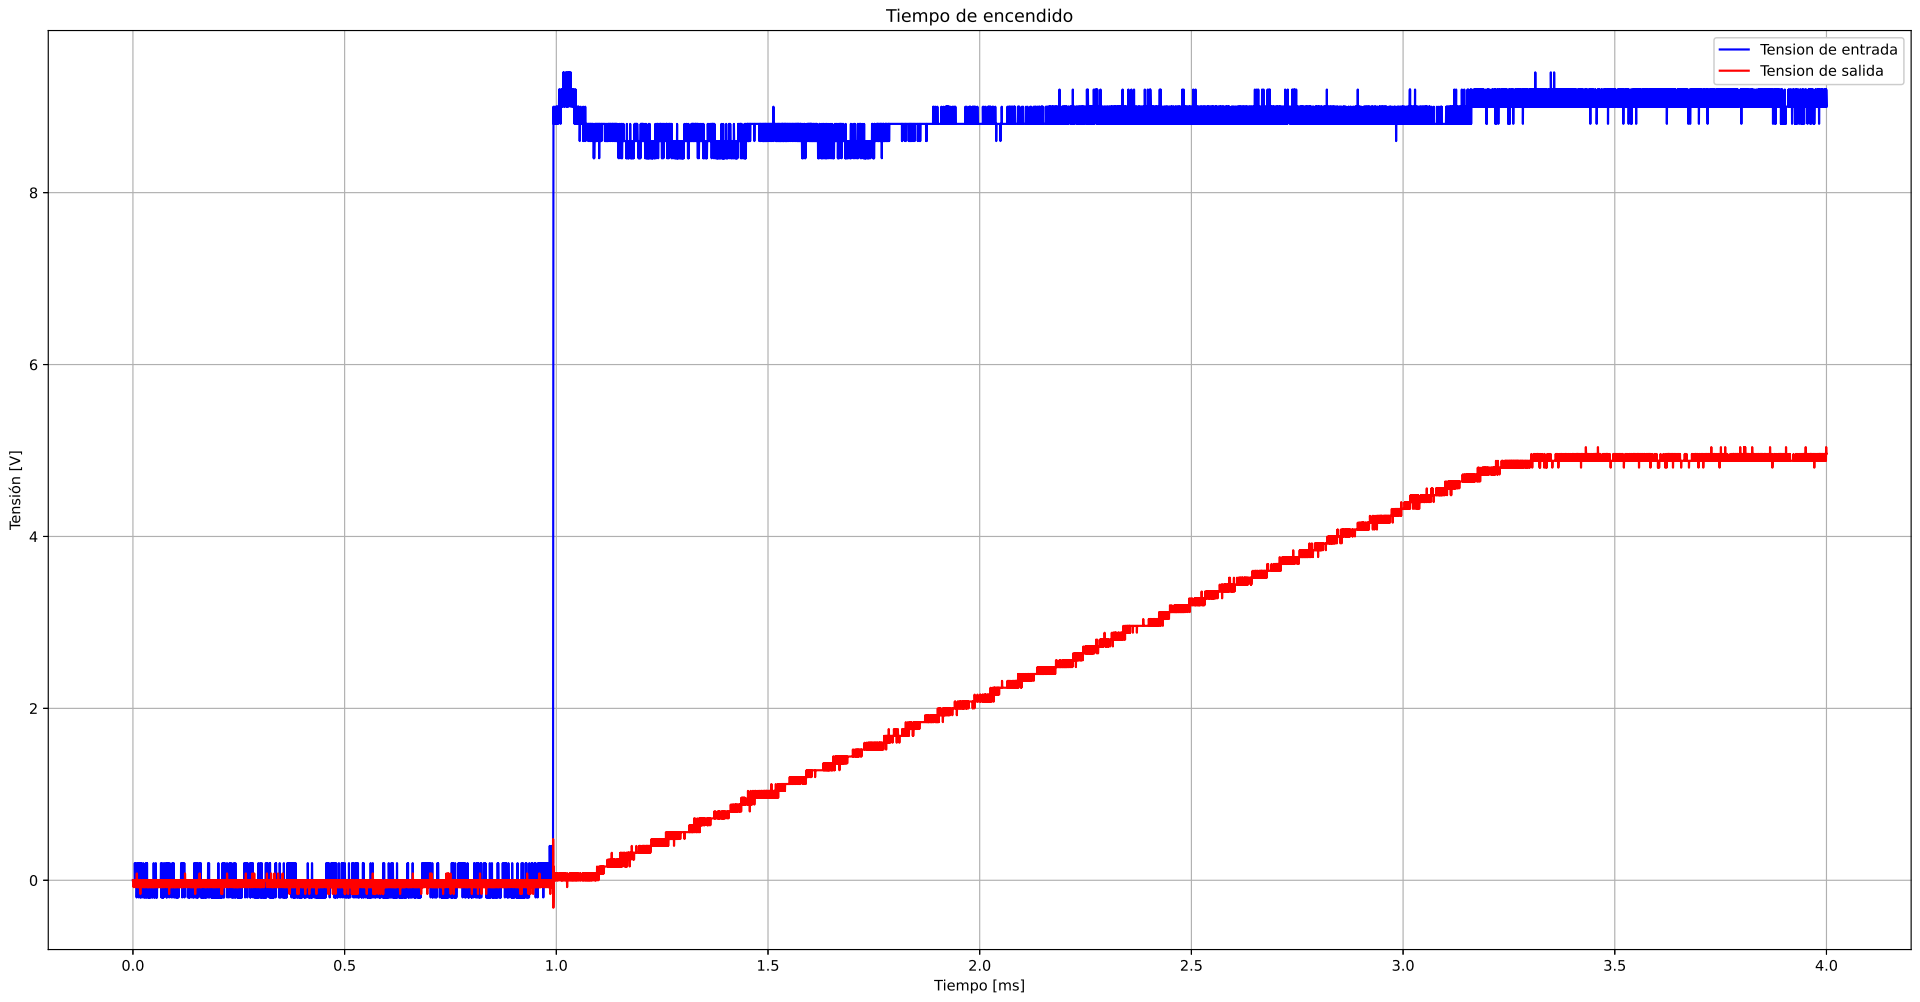
[picture p166: page 1]
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
