fadelrio/Taller-de-circuitos/primer_check/Taller_de_circuitos_Primer_checkpoint/res/esquema_circuito_con_par_bloques.pdf

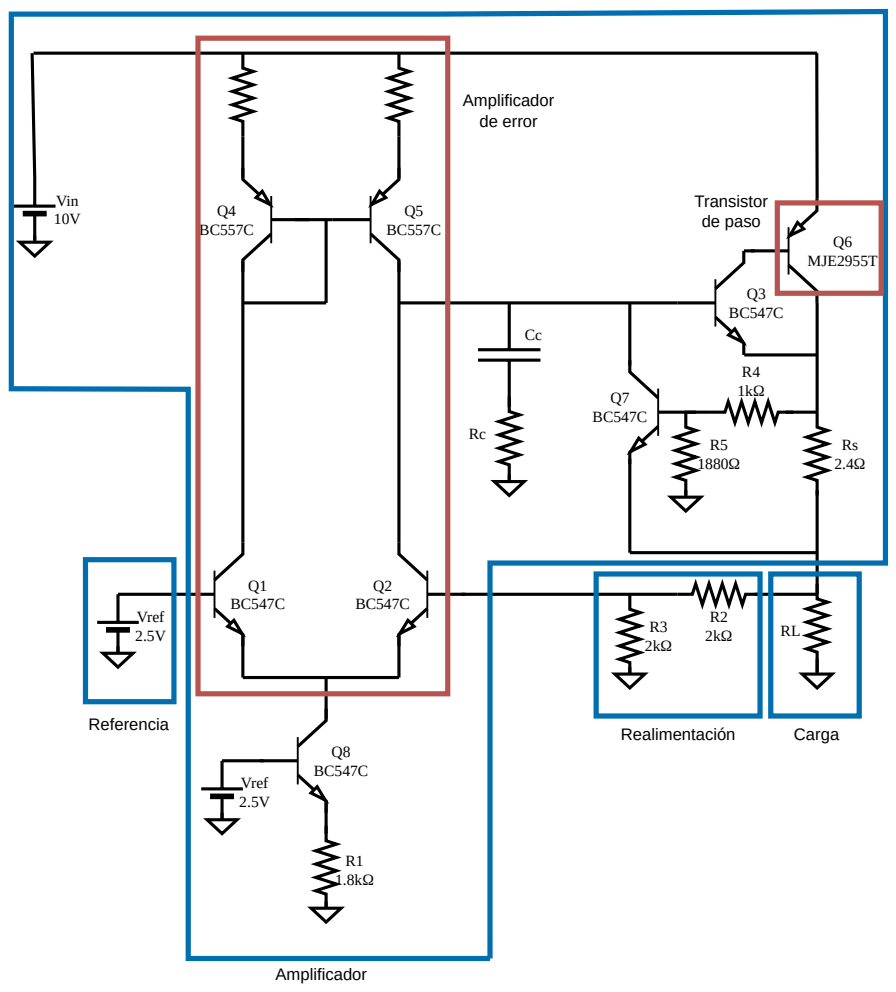
[picture p167: page 1]
