fadelrio/Taller-de-circuitos/quinto_check/Taller_de_Circuitos_Quinto_Checkpoint/res/cuadrada.pdf

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

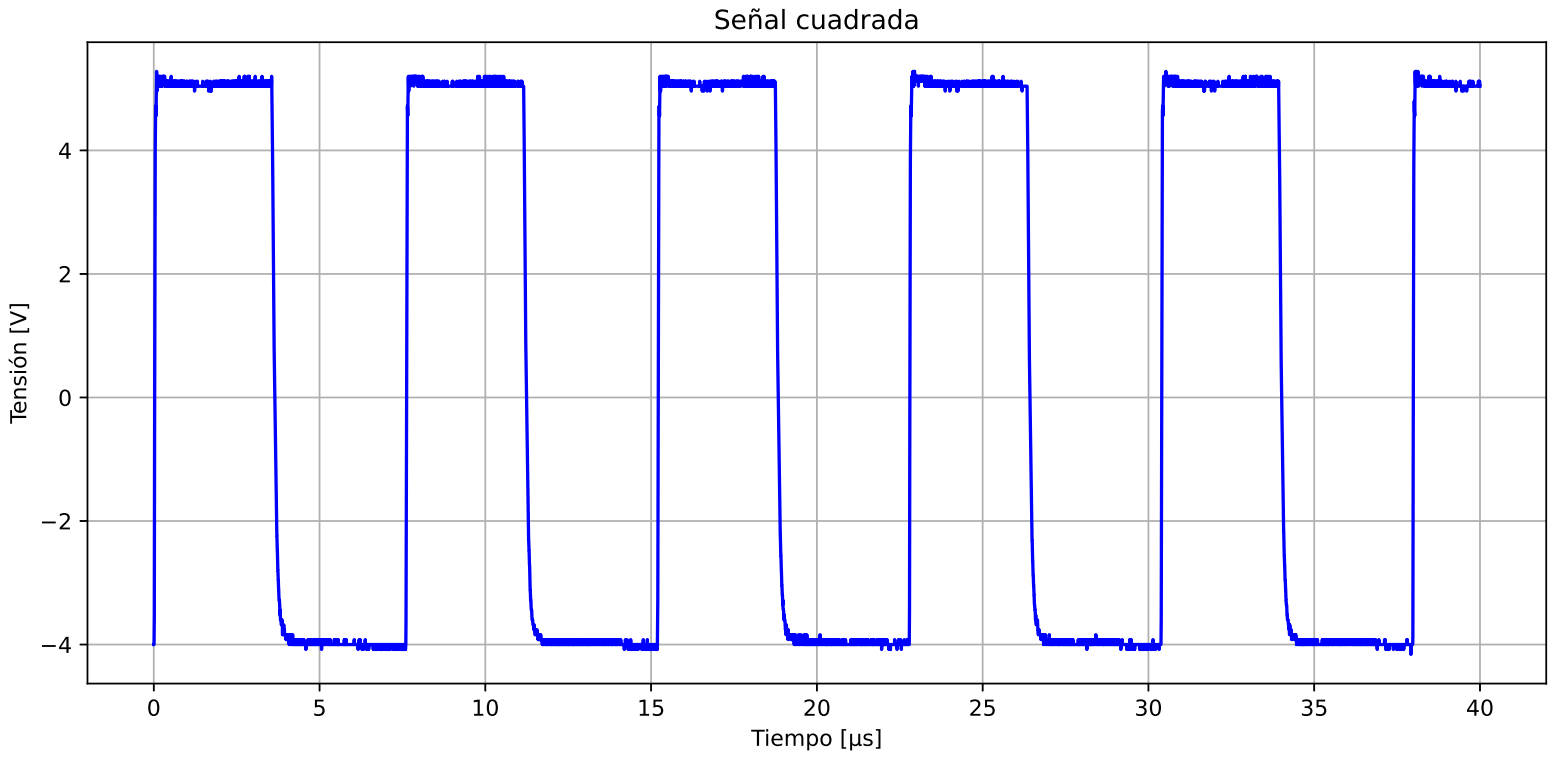
[picture p169: page 1]
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
