fadelrio/Taller-de-circuitos/carga_electronica/MK1.asc

Q1: npn; BC547B
Q2: npn; BC547B
Q3: npn; BC547C
Q4: npn; BC547C
Q5: npn; BC547C
Q6: pnp; BC557C
Q7: pnp; BC557C
Q8: pnp; Qmje2955t
Q9: npn; BC547C
Q10: npn; BC547C
Q11: npn; BC547C
Q12: npn; BC547B
Q13: npn; BC547B
Qmje1: pnp
Qmje2: pnp
Qmje3: pnp
Qmje2955t: pnp
R1: res; 2.4
R2: res; 1
R3: res; 2k
R4: res; 2k
R5: res; 1k
R6: res; 1880
R7: res; 1.8k
R8: res; 1
R9: res; 0.00001
R10: res; 2.4
Rs1: res; 2.4
U1: opamp2; LM741
U2: opamp2; LM741
U3: opamp2; LM741
U4: opamp2; LM741
V1: voltage; 5
V2: voltage; 12
V3: voltage; 12
V4: voltage; PWL REPEAT FOREVER (0 0 2 3.6 4 0) ENDREPEAT
V5: voltage; 5
V6: voltage; PWL REPEAT FOREVER (0 0 2 3.6 4 0) ENDREPEAT
V7: voltage; 2.5
V8: voltage; 2.5
V9: voltage; 5
V10: voltage; PWL REPEAT FOREVER (0 0 5 8 5.001 0) ENDREPEAT
V11: voltage; PWL REPEAT FOREVER (0 0 2 3.6 4 0) ENDREPEAT
VIN1: voltage; 9.5
Named nets: 0, v++, v--, Vo
.include lm741.lib
.lib mje2955.lib
.tran 0 5 0 .1
