fadelrio/Taller-de-circuitos/quinto_check/fuente_conmutada_1.asc

C1: cap; 47µ
C2: cap; 100µ
C3: cap; 10n
C4: cap; 180p
C5: cap; 12n
C6: cap; 220p
C7: cap; 12n
D1: diode; 1N4148
L1: ind; 300µ
M3: nmos; IRFZ44N
M4: nmos; IRFZ44N
R1: res; 10
R2: res; 10
R3: res; 10
R4: res; 1
R5: res; 10k
R6: res; 10k
R7: res; 820
R8: res; 15k
R9: res; 15k
R10: res; 91k
R11: res; 39k
R12: res; 820
R13: res; 1.8k
U1: IR2104
U3: ADTL082
U4: opamp2; LM393A
U5: opamp2; LM393A
U6: ADTL082
V1: voltage; 4.5
V2: voltage; {Vin}
V3: voltage; 4.75
V4: voltage; 9
V5: voltage; 4.5
Named nets: 0, Vo, Vpulse, Vcc, Vs, Vb, Vlo, Vho, Triang
.tran 5m
;step param Vin 12 30 .25
.op
.param Vin=12
.include IR2104.lib
.options cshunt=1e-15
.options abstol=1e-10
.options gmin=1e-10
;inc IR2104.asy
.inc LM393A.lib
