fadelrio/Taller-de-circuitos/quinto_check/oscilador.asc

C1: cap; 220p
C2: cap; 1n
R1: res; 91k
R2: res; 27k
R3: res; 39k
R4: res; 820
R5: res; 820
R7: res; 3.8k
U1: opamp2; LM393A
U2: opamp2; LM393A
U3: ADTL082
U5: ADTL082
V1: voltage; 6
V2: voltage; PULSE(1 11 0 1n 1n 3.84u 7.69u)
V3: voltage; 3
V4: voltage; 9
V5: voltage; 4.5
Named nets: 0, Vcc
.tran 0 0.0001 0 500n
.include LM393A.lib
