fadelrio/Taller-de-circuitos/cuarto_check/fuente_conmutada_1.asc

C1: cap; 47µ
C2: cap; 100µ
C3: cap; 10n
D1: diode; 1N4148
L1: ind; 300µ
M3: nmos; IRFZ44N
M4: nmos; IRFZ44N
R1: res; 10
R2: res; 10
R3: res; 10
R4: res; 1
U1: IR2104
V1: voltage; PULSE(24 0 .1p .1p .1p 4.3u 7.69u)
V2: voltage; {Vin}
Named nets: 0, Vo, Vpulse, Vcc, Vs, Vb, Vlo, Vho
.tran 0 10m 0 1u
;step param Vin 12 30 .25
.op
.param Vin=24
.include IR2104.lib
.options cshunt=1e-15
.options abstol=1e-10
.options gmin=1e-10
