fadelrio/Taller-de-circuitos/primer_check/primer_check_7.asc

Q1: npn; BC547C
Q2: npn; BC547C
Q3: npn; BC547C
Q4: pnp; BC557C
Q5: pnp; BC557C
Q6: pnp; Qmje2955t
Q7: npn; BC547C
Q8: npn; BC547C
R1: res; 1.8k
R2: res; 2k
R3: res; 2k
R4: res; 1k
R5: res; 1880
RL1: res; {R_L}
Rs: res; 2.4
V1: voltage; 2.5
VIN1: voltage; 9.5
Named nets: 0, Vo, B, E, Vref, Vin
.param R_L 1000
.lib mje2955.lib
.dc VIN 3 24 .5
.step dec param R_L 10Meg .001 500
.op
Mido regulacion de linea
.meas DC Vo1rl FIND V(Vo) AT=12
.meas DC Vo2rl FIND V(Vo) AT=24
.meas DC RegLin PARAM ((Vo2rl-Vo1rl)/12)
Mido regulacion de carga
.meas OP Vo1rc FIND V(Vo) AT 100
.meas OP Vo2rc FIND V(Vo) AT 5
.meas OP Io1rc FIND I(RL) AT 100
.meas OP Io2rc FIND I(RL) AT 5
Mido eficiencia
-100*((V(vo)*I(RL))/(V(VIN)*I(VIN)))
.tran 0 10 5 .5
