fadelrio/Taller-de-circuitos/segundo_check/segundo_check_2.asc

C1: cap; {C_L}
C2: cap; 1
C3: cap; {C_c}
C4: cap; {C_L}
C5: cap; 1G
C6: cap; {C_c}
C7: cap; {C_L}
C8: cap; {C_L}
C9: cap; 1G
C10: cap; 1
C11: cap; {C_L}
C12: cap; {C_c}
erre1: res; 100
erre2: res; 100
erre: res; 100
I1: current; ""; AC 1
I2: current; ""; AC 1
L1: ind; 1G
L2: ind; 1G
L3: ind; 1G
L4: ind; 1G
Q1: npn; BC547C
Q2: npn; BC547C
Q3: npn; BC547C
Q4: pnp; BC557C
Q5: pnp; BC557C
Q6: pnp; Qmje2955t
Q7: npn; BC547C
Q8: npn; BC547C
Q9: npn; BC547C
Q10: npn; BC547C
Q11: npn; BC547C
Q12: npn; BC547C
Q13: pnp; BC557C
Q14: pnp; BC557C
Q15: pnp; Qmje2955t
Q16: npn; BC547C
Q17: npn; BC547C
Q18: npn; BC547C
Q19: npn; BC547C
Q20: npn; BC547C
Q21: npn; BC547C
Q22: pnp; BC557C
Q23: pnp; BC557C
Q24: pnp; Qmje2955t
Q25: npn; BC547C
Q26: npn; BC547C
Q27: npn; BC547C
Q28: npn; BC547C
Q29: npn; BC547C
Q30: npn; BC547C
Q31: pnp; BC557C
Q32: pnp; BC557C
Q33: pnp; Qmje2955t
Q34: npn; BC547C
Q35: npn; BC547C
Q36: npn; BC547C
Q37: npn; BC547C
Q38: npn; BC547C
Q39: npn; BC547C
Q40: pnp; BC557C
Q41: pnp; BC557C
Q42: pnp; Qmje2955t
Q43: npn; BC547C
Q44: npn; BC547C
Q45: npn; BC547C
R1: res; 2k
R2: res; 2k
R3: res; 1k
R4: res; 1880
R5: res; 1.8k
R6: res; 2k
R7: res; 2k
R8: res; 1k
R9: res; 1880
R10: res; 1.8k
R11: res; 2k
R12: res; 2k
R13: res; 1k
R14: res; 1880
R15: res; 1.8k
R16: res; 2k
R17: res; 2k
R18: res; 1k
R19: res; 1880
R20: res; 1.8k
R21: res; 2k
R22: res; 2k
R23: res; 1k
R24: res; 1880
R25: res; 1.8k
RL1: res; {R_L}
RL2: res; {R_L}
RL3: res; {R_L}
RL4: res; {R_L}
RL5: res; {R_L}
Rs1: res; 2.4
Rs2: res; 2.4
Rs3: res; 2.4
Rs4: res; 2.4
Rs5: res; 2.4
V1: voltage; 2.5
V2: voltage; ""; AC 1
V3: voltage; 2.5
V4: voltage; 2.5
V5: voltage; 2.5
V6: voltage; ""; AC 1
V7: voltage; 2.5
VIN1: voltage; 9.5
VIN2: voltage; 9.5
VIN3: voltage; 9.5
VIN4: voltage; 9.5
VIN5: voltage; 9.5; AC 1
Named nets: 0, B, Vref, Vin, sin_comp_tension, comp_tension, sin_comp_corriente, comp_corriente, frec_vin
.param R_L=10
.lib mje2955.lib
.dc VIN 3 24 .5
;step param R_L 50 3.3333 10
.op
Mido regulacion de linea
.meas DC Vo1rl FIND V(Vo) AT=12
.meas DC Vo2rl FIND V(Vo) AT=24
.meas DC RegLin PARAM ((Vo2rl-Vo1rl)/12)
Mido regulacion de carga
.meas OP Vo1rc FIND V(Vo) AT 100
.meas OP Vo2rc FIND V(Vo) AT 5
.meas OP Io1rc FIND I(RL) AT 100
.meas OP Io2rc FIND I(RL) AT 5
Mido eficiencia
-100*((V(vo)*I(RL))/(V(VIN)*I(VIN)))
.tran 0 10 5 .5
.ac dec 50 1 1000meg
;step param C_L 15u 1u 2.2u
.param C_L=15u
.param C_c=33n
