fadelrio/Taller-de-circuitos/segundo_check/segundo_check_3.asc

C1: cap; {C_L}
C2: cap; {C_L}
C3: cap; {C_c}
C4: cap; {C_c}
C5: cap; {C_L}
C6: cap; {C_c}
C7: cap; {C_L}
C8: cap; {C_L}
C9: cap; {C_L}
I1: current; PULSE(150m 100m 100m 1p 1p 10m 20m 4); load
I2: current; PULSE(150m 100m 100m 1f 1f 1m 2m 4); load
Q1: npn; BC547C
Q2: npn; BC547C
Q3: npn; BC547C
Q4: pnp; BC557C
Q5: pnp; BC557C
Q6: pnp; Qmje2955t
Q7: npn; BC547C
Q8: npn; BC547C
Q9: npn; BC547C
Q10: npn; BC547C
Q11: npn; BC547C
Q12: npn; BC547C
Q13: pnp; BC557C
Q14: pnp; BC557C
Q15: pnp; Qmje2955t
Q16: npn; BC547C
Q17: npn; BC547C
Q18: npn; BC547C
Q19: npn; BC547C
Q20: npn; BC547C
Q21: npn; BC547C
Q22: pnp; BC557C
Q23: pnp; BC557C
Q24: pnp; Qmje2955t
Q25: npn; BC547C
Q26: npn; BC547C
Q27: npn; BC547C
Q28: npn; BC547C
Q29: npn; BC547C
Q30: npn; BC547C
Q31: pnp; BC557C
Q32: pnp; BC557C
Q33: pnp; Qmje2955t
Q34: npn; BC547C
Q35: npn; BC547C
Q36: npn; BC547C
Q37: npn; BC547C
Q38: npn; BC547C
Q39: npn; BC547C
Q40: pnp; BC557C
Q41: pnp; BC557C
Q42: pnp; Qmje2955t
Q43: npn; BC547C
Q44: npn; BC547C
Q45: npn; BC547C
Q46: npn; BC547C
Q47: npn; BC547C
Q48: npn; BC547C
Q49: pnp; BC557C
Q50: pnp; BC557C
Q51: pnp; Qmje2955t
Q52: npn; BC547C
Q53: npn; BC547C
Q54: npn; BC547C
R1: res; 2k
R2: res; 2k
R3: res; 1k
R4: res; 1880
R5: res; 1.8k
R6: res; 100
R7: res; 2k
R8: res; 2k
R9: res; 1k
R10: res; 1880
R11: res; 1.8k
R12: res; 100
R13: res; 2k
R14: res; 2k
R15: res; 1k
R16: res; 1880
R17: res; 1.8k
R18: res; 100
R19: res; 2k
R20: res; 2k
R21: res; 1k
R22: res; 1880
R23: res; 1.8k
R24: res; 2k
R25: res; 2k
R26: res; 1k
R27: res; 1880
R28: res; 1.8k
R29: res; 2k
R30: res; 2k
R31: res; 1k
R32: res; 1880
R33: res; 1.8k
RL1: res; {R_L}
RL2: res; {R_L}
RL3: res; {R_L}
RL: res; {R_L}
Rs1: res; 2.4
Rs2: res; 2.4
Rs3: res; 2.4
Rs4: res; 2.4
Rs5: res; 2.4
Rs6: res; 2.4
V1: voltage; PULSE(2.5 2.6 5m 1p 1p 10ms 20ms)
V2: voltage; 2.5
V3: voltage; 2.5
V4: voltage; 2.5
V5: voltage; 2.5
V6: voltage; 2.5
V7: voltage; 2.5
V8: voltage; 2.5
V9: voltage; 2.5
V10: voltage; PULSE(2.5 2.6 100m 1f 1f 1m 2m 4)
VIN1: voltage; 9.5
VIN2: voltage; PULSE(9.5 10 100m 1f 1f 10m 20m 4)
VIN3: voltage; 9.5
VIN4: voltage; PULSE(9.5 10 100m 1f 1f 1m 2m 4)
VIN5: voltage; 9.5
VIN6: voltage; 9.5
Named nets: 0, B, Vref, Vin, t
.param R_L=25
.lib mje2955.lib
.dc VIN 3 24 .5
;step param R_L 50 3.3333 10
.op
Mido regulacion de linea
.meas DC Vo1rl FIND V(Vo) AT=12
.meas DC Vo2rl FIND V(Vo) AT=24
.meas DC RegLin PARAM ((Vo2rl-Vo1rl)/12)
Mido regulacion de carga
.meas OP Vo1rc FIND V(Vo) AT 100
.meas OP Vo2rc FIND V(Vo) AT 5
.meas OP Io1rc FIND I(RL) AT 100
.meas OP Io2rc FIND I(RL) AT 5
Mido eficiencia
-100*((V(vo)*I(RL))/(V(VIN)*I(VIN)))
.tran 0 1.2 .8 1u
.ac dec 50 1 1000meg
;step param C_L 15u 1u 2.2u
.param C_L=15u
.lib mje2955.lib
.dc VIN 3 24 .5
;step param R_L 50 3.3333 30
.op
.tran 0 105m 99.9998m 500n
.ac dec 50 1 1000meg
;step param C_L 15u 1u 7.5u
.lib mje2955.lib
.dc VIN 3 24 .5
;step param R_L 50 3.3333 30
.op
.ac dec 50 1 1000meg
;step param C_L 15u 1u 7.5u
.param C_c=33n
.lib mje2955.lib
.dc VIN 3 24 .5
;step param R_L 50 3.3333 30
.op
.ac dec 50 1 1000meg
;step param C_L 15u 1u 7.5u
.lib mje2955.lib
.dc VIN 3 24 .5
;step param R_L 50 3.3333 30
.op
.ac dec 50 1 1000meg
;step param C_L 15u 1u 7.5u
