fadelrio/Taller-de-circuitos/primer_check/primer_check.asc

C1: cap; 1
L1: ind; 100G
Q1: npn; Qmje3055t
Q2: npn; BC547C
Q3: npn; Qmje3055t
Q4: npn; BC547C
R1: res; 500
R2: res; 500
Rf1: res; 2k
Rf2: res; 3k
Rf3: res; 3k
Rf4: res; 2k
RL1: res; {R_L}
RL: res; {R_L}
V1: voltage; 1.3
V2: voltage; 1.3
V3: voltage; ""; AC 1
VIN1: voltage; 10
VIN: voltage; 10
Named nets: 0, vo, vo1
.param R_L 100
;step param R_L 100 .001 .5
.lib mje3055.lib
.op
.dc VIN 0 30 .1
Mido regulacion de linea
.meas DC Vo1rl FIND V(Vo) AT=12
.meas DC Vo2rl FIND V(Vo) AT=24
.meas DC RegLin PARAM ((Vo2rl-Vo1rl)/12)
Mido regulacion de carga
.meas OP Vo1rc FIND V(Vo) AT 100
.meas OP Vo2rc FIND V(Vo) AT 5
.meas OP Io1rc FIND I(RL) AT 100
.meas OP Io2rc FIND I(RL) AT 5
Mido eficiencia
-100*((V(vo)*I(RL))/(V(VIN)*I(VIN)))
.ac dec 20 .001 1G
