fadelrio/Taller-de-circuitos/primer_check/primer_check_2.asc

C1: cap; 1
C2: cap; 1
L1: ind; 1G
L2: ind; 1G
Q1: npn; BC547C
Q2: npn; BC547C
Q3: npn; BC547C
Q4: pnp; BC557C
Q5: pnp; BC557C
Q6: pnp; Qmje2955t
Q7: npn; BC547C
Q8: npn; BC547C
Q9: npn; BC547C
Q10: pnp; BC557C
Q11: pnp; BC557C
Q12: pnp; Qmje2955t
Q13: npn; BC547C
Q14: npn; BC547C
Q15: npn; BC547C
Q16: pnp; BC557C
Q17: pnp; BC557C
Q18: pnp; Qmje2955t
R1: res; 1.3k
R2: res; 1.3k
R3: res; 3k
R4: res; 2k
R5: res; 3k
R6: res; 2k
R7: res; 1.3k
R8: res; 3k
R9: res; 2k
RL1: res; {R_L}
RL2: res; {R_L}
RL: res; {R_L}
V1: voltage; 2
V2: voltage; ""; AC 1
V3: voltage; 2
V4: voltage; ""; AC 1
V5: voltage; 2
VIN1: voltage; 10
VIN2: voltage; 10
VIN: voltage; 10
Named nets: 0, Vo, Vo1, Vo2
.param R_L 1000
.lib mje2955.lib
.dc VIN 0 30 .1
;step param R_L 100 .001 .5
.op
Mido regulacion de linea
.meas DC Vo1rl FIND V(Vo) AT=12
.meas DC Vo2rl FIND V(Vo) AT=24
.meas DC RegLin PARAM ((Vo2rl-Vo1rl)/12)
Mido regulacion de carga
.meas OP Vo1rc FIND V(Vo) AT 100
.meas OP Vo2rc FIND V(Vo) AT 5
.meas OP Io1rc FIND I(RL) AT 100
.meas OP Io2rc FIND I(RL) AT 5
Mido eficiencia
-100*((V(vo)*I(RL))/(V(VIN)*I(VIN)))
.ac dec 20 .1 1meg
.tran 0 10 5 .5
