fadelrio/Taller-de-circuitos/primer_check/primer_check_6.asc

Q1: npn; BC547C
Q2: npn; BC547C
Q3: npn; BC547C
Q4: pnp; BC557C
Q5: pnp; BC557C
Q6: pnp; Qmje2955t
Q7: pnp; BC557C
Q8: npn; BC547C
Q9: npn; BC547C
R1: res; 1.3k
R2: res; 3k
R3: res; 2k
R4: res; 1.3k
R5: res; 100
R6: res; 2.4
R7: res; 1k
R8: res; 1880
RL: res; {R_L}
V1: voltage; 2
VIN: voltage; 12
Named nets: 0, Vo, Vref, A, B
.param R_L 1000
.lib mje2955.lib
.dc VIN 3 24 .5
.step param R_L .001 5 .02
.op
Mido regulacion de linea
.meas DC Vo1rl FIND V(Vo) AT=12
.meas DC Vo2rl FIND V(Vo) AT=24
.meas DC RegLin PARAM ((Vo2rl-Vo1rl)/12)
Mido regulacion de carga
.meas OP Vo1rc FIND V(Vo) AT 100
.meas OP Vo2rc FIND V(Vo) AT 5
.meas OP Io1rc FIND I(RL) AT 100
.meas OP Io2rc FIND I(RL) AT 5
Mido eficiencia
-100*((V(vo)*I(RL))/(V(VIN)*I(VIN)))
