fadelrio/Taller-de-circuitos/quinto_check/placa_buck/placa_buck.kicad_pcb

## KiCad design quinto_check/placa_buck/placa_buck.kicad_pcb (2025-12-06)

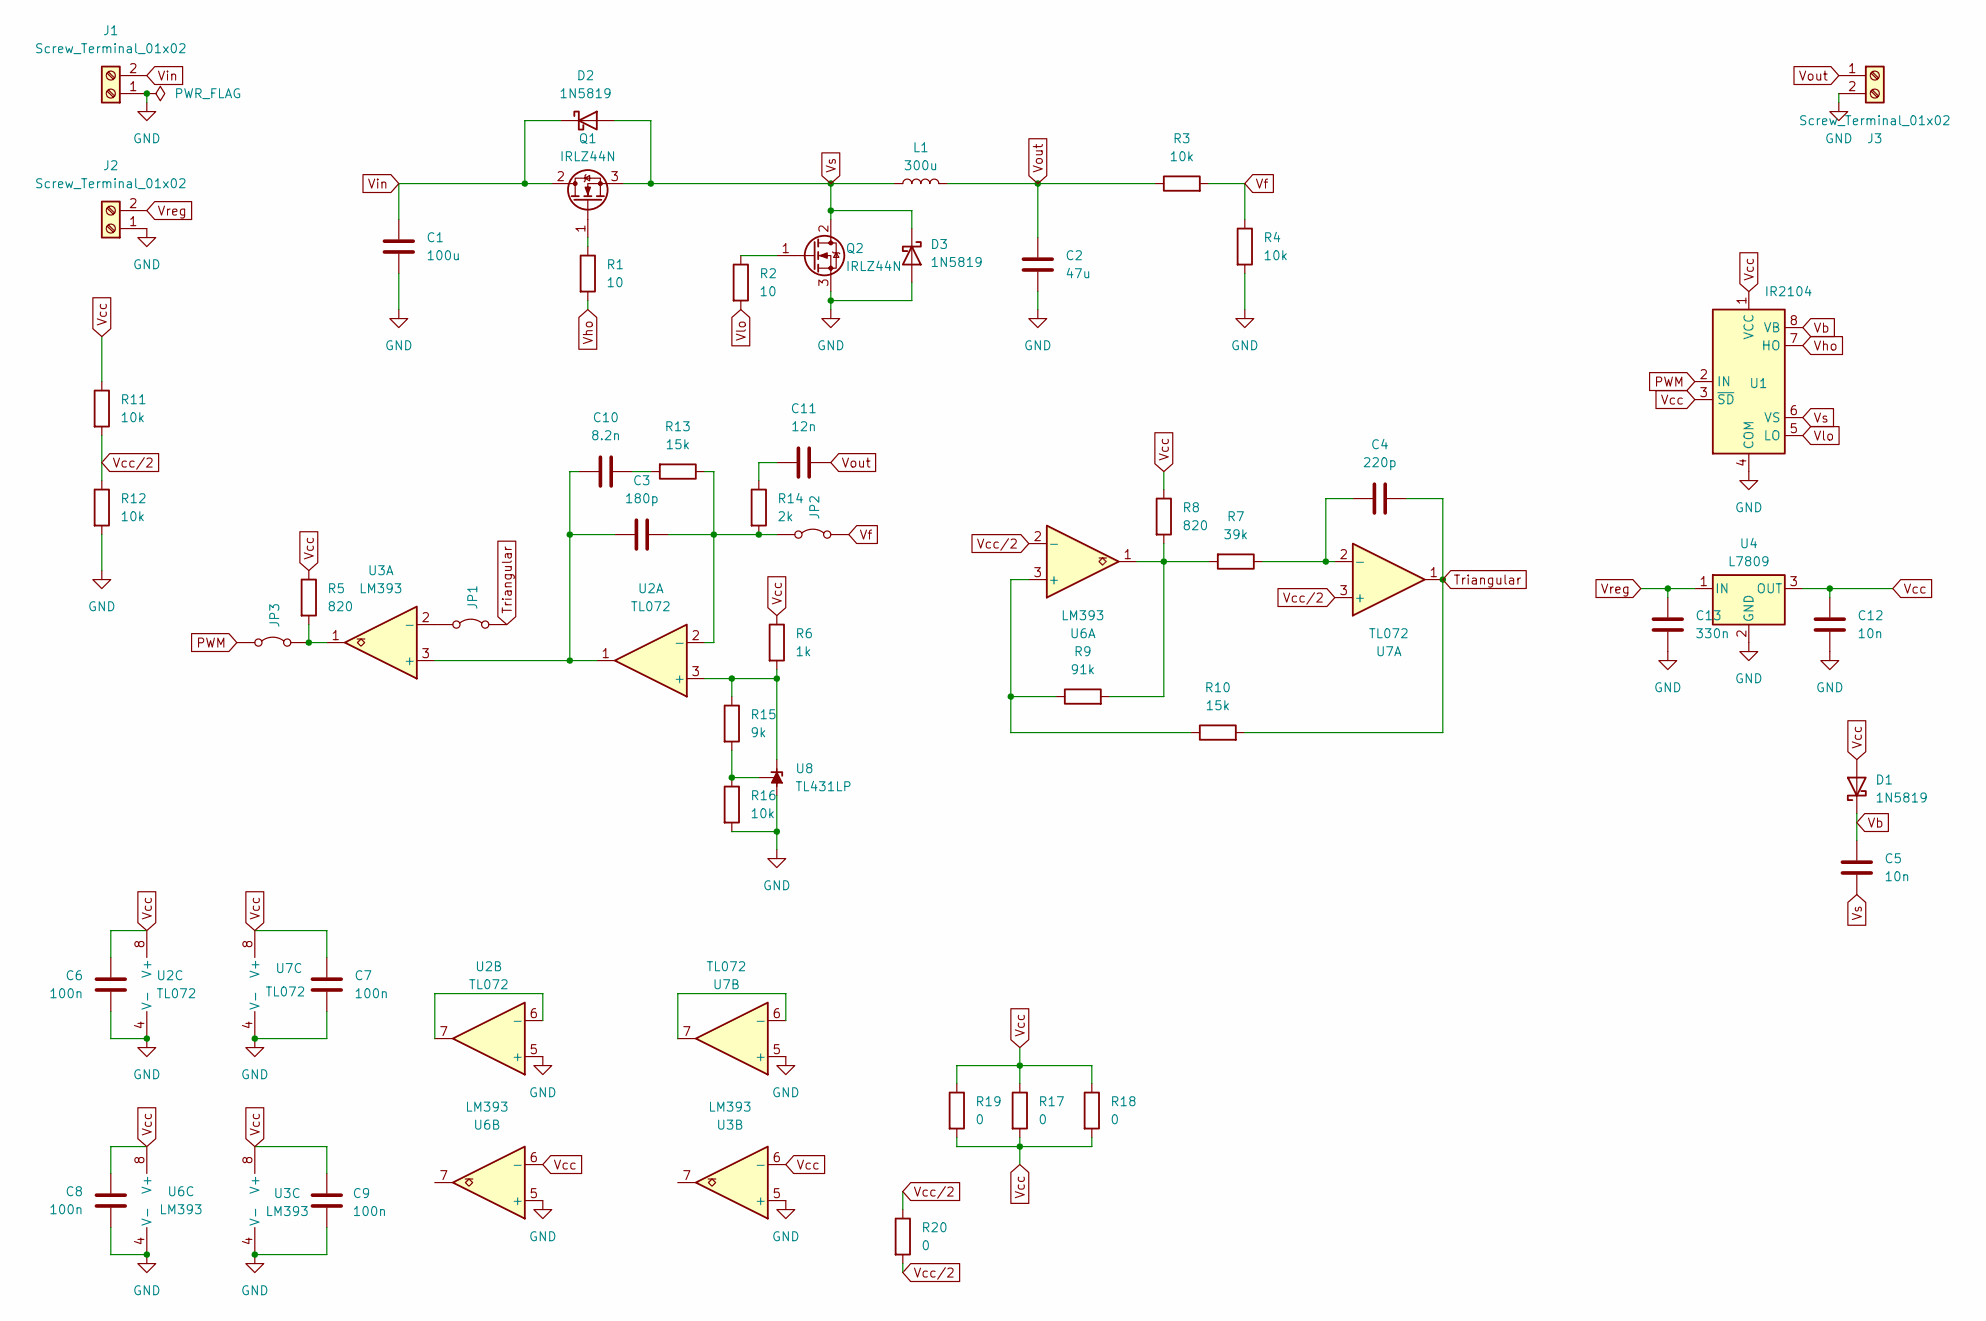
[picture p170: schematic placa_buck.kicad_sch]

Parts:
C1: 100u; CP_Radial_D4.0mm_P2.00mm
C2: 47u; CP_Radial_D4.0mm_P2.00mm
C3: 180p; C_Disc_D4.3mm_W1.9mm_P5.00mm
C4: 220p; C_Disc_D4.3mm_W1.9mm_P5.00mm
C5, C12: 10n; C_Disc_D4.3mm_W1.9mm_P5.00mm
C6, C7, C8, C9: 100n; C_Disc_D4.3mm_W1.9mm_P5.00mm
C10: 8.2n; C_Disc_D4.3mm_W1.9mm_P5.00mm
C11: 12n; C_Disc_D4.3mm_W1.9mm_P5.00mm
C13: 330n; C_Disc_D4.3mm_W1.9mm_P5.00mm
D1, D2, D3: 1N5819; D_DO-41_SOD81_P10.16mm_Horizontal
J1, J2, J3: Screw_Terminal_01x02; Samtec_HPM-02-01-x-S_Straight_1x02_Pitch5.08mm
JP1, JP2, JP3: Jumper_2_Bridged; TestPoint_2Pads_Pitch2.54mm_Drill0.8mm
L1: 300u; Transformer_Breve_TEZ-35x42
Q1, Q2: IRLZ44N; TO-220-3_Vertical
R1, R2: 10; R_Axial_DIN0207_L6.3mm_D2.5mm_P10.16mm_Horizontal
R3, R4, R11, R12, R16: 10k; R_Axial_DIN0207_L6.3mm_D2.5mm_P10.16mm_Horizontal
R5, R8: 820; R_Axial_DIN0207_L6.3mm_D2.5mm_P10.16mm_Horizontal
R6: 1k; R_Axial_DIN0207_L6.3mm_D2.5mm_P10.16mm_Horizontal
R7: 39k; R_Axial_DIN0207_L6.3mm_D2.5mm_P10.16mm_Horizontal
R9: 91k; R_Axial_DIN0207_L6.3mm_D2.5mm_P10.16mm_Horizontal
R10, R13: 15k; R_Axial_DIN0207_L6.3mm_D2.5mm_P10.16mm_Horizontal
R14: 2k; R_Axial_DIN0207_L6.3mm_D2.5mm_P10.16mm_Horizontal
R15: 9k; R_Axial_DIN0207_L6.3mm_D2.5mm_P10.16mm_Horizontal
R17, R18, R19, R20: 0; R_Axial_DIN0207_L6.3mm_D2.5mm_P10.16mm_Horizontal
U1: IR2104; DIP-8_W7.62mm_LongPads
U2, U7: TL072; DIP-8_W7.62mm_LongPads
U3, U6: LM393; DIP-8_W7.62mm_LongPads
U4: L7809; TO-220-3_Vertical
U8: TL431LP; TO-92L_Inline_Wide

Connections:
GND: C1.2, C2.2, C6.2, C7.2, C8.2, C9.2, C12.2, C13.2, D3.2 (A), J1.1, J2.1, J3.2, Q2.3 (S), R4.2, R12.2, R16.2, U1.4 (COM), U2.4 (V-), U2.5 (+), U3.4 (V-), U3.5 (+), U4.2 (GND), U6.4 (V-), U6.5 (+), U7.4 (V-), U7.5 (+), U8.2 (A)
unnamed: C10.1, R13.2
unnamed: C11.2, R14.1
unnamed: JP1.1 (A), U3.2 (-)
unnamed: C3.2, JP2.1 (A), R13.1, R14.2, U2.2 (-)
unnamed: JP3.2 (B), R5.2, U3.1
unnamed: Q1.1 (G), R1.1
unnamed: Q2.1 (G), R2.1
unnamed: R7.2, R8.2, R9.2, U6.1
unnamed: R6.2, R15.1, U2.3 (+), U8.3 (K)
unnamed: U2.6 (-), U2.7
unnamed: C3.1, C10.2, U2.1, U3.3 (+)
unnamed: R9.1, R10.1, U6.3 (+)
unnamed: C4.1, R7.1, U7.2 (-)
unnamed: U7.6 (-), U7.7
unnamed: R15.2, R16.1, U8.1 (REF)
PWM: JP3.1 (A), U1.2 (IN)
Triangular: C4.2, JP1.2 (B), R10.2, U7.1
Vb: C5.1, D1.1 (K), U1.8 (VB)
Vcc: C6.1, C7.1, C8.1, C9.1, C12.1, D1.2 (A), R5.1, R6.1, R8.1, R11.1, R17.1, R17.2, R18.1, R18.2, R19.1, R19.2, U1.1 (VCC), U1.3 (~SD), U2.8 (V+), U3.6 (-), U3.8 (V+), U4.3 (OUT), U6.6 (-), U6.8 (V+), U7.8 (V+)
Vcc/2: R11.2, R12.1, R20.1, R20.2, U6.2 (-), U7.3 (+)
Vf: JP2.2 (B), R3.2, R4.1
Vho: R1.2, U1.7 (HO)
Vin: C1.1, D2.1 (K), J1.2, Q1.2 (D)
Vlo: R2.2, U1.5 (LO)
Vout: C2.1, C11.1, J3.1, L1.2, R3.1
Vreg: C13.1, J2.2, U4.1 (IN)
Vs: C5.2, D2.2 (A), D3.1 (K), L1.1, Q1.3 (S), Q2.2 (D), U1.6 (VS)

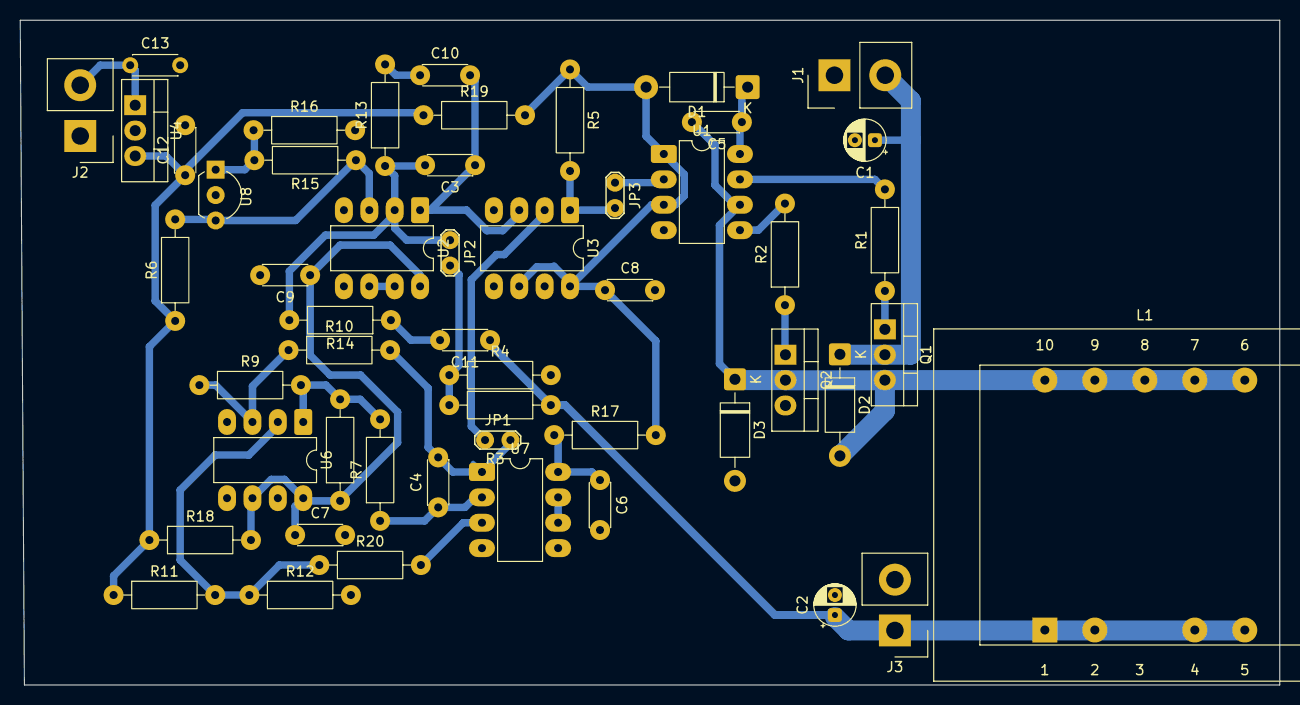
[picture p171: board placa_buck.kicad_pcb from above]

Board: 2 copper layers, 126.0 x 66.5 mm, 52 parts (0 on the bottom side), 28 nets.
