fadelrio/Taller-de-circuitos/cuarto_check/cuarto_check_oscilador/cuarto_check_oscilador.kicad_pcb

## KiCad design cuarto_check/cuarto_check_oscilador/cuarto_check_oscilador.kicad_pcb (2025-11-01)

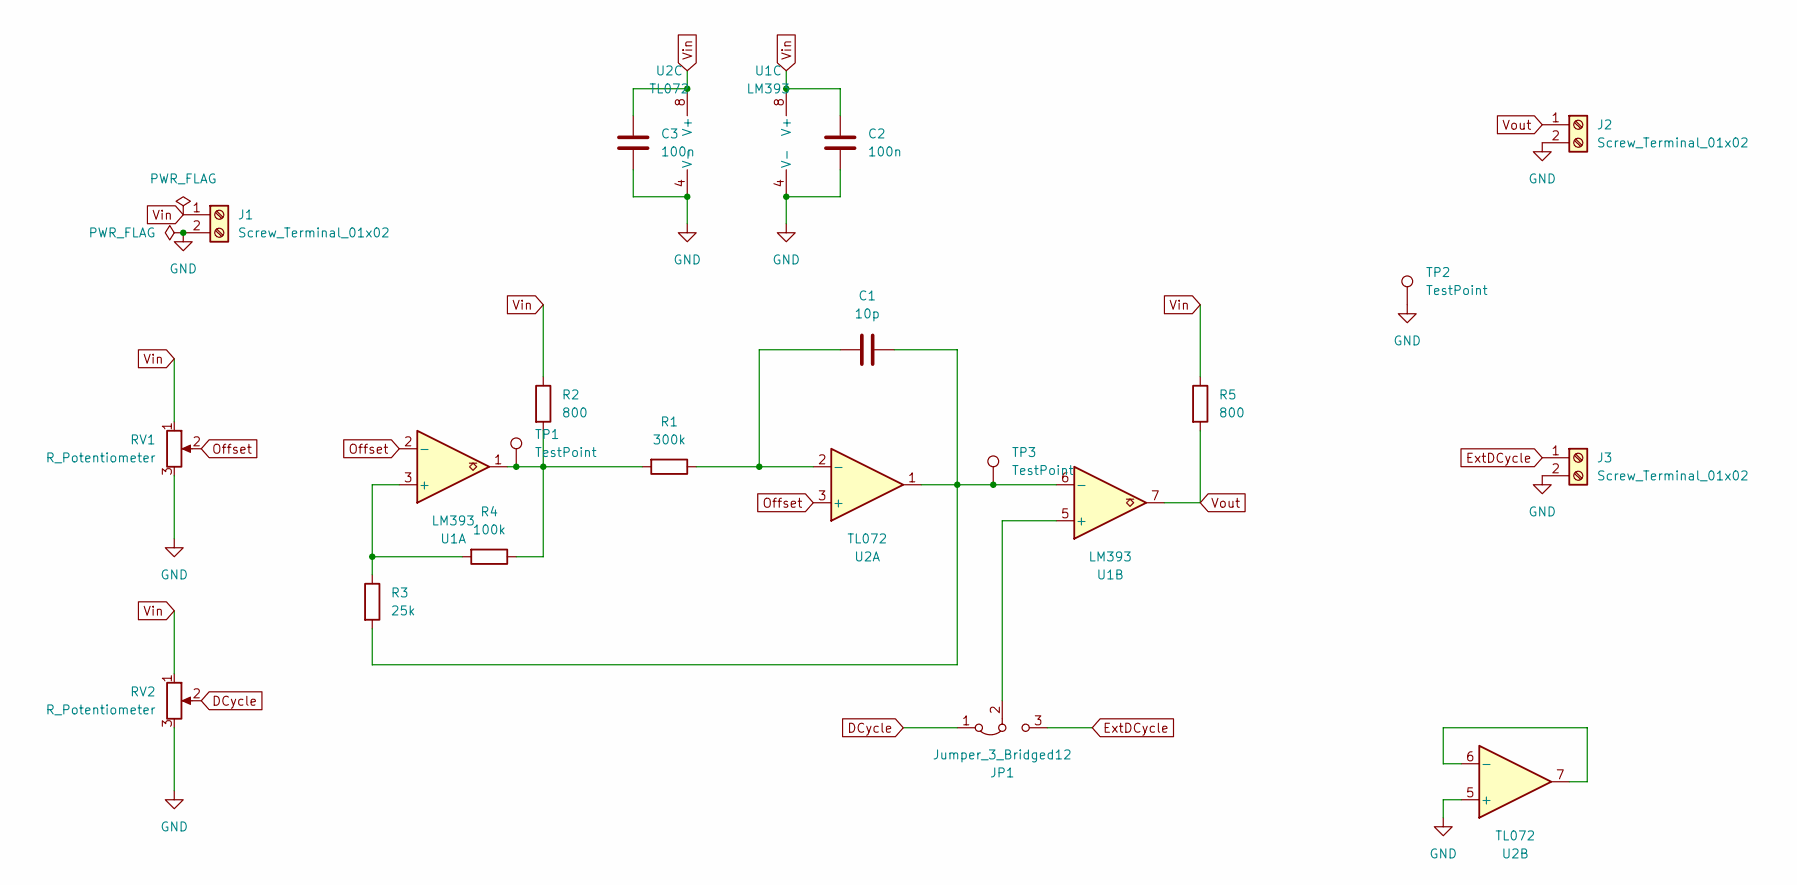
[picture p172: schematic cuarto_check_oscilador.kicad_sch]

Parts:
C1: 10p; C_Disc_D4.3mm_W1.9mm_P5.00mm
C2, C3: 100n; C_Disc_D4.3mm_W1.9mm_P5.00mm
J1, J2, J3: Screw_Terminal_01x02; Samtec_HPM-02-01-x-S_Straight_1x02_Pitch5.08mm
JP1: Jumper_3_Bridged12; PinHeader_1x03_P2.54mm_Vertical
R1: 300k; R_Axial_DIN0207_L6.3mm_D2.5mm_P10.16mm_Horizontal
R2, R5: 800; R_Axial_DIN0207_L6.3mm_D2.5mm_P10.16mm_Horizontal
R3: 25k; R_Axial_DIN0207_L6.3mm_D2.5mm_P10.16mm_Horizontal
R4: 100k; R_Axial_DIN0207_L6.3mm_D2.5mm_P10.16mm_Horizontal
RV1, RV2: R_Potentiometer; Potentiometer_Bourns_3266Y_Vertical
TP1, TP2, TP3: TestPoint; TestPoint_Loop_D2.54mm_Drill1.5mm_Beaded
U1: LM393; DIP-8_W7.62mm_LongPads
U2: TL072; DIP-8_W7.62mm_LongPads

Connections:
DCycle: JP1.1 (A), RV2.2
ExtDCycle: J3.1, JP1.3 (B)
GND: C2.1, C3.1, J1.2, J2.2, J3.2, RV1.3, RV2.3, TP2.1, U1.4 (V-), U2.4 (V-), U2.5 (+)
unnamed: JP1.2 (C), U1.5 (+)
unnamed: R1.2, R2.2, R4.1, TP1.1, U1.1
unnamed: R3.1, R4.2, U1.3 (+)
unnamed: C1.1, R3.2, TP3.1, U1.6 (-), U2.1
unnamed: C1.2, R1.1, U2.2 (-)
unnamed: U2.6 (-), U2.7
Offset: RV1.2, U1.2 (-), U2.3 (+)
Vin: C2.2, C3.2, J1.1, R2.1, R5.1, RV1.1, RV2.1, U1.8 (V+), U2.8 (V+)
Vout: J2.1, R5.2, U1.7

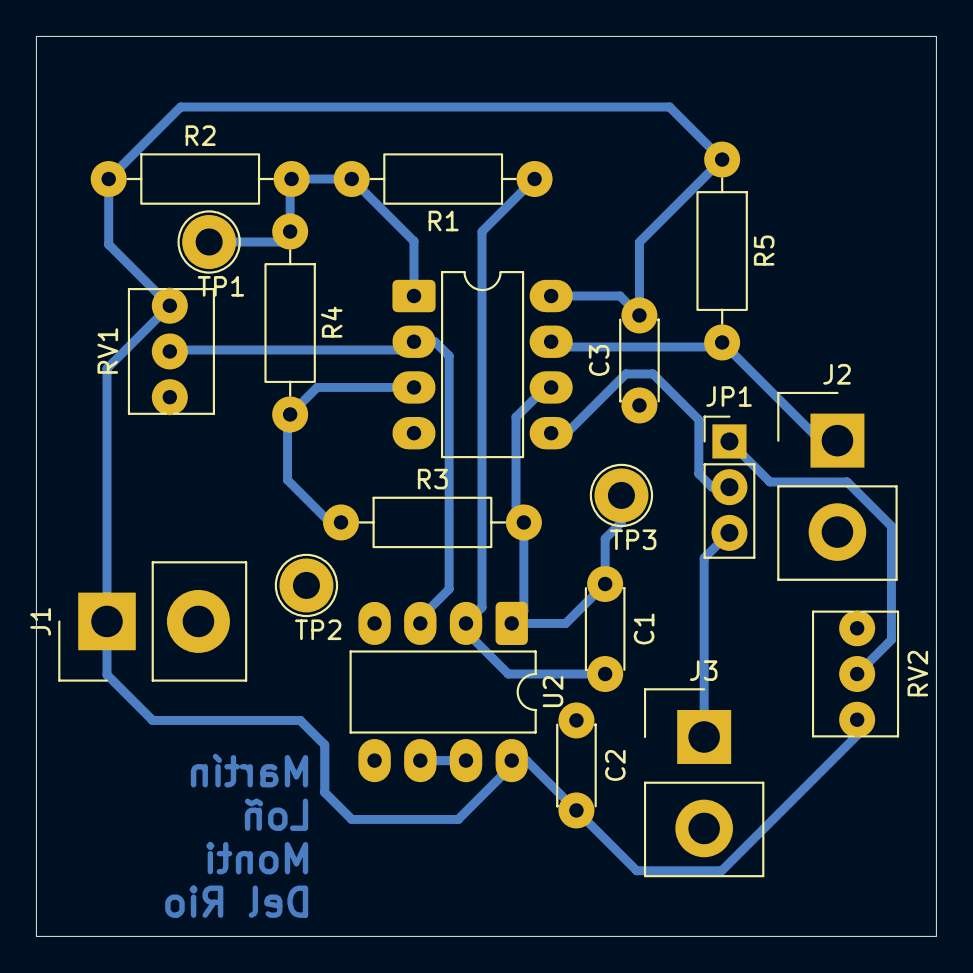
[picture p173: board cuarto_check_oscilador.kicad_pcb from above]

Board: 2 copper layers, 50.0 x 50.0 mm, 19 parts (0 on the bottom side), 12 nets.
