fadelrio/Taller-de-circuitos/segundo_check/esquematico-check2/esquematico-check2.kicad_pcb

## KiCad design segundo_check/esquematico-check2/esquematico-check2.kicad_pcb (2025-10-06)

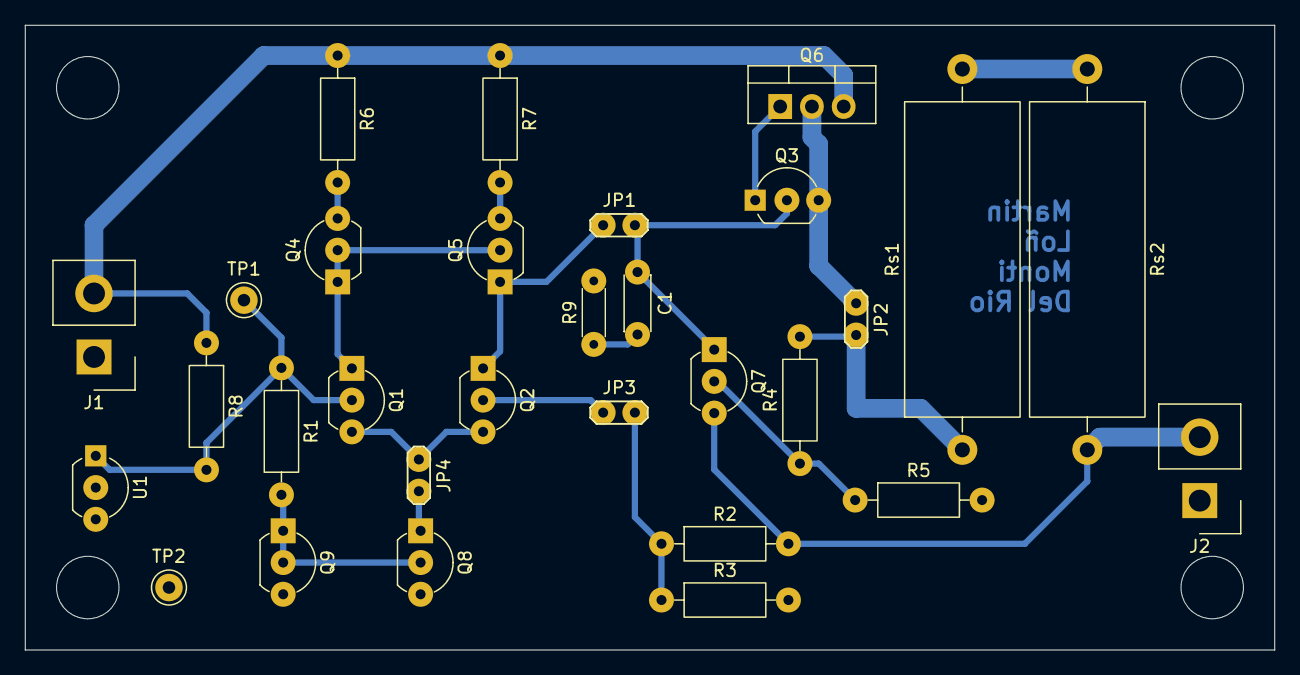
[picture p174: board esquematico-check2.kicad_pcb from above]

Board: 2 copper layers, 100.0 x 50.0 mm, 30 parts (0 on the bottom side), 20 nets.

Parts:
C1: C; C_Disc_D4.3mm_W1.9mm_P5.00mm
J1, J2: Conn_01x02; Samtec_HPM-02-01-x-S_Straight_1x02_Pitch5.08mm
JP1, JP2, JP3, JP4: Jumper_2_Bridged; TestPoint_2Pads_Pitch2.54mm_Drill0.8mm
Q1, Q2, Q3, Q7, Q8, Q9: BC547; TO-92_Inline_Wide
Q4, Q5: BC557; TO-92_Inline_Wide
Q6: MJE2955T; TO-220-3_Vertical
R1: 1.8k; R_Axial_DIN0207_L6.3mm_D2.5mm_P10.16mm_Horizontal
R2, R3: 2K; R_Axial_DIN0207_L6.3mm_D2.5mm_P10.16mm_Horizontal
R4, R8: 1k; R_Axial_DIN0207_L6.3mm_D2.5mm_P10.16mm_Horizontal
R5: 1880; R_Axial_DIN0207_L6.3mm_D2.5mm_P10.16mm_Horizontal
R6, R7: 100; R_Axial_DIN0207_L6.3mm_D2.5mm_P10.16mm_Horizontal
R9: R; R_Axial_DIN0204_L3.6mm_D1.6mm_P5.08mm_Horizontal
Rs1, Rs2: 1.2; R_Axial_Power_L25.0mm_W9.0mm_P30.48mm
TP1, TP2: TestPoint_Probe; TestPoint_Keystone_5000-5004_Miniature
U1: TL431D; TO-92_Inline_Wide

Connections:
GND: J1.1, J2.1, Q8.3 (E), Q9.3 (E), R3.2, R5.2, R9.2, TP2.1, U1.2 (A), U1.3 (A)
unnamed: C1.2, R9.1
unnamed: J1.2, Q6.3 (E), R6.1, R7.1, R8.1
unnamed: J2.2, Q7.3 (E), R2.2, Rs2.2
unnamed: JP1.1 (A), Q2.1 (C), Q5.1 (C)
unnamed: C1.1, JP1.2 (B), Q3.2 (B), Q7.1 (C)
unnamed: JP2.1 (A), Q3.3 (E), Q6.2 (C)
unnamed: JP2.2 (B), R4.2, Rs1.1
unnamed: JP3.1 (A), Q2.2 (B)
unnamed: JP3.2 (B), R2.1, R3.1
unnamed: JP4.1 (A), Q1.3 (E), Q2.3 (E)
unnamed: JP4.2 (B), Q8.1 (C)
unnamed: Q1.2 (B), R1.1, R8.2, TP1.1, U1.1 (K)
unnamed: Q1.1 (C), Q4.1 (C), Q4.2 (B), Q5.2 (B)
unnamed: Q3.1 (C), Q6.1 (B)
unnamed: Q4.3 (E), R6.2
unnamed: Q5.3 (E), R7.2
unnamed: Q7.2 (B), R4.1, R5.1
unnamed: Q8.2 (B), Q9.1 (C), Q9.2 (B), R1.2
unnamed: Rs1.2, Rs2.1
