fadelrio/Taller-de-circuitos/(commit log)

2025-09-08 Algunos graficos de eficiencia
2025-09-09 Soy martu e hice el esquematico de kicad y soy re capa
    [Esquematico-check1.kicad_pcb, Esquematico-check1.kicad_sch]
2025-09-09 esquematico pcb, le falta la resistencia de la ref nomas
    [Esquematico-check1.kicad_sch]
2025-09-11 esquematico chk1 terminado
    [Esquematico-check1.kicad_sch]
2025-09-11 ahora si el esquematico chk1
    [Esquematico-check1.kicad_sch]
2025-09-19 inicio PCB
    [esquematico-check2.kicad_pcb, esquematico-check2.kicad_sch]
2025-09-20 Avances PCB
    [esquematico-check2.kicad_pcb, esquematico-check2.kicad_sch]
2025-10-01 Placa reglin terminada?
    [esquematico-check2.kicad_pcb, esquematico-check2.kicad_sch]
2025-10-01 Post Segundo check
    [segundo_check_comp_bonito.csv, segundo_check_comp_bonito_1u.csv]
2025-10-06 Detalles previos a impresión de la placa
    [esquematico-check2.kicad_pcb]
2025-10-14 Primeras mediciones y graficos tercer check
    [Esquematico-check1.kicad_pcb, Esquematico-check1.kicad_sch, esc_carg.csv]
2025-10-15 Continuacion check 3
    [esc_carg_recortado.csv]
2025-10-17 Cerrando check 3
    [alta.csv, bajja.csv, esc_carg2.csv, esc_carg2_recortado.csv, esc_ent.csv, esc_entdes.csv]
2025-10-30 Inicio PCB oscilador CP4
    [cuarto_check_oscilador.kicad_pcb, cuarto_check_oscilador.kicad_sch]
2025-10-31 Fin? diseño placa oscilador
    [cuarto_check_oscilador.kicad_pcb, cuarto_check_oscilador.kicad_sch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]
2025-11-01 matenme porfa
    [cuarto_check_oscilador.csv, cuarto_check_oscilador.kicad_pcb, cuarto_check_oscilador.kicad_sch]
2025-11-01 A mi también matenme porfa
    [cuarto_check_oscilador.kicad_pcb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]
2025-11-10 Entrega check 4 (faltan cosas)
    [cuadrada.csv, cuadrada2.csv, cuarto_check_oscilador.kicad_sch, triangula2.csv, triangular.csv]
2025-12-01 Ya ni se todo lo q hicimos
    [placa_buck.csv, placa_buck.kicad_pcb, placa_buck.kicad_sch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]
2025-12-06 Entrega de quinto check
    [TP3_carga_dinamica.CSV, gates_mosfets.CSV, nodo_conmutacion.CSV, placa_buck.kicad_pcb, pwm_buck.CSV, ripple_12_10.CSV, ripple_12_82.CSV, ripple_24_10.CSV]
2025-12-10 Espero que sea el ultimo commit
